niruvibes/elec3117proj/tmp/pdfs/designguideline-40.png

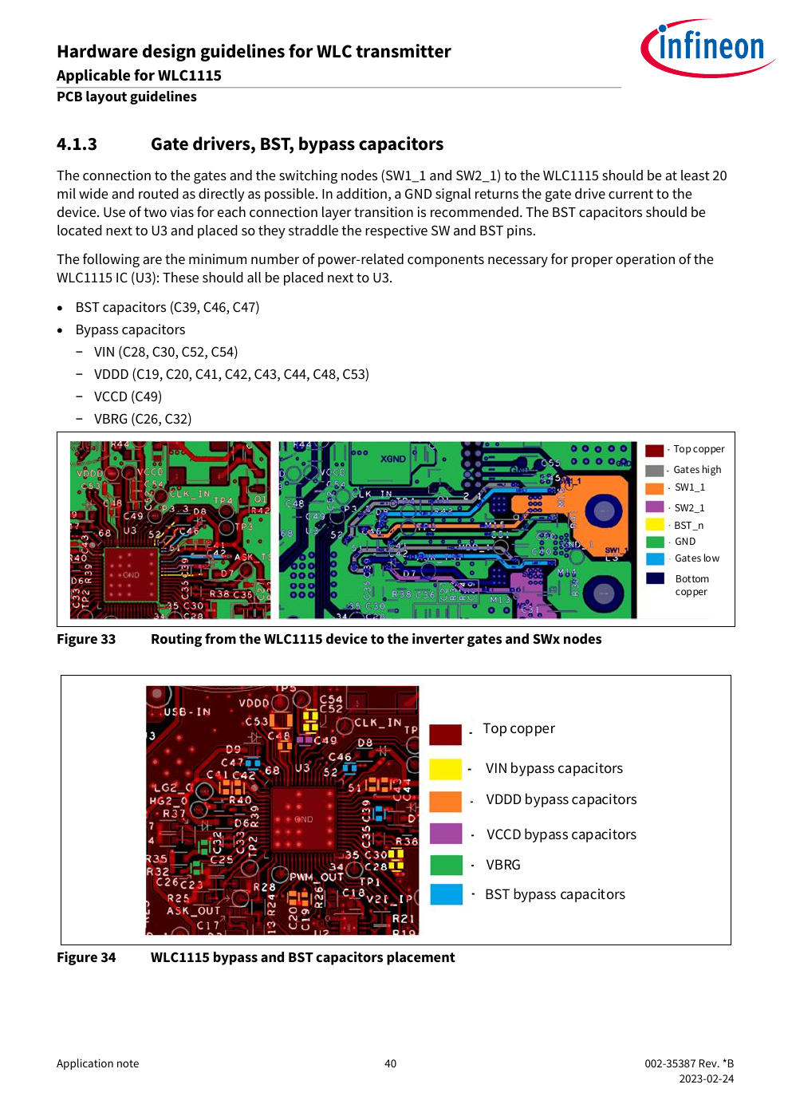
tmp/pdfs/designguideline-40.png
