niruvibes/elec3117proj/tmp/pdfs/guideline-power.jpg

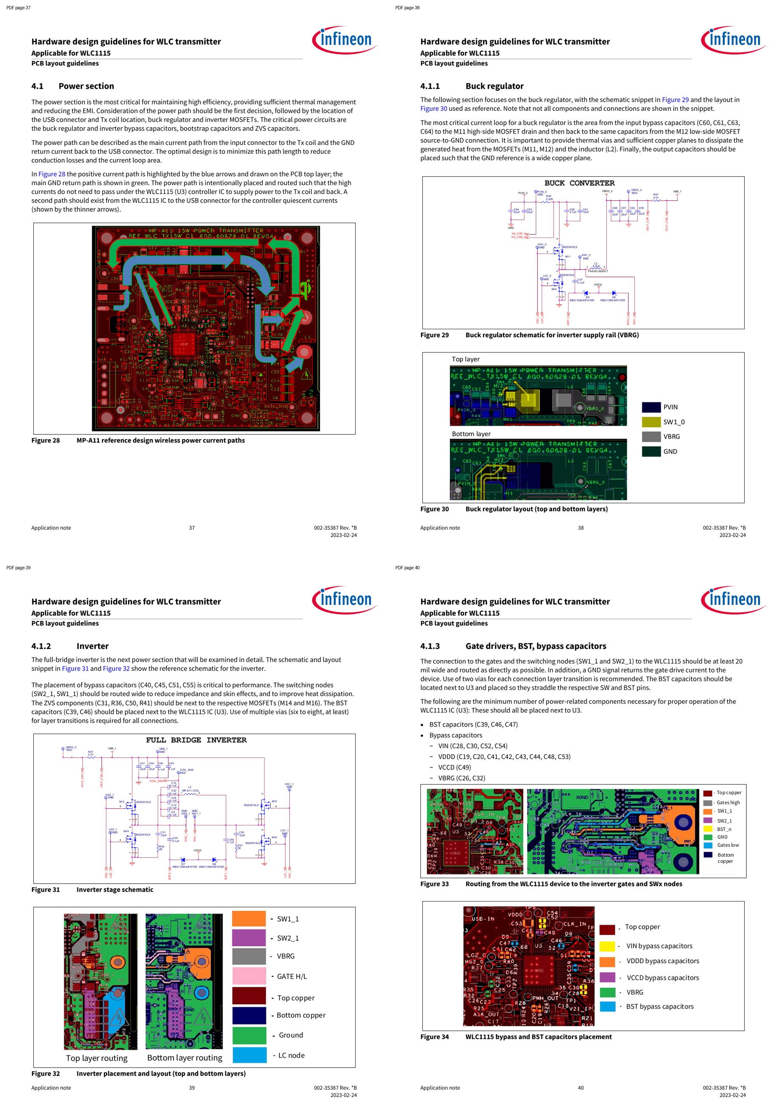
tmp/pdfs/guideline-power.jpg
