niruvibes/elec3117proj/outputs/jlcpcb-upload-clean/JLCPCB_CPL_clean.png

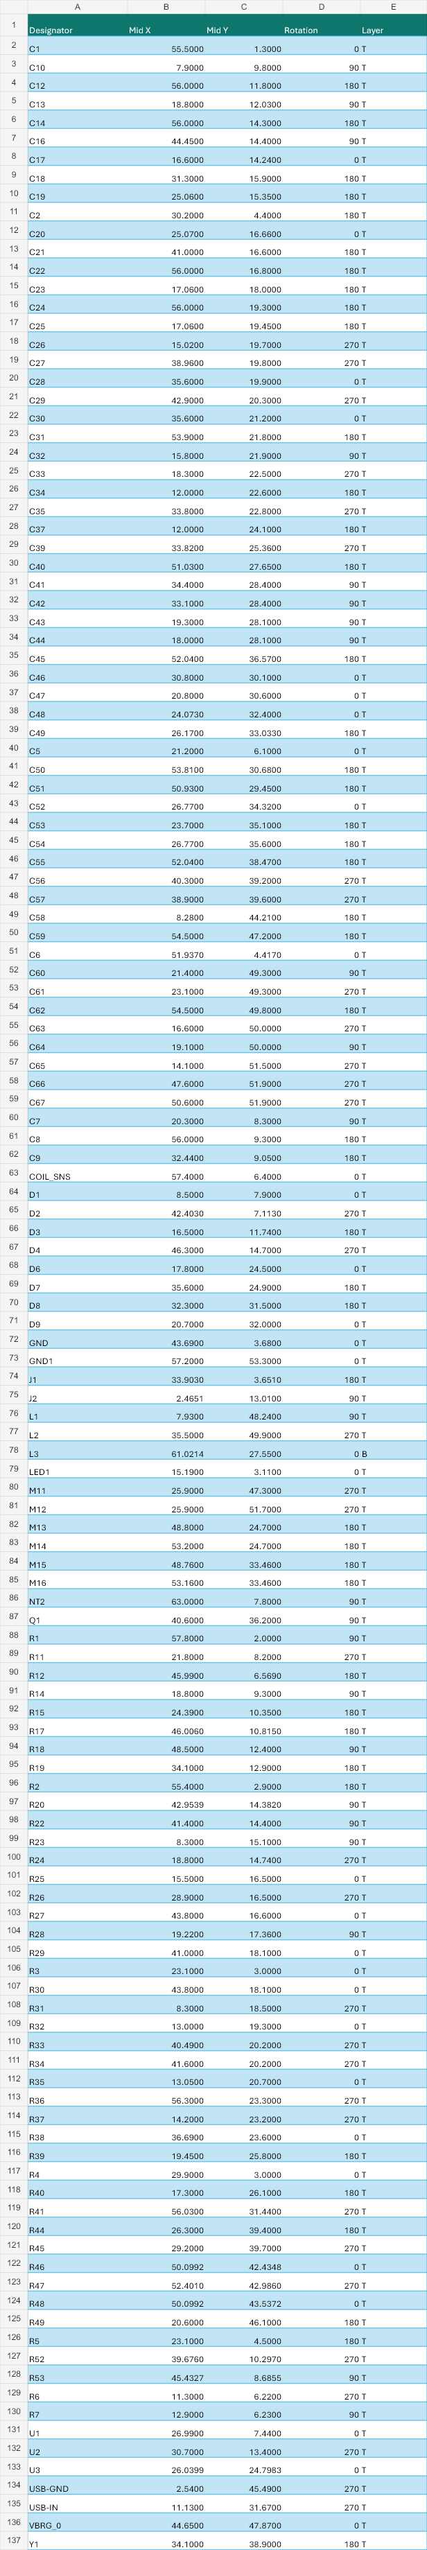
outputs/jlcpcb-upload-clean/JLCPCB_CPL_clean.png
