niruvibes/elec3117proj/outputs/jlcpcb-upload-clean/source_cpl.png

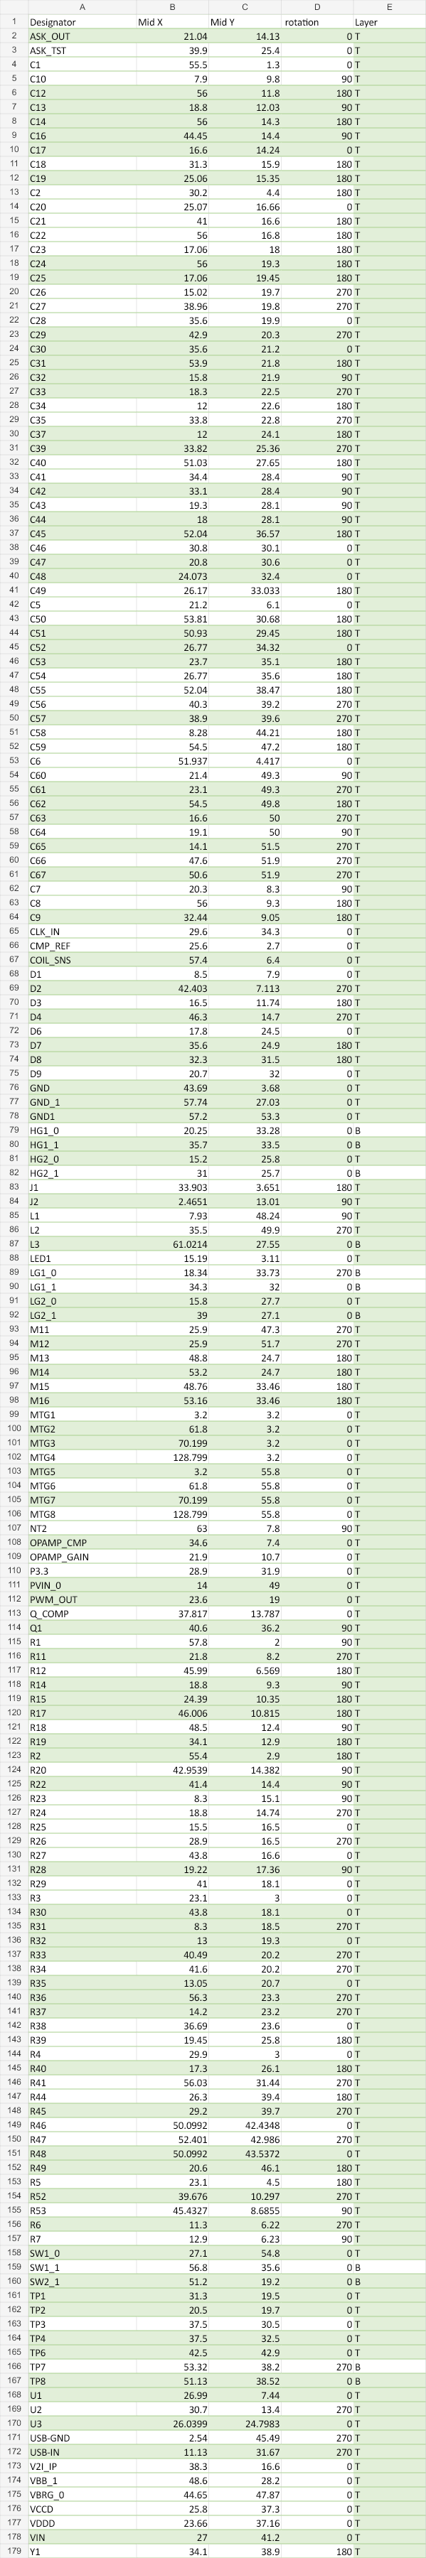
outputs/jlcpcb-upload-clean/source_cpl.png
