niruvibes/elec3117proj/tmp/layout-analysis/final-main-3d.png

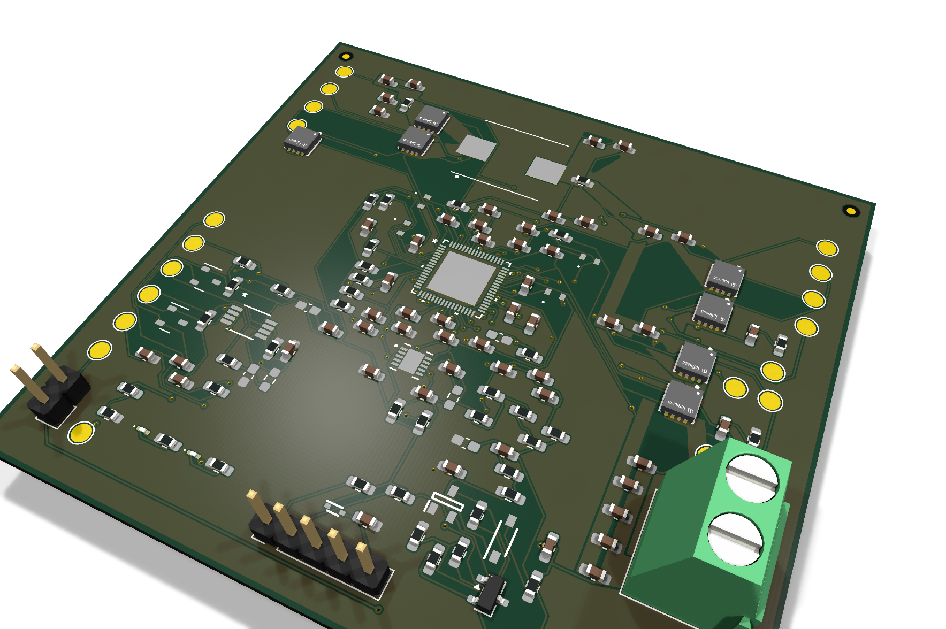
tmp/layout-analysis/final-main-3d.png
