niruvibes/elec3117proj/tmp/layout-analysis/final-main-top.png

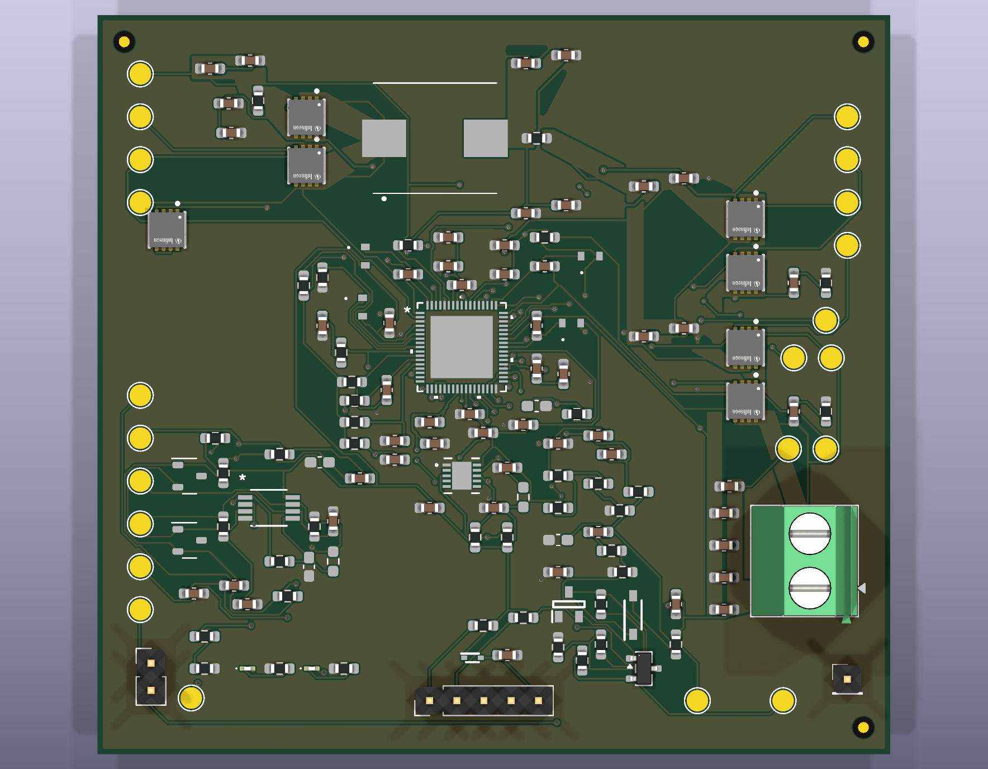
tmp/layout-analysis/final-main-top.png
