niruvibes/elec3117proj/tmp/layout-analysis/placed-3d.png

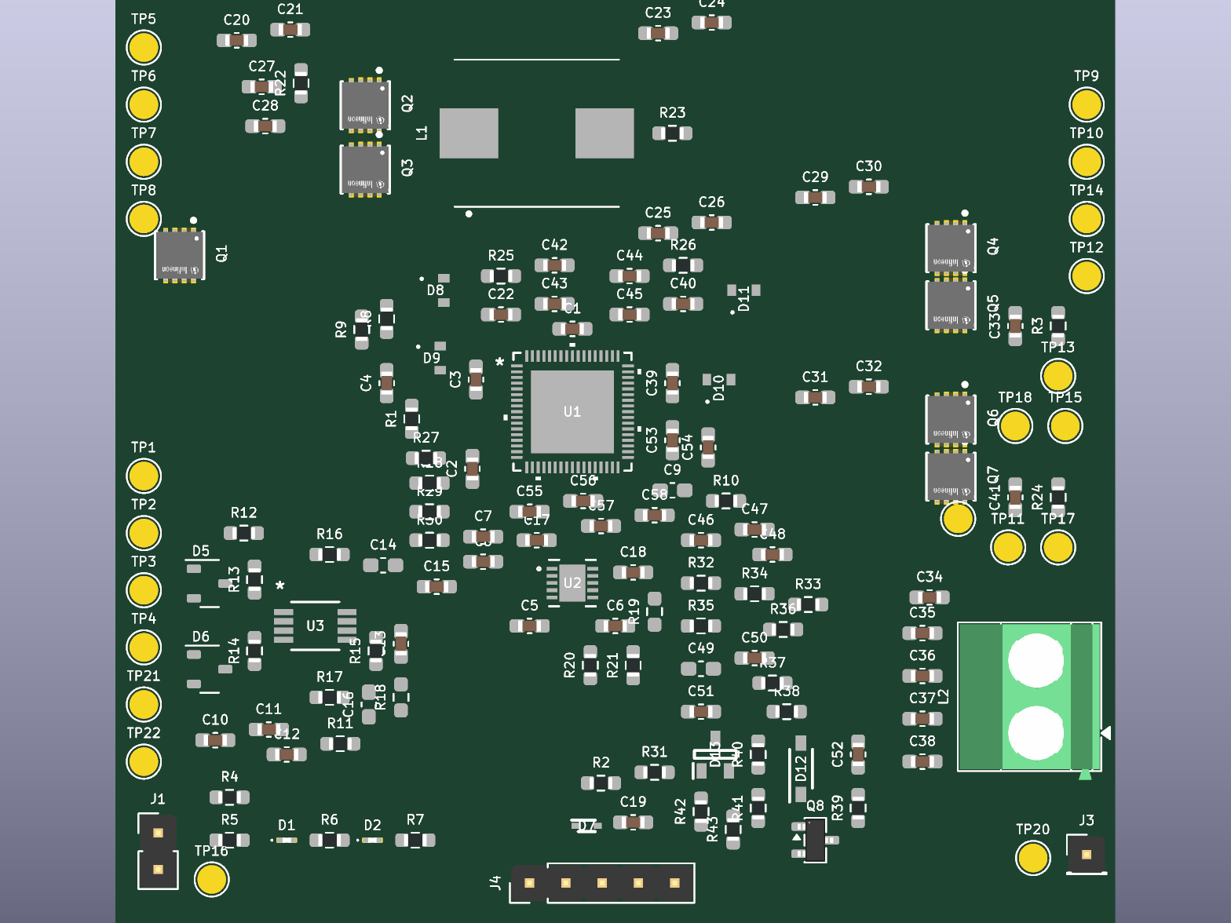
tmp/layout-analysis/placed-3d.png
