niruvibes/elec3117proj/tmp/pdfs/fab-1.png

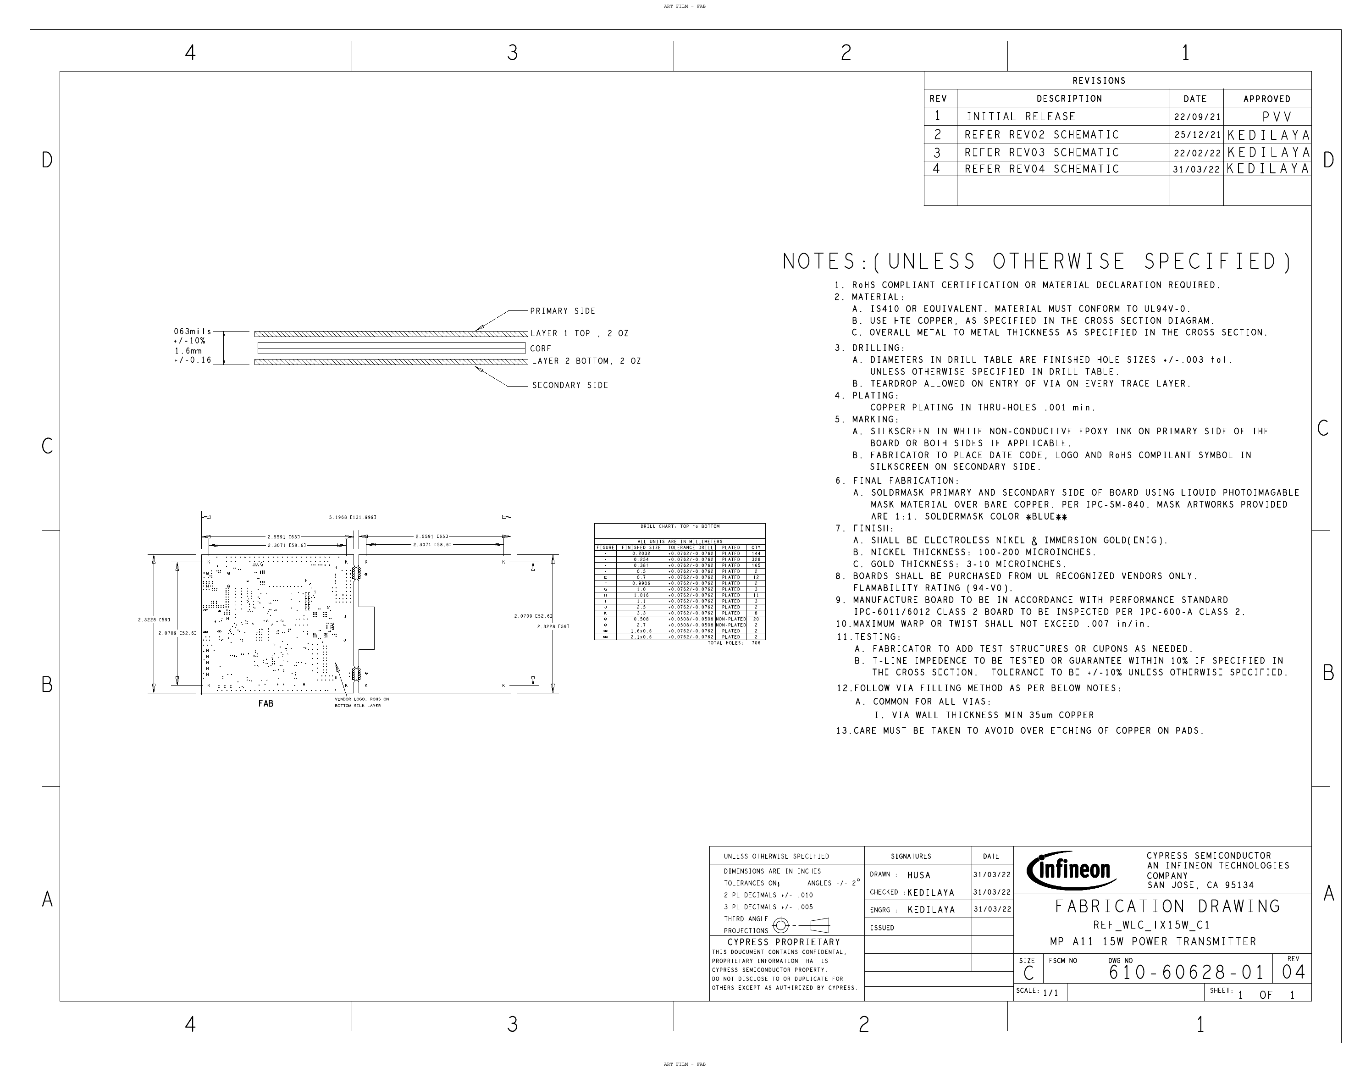
tmp/pdfs/fab-1.png
