niruvibes/elec3117proj/tmp/pdfs/fab-2.png

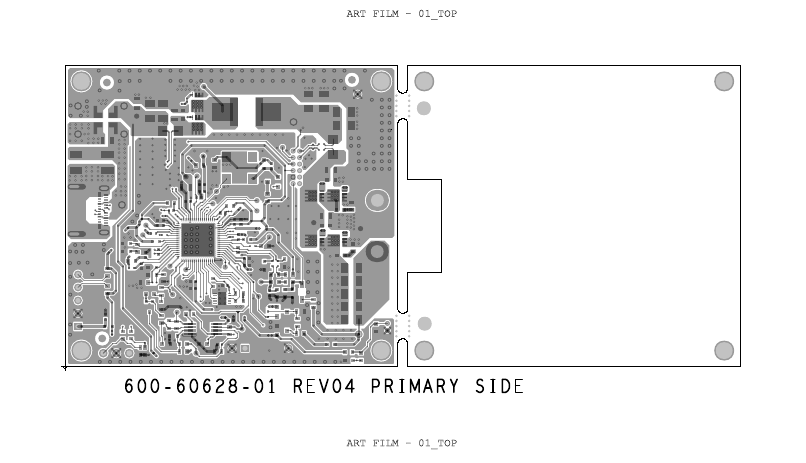
tmp/pdfs/fab-2.png
