niruvibes/elec3117proj/tmp/pdfs/fab-3.png

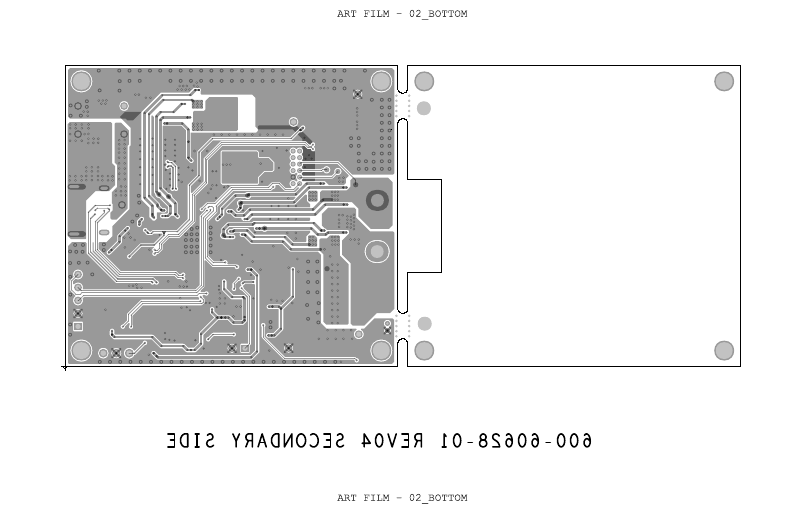
tmp/pdfs/fab-3.png
