niruvibes/elec3117proj/tmp/pdfs/fab-4.png

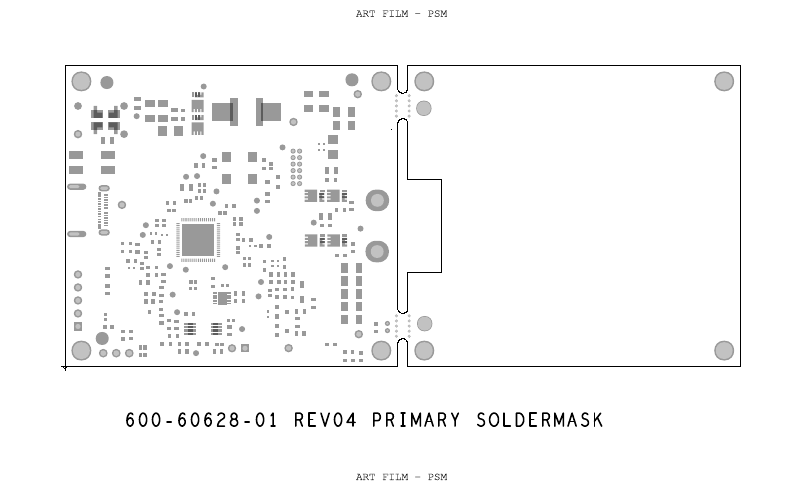
tmp/pdfs/fab-4.png
