niruvibes/elec3117proj/tmp/pdfs/fab-5.png

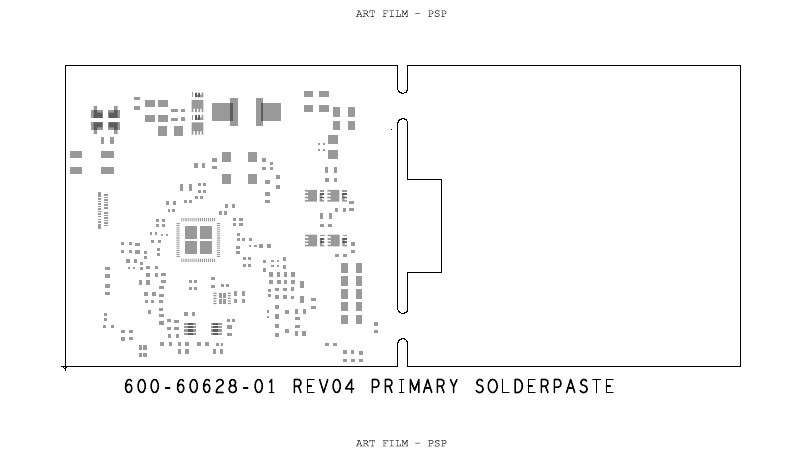
tmp/pdfs/fab-5.png
