niruvibes/elec3117proj/tmp/pdfs/fab-6.png

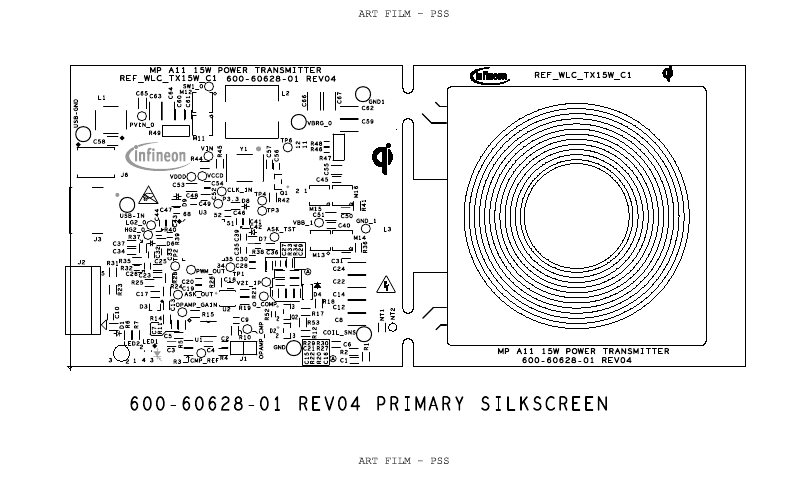
tmp/pdfs/fab-6.png
