niruvibes/elec3117proj/tmp/pdfs/fab-7.png

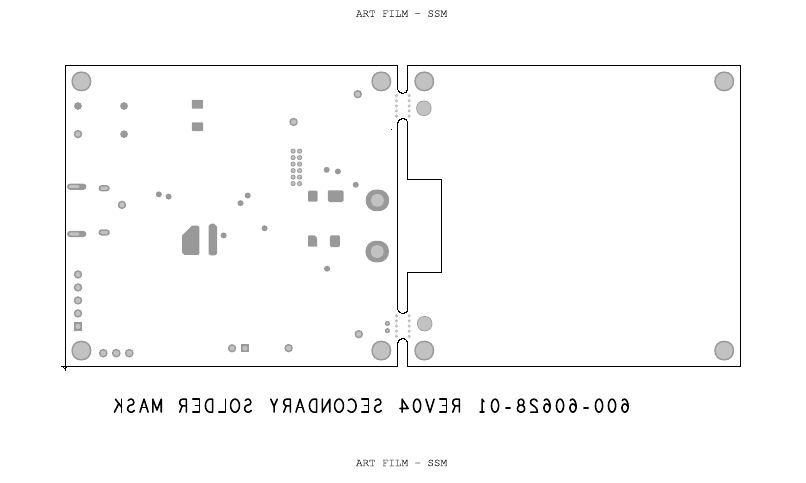
tmp/pdfs/fab-7.png
