niruvibes/elec3117proj/tmp/pdfs/fab-8.png

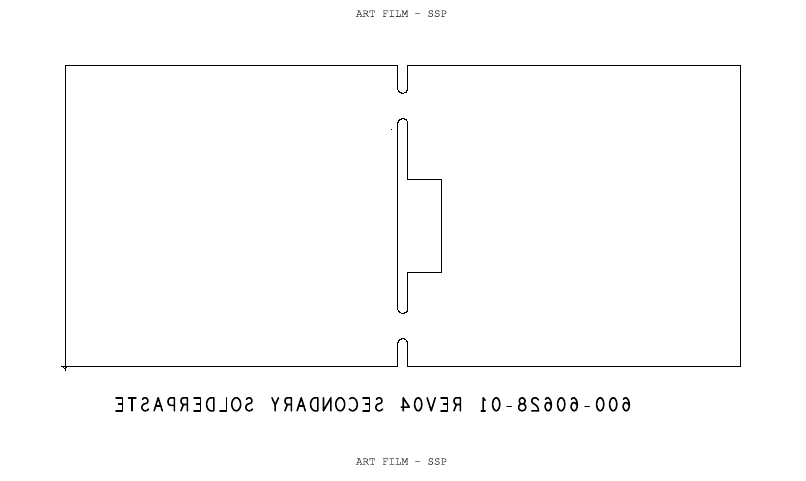
tmp/pdfs/fab-8.png
