niruvibes/elec3117proj/tmp/pdfs/fab-9.png

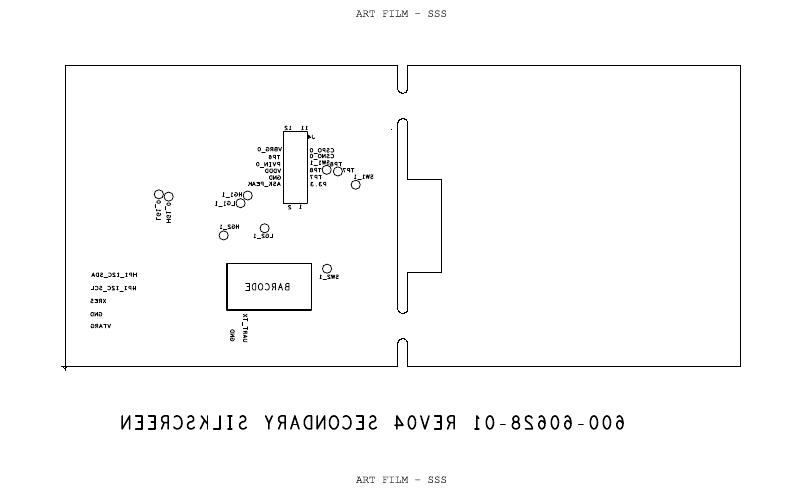
tmp/pdfs/fab-9.png
