niruvibes/elec3117proj/digikey_purchase_checklist.xlsx

Sheet: Purchase List
DigiKey purchase checklist
Every fitted order line is grouped by exact specification. Prepared 2026-07-21; update stock and prices at checkout. Rows marked CHECK are intentionally blocked.
Buy? | Category | Designators | Qty / board | Value / function | Package / footprint | Critical specification | Manufacturer | Recommended MPN | DigiKey cut-tape / order PN | DigiKey product/search link | Availability / validation note | Required qty | Spare % | Suggested buy qty | Unit price (AUD) | Estimated cost (AUD) | Order status | Received qty | Check | Notes / substitution guardrail
YES | Capacitor | C1,C5,C7,C13,C17,C19,C31,C32,C40,C43,C45,C50 | 12 | 100 nF | 0603 | 50 V, X7R, ±10% | YAGEO | CC0603KRX7R9BB104 |  | https://www.digikey.com/en/products/result?keywords=CC0603KRX7R9BB104 | Check live DigiKey stock | 12 | 20% | 15 |  |  | Not checked |  | PENDING
YES | Capacitor | C10,C12 | 2 | 22 nF | 0603 | 50 V, X7R, ±10% | YAGEO | CC0603KRX7R9BB223 |  | https://www.digikey.com/en/products/result?keywords=CC0603KRX7R9BB223 | Check live DigiKey stock | 2 | 20% | 3 |  |  | Not checked |  | PENDING
YES | Capacitor | C11 | 1 | 220 nF | 0603 | 25 V, X7R, ±10% | YAGEO | CC0603KRX7R8BB224 |  | https://www.digikey.com/en/products/result?keywords=CC0603KRX7R8BB224 | Check live DigiKey stock | 1 | 20% | 2 |  |  | Not checked |  | PENDING
YES | Capacitor | C15 | 1 | 150 pF | 0603 | 50 V, X7R, ±10% | YAGEO | CC0603KRX7R9BB151 | 311-4095-1-ND | https://www.digikey.com/en/products/detail/yageo/CC0603KRX7R9BB151/5883798 | Check live DigiKey stock | 1 | 20% | 2 |  |  | Not checked |  | PENDING
YES | Capacitor | C28,C33,C41,C46,C48 | 5 | 10 nF | 0603 | 50 V, X7R, ±10% | YAGEO | CC0603KRX7R9BB103 |  | https://www.digikey.com/en/products/result?keywords=CC0603KRX7R9BB103 | Check live DigiKey stock | 5 | 20% | 6 |  |  | Not checked |  | PENDING
YES | Capacitor | C6,C18,C42 | 3 | 1 µF | 0603 | 50 V, X5R, ±10% | Samsung Electro-Mechanics | CL10A105KB8NNNC |  | https://www.digikey.com/en/products/result?keywords=CL10A105KB8NNNC | Check live DigiKey stock | 3 | 20% | 4 |  |  | Not checked |  | PENDING
YES | Capacitor | C2 | 1 | 2.2 µF | 0603 | 16 V, X5R, ±10% | Samsung Electro-Mechanics | CL10A225KO8NNNC | 1276-1040-1-ND | https://www.digikey.com/en/products/detail/samsung-electro-mechanics/CL10A225KO8NNNC/3886698 | DigiKey listed; recheck stock at order time | 1 | 20% | 2 |  |  | Not checked |  | PENDING
YES | Capacitor | C20,C21,C23,C24,C25,C26 | 6 | 22 µF | 1206 | 25 V, X6S, ±10% | Samsung Electro-Mechanics | CL31X226KAHN3NE | 1276-3299-1-ND | https://www.digikey.com/en/products/result?keywords=CL31X226KAHN3NE | Check live DigiKey stock | 6 | 20% | 8 |  |  | Not checked |  | PENDING
YES | Capacitor | C8,C22,C39,C55,C57 | 5 | 100 nF | 0402 | 16 V, X7R, ±10% | YAGEO | CC0402KRX7R7BB104 |  | https://www.digikey.com/en/products/result?keywords=CC0402KRX7R7BB104 | Check live DigiKey stock | 5 | 20% | 6 |  |  | Not checked |  | PENDING
YES | Capacitor | C53,C54 | 2 | 100 nF | 0402 | 50 V, X7R, ±10% | YAGEO | CC0402KRX7R9BB104 |  | https://www.digikey.com/en/products/result?keywords=CC0402KRX7R9BB104 | Check live DigiKey stock | 2 | 20% | 3 |  |  | Not checked |  | PENDING | Kept separate from the 16 V group because these parts sit on PVIN (up to 24 V).
YES | Capacitor | C27 | 1 | 4.7 µF | 0805 | 25 V, X5R, ±10% | Samsung Electro-Mechanics | CL21A475KAQNNNE |  | https://www.digikey.com/en/products/result?keywords=CL21A475KAQNNNE | Check live DigiKey stock | 1 | 20% | 2 |  |  | Not checked |  | PENDING
YES | Capacitor | C29 | 1 | 22 µF | 0805 | 25 V, X5R, ±20% | YAGEO | CC0805MKX5R8BB226 |  | https://www.digikey.com/en/products/result?keywords=CC0805MKX5R8BB226 | Check live DigiKey stock | 1 | 20% | 2 |  |  | Not checked |  | PENDING
YES | Capacitor | C3 | 1 | 1 nF | 0603 | 50 V, X7R, ±10% | YAGEO | CC0603KRX7R9BB102 | 311-1080-1-ND | https://www.digikey.com/en/products/detail/yageo/CC0603KRX7R9BB102/302990 | Check live DigiKey stock | 1 | 20% | 2 |  |  | Not checked |  | PENDING
YES | Capacitor | C52 | 1 | 1 nF | 0603 | 100 V, X7R, ±10% | YAGEO | CC0603KRX7R0BB102 | 311-1467-1-ND | https://www.digikey.com/en/products/detail/yageo/CC0603KRX7R0BB102/2833632 | DigiKey listed; recheck stock at order time | 1 | 20% | 2 |  |  | Not checked |  | PENDING | Do not combine with C3: this reference needs the 100 V rating.
YES | Capacitor | C30 | 1 | 22 µF | 0603 | 6.3 V, X5R, ±20% | Samsung Electro-Mechanics | CL10A226MQ8NRNC |  | https://www.digikey.com/en/products/result?keywords=CL10A226MQ8NRNC | Check live DigiKey stock | 1 | 20% | 2 |  |  | Not checked |  | PENDING | Check effective capacitance under DC bias; use only on its low-voltage rail.
YES | Capacitor | C34,C35,C36,C37,C38 | 5 | 100 nF | 1206 | 100 V, C0G/NP0, ±5% | Murata | GRM31C5C2A104JA01L | 490-16315-1-ND | https://www.digikey.com/en/products/detail/murata-electronics/GRM31C5C2A104JA01L/7363059 | DigiKey listed; recheck stock at order time | 5 | 20% | 6 |  |  | Not checked |  | PENDING | CRITICAL resonant/bridge capacitors: keep 100 V, C0G/NP0, ±5%, 1206 unless the design is revalidated.
YES | Capacitor | C4 | 1 | 470 nF | 0603 | 25 V, X7R, ±10% | Samsung Electro-Mechanics | CL10B474KA8NNNC |  | https://www.digikey.com/en/products/result?keywords=CL10B474KA8NNNC | Check live DigiKey stock | 1 | 20% | 2 |  |  | Not checked |  | PENDING
YES | Capacitor | C44 | 1 | 1 µF | 0805 | 50 V, X7R, ±10% | Samsung Electro-Mechanics | CL21B105KBFNNNE |  | https://www.digikey.com/en/products/result?keywords=CL21B105KBFNNNE | Check live DigiKey stock | 1 | 20% | 2 |  |  | Not checked |  | PENDING
YES | Capacitor | C47 | 1 | 470 nF | 0402 | 10 V, X5R, ±10% | Samsung Electro-Mechanics | CL05A474KP5NNNC |  | https://www.digikey.com/en/products/result?keywords=CL05A474KP5NNNC | Check live DigiKey stock | 1 | 20% | 2 |  |  | Not checked |  | PENDING
YES | Capacitor | C51 | 1 | 5.6 nF | 0603 | 100 V, C0G/NP0, ±5% | TDK | C1608C0G2A562J080AC | 445-172659-1-ND | https://www.digikey.com/en/products/detail/tdk/C1608C0G2A562J080AC/5023337 | DigiKey listed; recheck stock at order time | 1 | 20% | 2 |  |  | Not checked |  | PENDING | CRITICAL: the original generic match was 50 V X7R; buy this 100 V C0G part instead.
YES | Capacitor | C56,C58 | 2 | 1 µF | 0402 | 25 V, X5R, ±10% | Samsung Electro-Mechanics | CL05A105KA5NQNC |  | https://www.digikey.com/en/products/result?keywords=CL05A105KA5NQNC | Check live DigiKey stock | 2 | 20% | 3 |  |  | Not checked |  | PENDING
YES | LED | D1,D2 | 2 | Red LED | 0201 (0603 metric) | Red, ~2 V, low-current indicator | Kingbright | APG0201SURC-TT | 754-APG0201SURC-TTCT-ND | https://www.digikey.com/en/products/detail/kingbright/APG0201SURC-TT/27491892 | DigiKey listed; recheck stock at order time | 2 | 10% | 3 |  |  | Not checked |  | PENDING | Physical size is 0201 imperial. Do not substitute the larger 0402 SML-P11 series.
YES | Diode | D8,D9,D10,D11 | 4 | Schottky diode | SOD-523 | 40 V, 100 mA | ROHM | RB511SM-40FHT2R |  | https://www.digikey.com/en/products/result?keywords=RB511SM-40FHT2R | Check live DigiKey stock | 4 | 10% | 5 |  |  | Not checked |  | PENDING | Keep the same SOD-523 footprint and polarity.
YES | Diode | D12 | 1 | Switching diode | SOD-123 | 100 V, fast switching | Micro Commercial | 1N4448W-TP |  | https://www.digikey.com/en/products/result?keywords=1N4448W-TP | Check live DigiKey stock | 1 | 10% | 2 |  |  | Not checked |  | PENDING | Confirm cathode orientation during assembly.
YES | Diode array | D13 | 1 | Dual switching diode | SOT-23 | Series-connected pair | onsemi | MMBD1503A |  | https://www.digikey.com/en/products/result?keywords=MMBD1503A | Check live DigiKey stock | 1 | 10% | 2 |  |  | Not checked |  | PENDING | Do not replace with an arbitrary dual diode: topology/pinout must match.
YES | Diode | D7 | 1 | Schottky diode | SOD-523 | 30 V class, low leakage | Diodes Incorporated | BAT64T5Q-7-F | 31-BAT64T5Q-7-FCT-ND | https://www.digikey.com/en/products/detail/diodes-incorporated/BAT64T5Q-7-F/10674161 | DigiKey listed; recheck stock at order time | 1 | 10% | 2 |  |  | Not checked |  | PENDING | Automotive-qualified exact MPN.
YES | Diode array | IC1 | 1 | Dual Schottky diode | SOT-23-6 | Series-connected pair, 30 V | Infineon | BAT5404WH6327XTSA1 | 448-BAT5404WH6327XTSA1CT-ND | https://www.digikey.com/en/products/detail/infineon-technologies/BAT5404WH6327XTSA1/2337537 | DigiKey listed; recheck stock at order time | 1 | 10% | 2 |  |  | Not checked |  | PENDING | Designator is IC1, but the device is a diode array.
YES | Inductor | L1 | 1 | 6.8 µH power inductor | 11.5 × 10.3 mm SMD | 13.5 A saturation class, low DCR | Pulse Electronics | PA4342.682NLT | 553-3442-1-ND | https://www.digikey.com/en/products/detail/pulse-electronics/PA4342-682NLT/6128273 | DigiKey listed; recheck stock at order time | 1 | 20% | 2 |  |  | Not checked |  | PENDING | Do not downrate current capability.
YES | MOSFET | Q2,Q3,Q4,Q5,Q6,Q7 | 6 | N-channel MOSFET | PG-TSDSON-8 | 30 V, very low RDS(on), power stage | Infineon | BSZ0902NSATMA1 | BSZ0902NSATMA1CT-ND | https://www.digikey.com/en/products/detail/infineon-technologies/BSZ0902NSATMA1/2783245 | DigiKey listed; recheck stock at order time | 6 | 10% | 7 |  |  | Not checked |  | PENDING | Use the full ordering code; layout and thermal pad must match.
YES | MOSFET | Q8 | 1 | N-channel MOSFET | SOT-23 | 60 V, logic-level small-signal | Infineon | BSS138NH6327XTSA2 | BSS138NH6327XTSA2CT-ND | https://www.digikey.com/en/products/detail/infineon-technologies/BSS138NH6327XTSA2/5413728 | Exact MPN showed no DigiKey stock on 2026-07-21 | 1 | 10% | 2 |  |  | Not checked |  | PENDING | Backorder or cross-reference only after checking 60 V rating, pinout and gate-drive suitability.
YES | Controller IC | U1 | 1 | Qi transmitter controller | PG-VQFN-68 | WLC1115, 4.5–24 V transmitter controller | Infineon | WLC1115-68LQXQ | 448-WLC1115-68LQXQ-ND | https://www.digikey.com/en/products/detail/infineon-technologies/WLC1115-68LQXQ/16676239 | Limited / last-time-buy listing; verify immediately | 1 | 10% | 2 |  |  | Not checked |  | PENDING | Special-order risk. Do not leave this until the rest of the order is complete.
CHECK | Secure element | U2 | 1 | Authentication IC | PG-USON-10-2 | Infineon OPTIGA Trust Charge family | Infineon | SLS32AIA020U2USON10XTMA2 |  | https://www.digikey.com/en/products/result?keywords=SLS32AIA020U2USON10XTMA2 | Suffix/source not confirmed at DigiKey | 1 | 10% | 0 |  |  | Not checked |  | HOLD | HOLD: schematic text appears to use XTMA1, while the Infineon hardware guide calls out XTMA2. Confirm the exact orderable suffix and provisioning before purchasing.
YES | Op amp | U3 | 1 | Dual operational amplifier | VSSOP-8 (DGK) | Automotive, rail-to-rail output, low-voltage | Texas Instruments | LMV358AQDGKRQ1 | 296-LMV358AQDGKRQ1CT-ND | https://www.digikey.com/en/products/detail/texas-instruments/LMV358AQDGKRQ1/14123996 | DigiKey listed; recheck stock at order time | 1 | 10% | 2 |  |  | Not checked |  | PENDING | Exact package suffix must remain DGK.
YES | Connector | J1,J2 | 2 | 1×2 right-angle male header | 2.54 mm pitch THT | Single row, right-angle, 2 positions | Samtec | TSW-102-08-L-S-RA | 612-TSW-102-08-L-S-RA-ND | https://www.digikey.com/en/products/detail/samtec-inc/TSW-102-08-L-S-RA/1102022 | DigiKey listed; recheck stock at order time | 2 | 0% | 2 |  |  | Not checked |  | PENDING | Mating housings/contacts are not included in this board BOM.
YES | Connector | J3 | 1 | 1×1 right-angle male header | 2.54 mm pitch THT | Single row, right-angle, 1 position | Samtec | TSW-101-08-T-S-RA |  | https://www.digikey.com/en/products/result?keywords=TSW-101-08-T-S-RA | Check live DigiKey stock | 1 | 0% | 1 |  |  | Not checked |  | PENDING | Tin-contact variant; verify the intended external connection.
CHECK | Connector | J4 | 1 | 1×5 right-angle male header | 2.54 mm pitch THT | Single row, right-angle, 5 positions | Samtec | TSW-105-08-L-S-RA |  | https://www.digikey.com/en/products/result?keywords=TSW-105-08-L-S-RA | Mechanical confirmation required | 1 | 0% | 0 |  |  | Not checked |  | HOLD | HOLD: the schematic symbol says socket, but the PCB footprint is a right-angle male pin header. Change CHECK to YES only after confirming which gender you want.
YES | Terminal block | L2 | 1 | 2-position terminal block | 5.08 mm pitch THT | Wire-to-board screw terminal | Phoenix Contact | 1715721 | 277-1263-ND | https://www.digikey.com/en/products/detail/phoenix-contact/1715721/260631 | DigiKey listed; recheck stock at order time | 1 | 0% | 1 |  |  | Not checked |  | PENDING | This is the PCB connection for the external transmitter coil; the coil itself is a separate line below.
YES | External coil | EXT-COIL | 1 | Qi MP-A11 transmitter coil | 50 × 50 mm class | 6.3 µH class, high-current wireless-power TX coil | Vishay Dale | IWTX5050CZEB6R3KF1 |  | https://www.digikey.com/en/products/result?keywords=IWTX5050CZEB6R3KF1 | Check whether DigiKey currently carries the exact reference coil | 1 | 0% | 1 |  |  | Not checked |  | PENDING | External to the PCB. Do not substitute solely by inductance: Qi class, geometry, shielding, resistance and current rating matter.
YES | Resistor | R1,R6,R7,R11 | 4 | 1 kΩ | 0603 | ±1%, 0.1 W | YAGEO | RC0603FR-071KL |  | https://www.digikey.com/en/products/result?keywords=RC0603FR-071KL | Check live DigiKey stock | 4 | 20% | 5 |  |  | Not checked |  | PENDING
YES | Resistor | R8,R9,R10,R30,R43 | 5 | 0 Ω jumper | 0402 | Jumper, 0.063 W class | YAGEO | RC0402JR-070RL |  | https://www.digikey.com/en/products/result?keywords=RC0402JR-070RL | Check live DigiKey stock | 5 | 20% | 6 |  |  | Not checked |  | PENDING
YES | Resistor | R12 | 1 | 27 kΩ | 0603 | ±1%, 0.1 W | YAGEO | RC0603FR-0727KL |  | https://www.digikey.com/en/products/result?keywords=RC0603FR-0727KL | Check live DigiKey stock | 1 | 20% | 2 |  |  | Not checked |  | PENDING
YES | Resistor | R2,R13,R20,R21,R31,R39 | 6 | 5.1 kΩ | 0603 | ±1%, 0.1 W | YAGEO | RC0603FR-075K1L |  | https://www.digikey.com/en/products/result?keywords=RC0603FR-075K1L | Check live DigiKey stock | 6 | 20% | 8 |  |  | Not checked |  | PENDING
YES | Resistor | R14 | 1 | 390 Ω | 0603 | ±1%, 0.1 W | YAGEO | RC0603FR-07390RL |  | https://www.digikey.com/en/products/result?keywords=RC0603FR-07390RL | Check live DigiKey stock | 1 | 20% | 2 |  |  | Not checked |  | PENDING
YES | Resistor | R15 | 1 | 10 kΩ | 0603 | ±1%, 0.1 W | YAGEO | RC0603FR-0710KL |  | https://www.digikey.com/en/products/result?keywords=RC0603FR-0710KL | Check live DigiKey stock | 1 | 20% | 2 |  |  | Not checked |  | PENDING | R19 has the same nominal value but is DNP and is excluded.
YES | Resistor | R16,R38 | 2 | 100 kΩ | 0603 | ±1%, 0.1 W | YAGEO | RC0603FR-07100KL |  | https://www.digikey.com/en/products/result?keywords=RC0603FR-07100KL | Check live DigiKey stock | 2 | 20% | 3 |  |  | Not checked |  | PENDING
YES | Resistor | R3,R17,R24,R25,R29,R37 | 6 | 0 Ω jumper | 0603 | Jumper, 0.1 W class | YAGEO | RC0603JR-070RL |  | https://www.digikey.com/en/products/result?keywords=RC0603JR-070RL | Check live DigiKey stock | 6 | 20% | 8 |  |  | Not checked |  | PENDING
YES | Current shunt | R22 | 1 | 5 mΩ | 1206 | ±1%, 1 W, ≤50 ppm/°C | Ohmite | PCS1206FR0050ET | 273-PCS1206FR0050ETCT-ND | https://www.digikey.com/en/products/detail/ohmite/PCS1206FR0050ET/10670858 | DigiKey listed; recheck stock at order time | 1 | 20% | 2 |  |  | Not checked |  | PENDING | CRITICAL current-sense part. Do not use the earlier LVT match with ±75 ppm/°C.
YES | Current shunt | R23 | 1 | 10 mΩ | 1206 | ±1%, 1 W, ≤50 ppm/°C | Stackpole Electronics | CSNL1206FT10L0 | CSNL1206FT10L0CT-ND | https://www.digikey.com/en/products/detail/stackpole-electronics-inc/CSNL1206FT10L0/5226371 | DigiKey listed; recheck stock at order time | 1 | 20% | 2 |  |  | Not checked |  | PENDING | CRITICAL current-sense part; retain low TCR and 1 W rating.
YES | Resistor | R27,R28 | 2 | 10 Ω | 0402 | ±1%, 0.063 W | YAGEO | RC0402FR-0710RL |  | https://www.digikey.com/en/products/result?keywords=RC0402FR-0710RL | Check live DigiKey stock | 2 | 20% | 3 |  |  | Not checked |  | PENDING
YES | Resistor | R32,R33 | 2 | 10 Ω | 0603 | ±1%, 0.1 W | YAGEO | RC0603FR-0710RL |  | https://www.digikey.com/en/products/result?keywords=RC0603FR-0710RL | Check live DigiKey stock | 2 | 20% | 3 |  |  | Not checked |  | PENDING
YES | Resistor | R34 | 1 | 62 Ω | 0603 | ±1%, 0.1 W | YAGEO | RC0603FR-0762RL |  | https://www.digikey.com/en/products/result?keywords=RC0603FR-0762RL | Check live DigiKey stock | 1 | 20% | 2 |  |  | Not checked |  | PENDING
YES | Resistor | R35 | 1 | 2.2 kΩ | 0603 | ±1%, 0.1 W | YAGEO | RC0603FR-072K2L |  | https://www.digikey.com/en/products/result?keywords=RC0603FR-072K2L | Check live DigiKey stock | 1 | 20% | 2 |  |  | Not checked |  | PENDING
YES | Resistor | R36 | 1 | 130 kΩ | 0603 | ±1%, 0.1 W | YAGEO | RC0603FR-07130KL |  | https://www.digikey.com/en/products/result?keywords=RC0603FR-07130KL | Check live DigiKey stock | 1 | 20% | 2 |  |  | Not checked |  | PENDING
YES | Resistor | R40 | 1 | 36 kΩ | 0603 | ±1%, 0.1 W | YAGEO | RC0603FR-0736KL |  | https://www.digikey.com/en/products/result?keywords=RC0603FR-0736KL | Check live DigiKey stock | 1 | 20% | 2 |  |  | Not checked |  | PENDING
YES | Resistor | R41 | 1 | 3.6 kΩ | 0603 | ±1%, 0.1 W | YAGEO | RC0603FR-073K6L |  | https://www.digikey.com/en/products/result?keywords=RC0603FR-073K6L | Check live DigiKey stock | 1 | 20% | 2 |  |  | Not checked |  | PENDING
YES | Resistor | R42 | 1 | 20 kΩ | 0603 | ±1%, 0.1 W | YAGEO | RC0603FR-0720KL |  | https://www.digikey.com/en/products/result?keywords=RC0603FR-0720KL | Check live DigiKey stock | 1 | 20% | 2 |  |  | Not checked |  | PENDING

Sheet: All Components
All components — one row per reference
Use this sheet to prove that every schematic/PCB reference is accounted for. Filter Buy Status to isolate fitted, held, DNP or PCB-only items.
Reference | Type | Value / function | Package / footprint | Purchase group | Recommended MPN | Buy status | Reason / note | Verified date
C1 | Capacitor | 100 nF | 0603 | CAP-01 | CC0603KRX7R9BB104 | Buy | Check live DigiKey stock | 2026-07-21
C2 | Capacitor | 2.2 µF | 0603 | CAP-07 | CL10A225KO8NNNC | Buy | DigiKey listed; recheck stock at order time | 2026-07-21
C3 | Capacitor | 1 nF | 0603 | CAP-13 | CC0603KRX7R9BB102 | Buy | Check live DigiKey stock | 2026-07-21
C4 | Capacitor | 470 nF | 0603 | CAP-17 | CL10B474KA8NNNC | Buy | Check live DigiKey stock | 2026-07-21
C5 | Capacitor | 100 nF | 0603 | CAP-01 | CC0603KRX7R9BB104 | Buy | Check live DigiKey stock | 2026-07-21
C6 | Capacitor | 1 µF | 0603 | CAP-06 | CL10A105KB8NNNC | Buy | Check live DigiKey stock | 2026-07-21
C7 | Capacitor | 100 nF | 0603 | CAP-01 | CC0603KRX7R9BB104 | Buy | Check live DigiKey stock | 2026-07-21
C8 | Capacitor | 100 nF | 0402 | CAP-09 | CC0402KRX7R7BB104 | Buy | Check live DigiKey stock | 2026-07-21
C9 | Capacitor | 10 pF | 0402 | DNP | CC0402JRNPO9BN100 | DNP — do not buy | Marked do-not-populate in schematic. | 2026-07-21
C10 | Capacitor | 22 nF | 0603 | CAP-02 | CC0603KRX7R9BB223 | Buy | Check live DigiKey stock | 2026-07-21
C11 | Capacitor | 220 nF | 0603 | CAP-03 | CC0603KRX7R8BB224 | Buy | Check live DigiKey stock | 2026-07-21
C12 | Capacitor | 22 nF | 0603 | CAP-02 | CC0603KRX7R9BB223 | Buy | Check live DigiKey stock | 2026-07-21
C13 | Capacitor | 100 nF | 0603 | CAP-01 | CC0603KRX7R9BB104 | Buy | Check live DigiKey stock | 2026-07-21
C14 | Capacitor | 330 pF | 0603 | DNP | CC0603JRNPO9BN331 | DNP — do not buy | Marked do-not-populate in schematic. | 2026-07-21
C15 | Capacitor | 150 pF | 0603 | CAP-04 | CC0603KRX7R9BB151 | Buy | Check live DigiKey stock | 2026-07-21
C16 | Capacitor | 10 nF | 0603 | DNP | CC0603KRX7R9BB103 | DNP — do not buy | Marked do-not-populate in schematic; active 10 nF group excludes it. | 2026-07-21
C17 | Capacitor | 100 nF | 0603 | CAP-01 | CC0603KRX7R9BB104 | Buy | Check live DigiKey stock | 2026-07-21
C18 | Capacitor | 1 µF | 0603 | CAP-06 | CL10A105KB8NNNC | Buy | Check live DigiKey stock | 2026-07-21
C19 | Capacitor | 100 nF | 0603 | CAP-01 | CC0603KRX7R9BB104 | Buy | Check live DigiKey stock | 2026-07-21
C20 | Capacitor | 22 µF | 1206 | CAP-08 | CL31X226KAHN3NE | Buy | Check live DigiKey stock | 2026-07-21
C21 | Capacitor | 22 µF | 1206 | CAP-08 | CL31X226KAHN3NE | Buy | Check live DigiKey stock | 2026-07-21
C22 | Capacitor | 100 nF | 0402 | CAP-09 | CC0402KRX7R7BB104 | Buy | Check live DigiKey stock | 2026-07-21
C23 | Capacitor | 22 µF | 1206 | CAP-08 | CL31X226KAHN3NE | Buy | Check live DigiKey stock | 2026-07-21
C24 | Capacitor | 22 µF | 1206 | CAP-08 | CL31X226KAHN3NE | Buy | Check live DigiKey stock | 2026-07-21
C25 | Capacitor | 22 µF | 1206 | CAP-08 | CL31X226KAHN3NE | Buy | Check live DigiKey stock | 2026-07-21
C26 | Capacitor | 22 µF | 1206 | CAP-08 | CL31X226KAHN3NE | Buy | Check live DigiKey stock | 2026-07-21
C27 | Capacitor | 4.7 µF | 0805 | CAP-11 | CL21A475KAQNNNE | Buy | Check live DigiKey stock | 2026-07-21
C28 | Capacitor | 10 nF | 0603 | CAP-05 | CC0603KRX7R9BB103 | Buy | Check live DigiKey stock | 2026-07-21
C29 | Capacitor | 22 µF | 0805 | CAP-12 | CC0805MKX5R8BB226 | Buy | Check live DigiKey stock | 2026-07-21
C30 | Capacitor | 22 µF | 0603 | CAP-15 | CL10A226MQ8NRNC | Buy | Check effective capacitance under DC bias; use only on its low-voltage rail. | 2026-07-21
C31 | Capacitor | 100 nF | 0603 | CAP-01 | CC0603KRX7R9BB104 | Buy | Check live DigiKey stock | 2026-07-21
C32 | Capacitor | 100 nF | 0603 | CAP-01 | CC0603KRX7R9BB104 | Buy | Check live DigiKey stock | 2026-07-21
C33 | Capacitor | 10 nF | 0603 | CAP-05 | CC0603KRX7R9BB103 | Buy | Check live DigiKey stock | 2026-07-21
C34 | Capacitor | 100 nF | 1206 | CAP-16 | GRM31C5C2A104JA01L | Buy | CRITICAL resonant/bridge capacitors: keep 100 V, C0G/NP0, ±5%, 1206 unless the design is revalidated. | 2026-07-21
C35 | Capacitor | 100 nF | 1206 | CAP-16 | GRM31C5C2A104JA01L | Buy | CRITICAL resonant/bridge capacitors: keep 100 V, C0G/NP0, ±5%, 1206 unless the design is revalidated. | 2026-07-21
C36 | Capacitor | 100 nF | 1206 | CAP-16 | GRM31C5C2A104JA01L | Buy | CRITICAL resonant/bridge capacitors: keep 100 V, C0G/NP0, ±5%, 1206 unless the design is revalidated. | 2026-07-21
C37 | Capacitor | 100 nF | 1206 | CAP-16 | GRM31C5C2A104JA01L | Buy | CRITICAL resonant/bridge capacitors: keep 100 V, C0G/NP0, ±5%, 1206 unless the design is revalidated. | 2026-07-21
C38 | Capacitor | 100 nF | 1206 | CAP-16 | GRM31C5C2A104JA01L | Buy | CRITICAL resonant/bridge capacitors: keep 100 V, C0G/NP0, ±5%, 1206 unless the design is revalidated. | 2026-07-21
C39 | Capacitor | 100 nF | 0402 | CAP-09 | CC0402KRX7R7BB104 | Buy | Check live DigiKey stock | 2026-07-21
C40 | Capacitor | 100 nF | 0603 | CAP-01 | CC0603KRX7R9BB104 | Buy | Check live DigiKey stock | 2026-07-21
C41 | Capacitor | 10 nF | 0603 | CAP-05 | CC0603KRX7R9BB103 | Buy | Check live DigiKey stock | 2026-07-21
C42 | Capacitor | 1 µF | 0603 | CAP-06 | CL10A105KB8NNNC | Buy | Check live DigiKey stock | 2026-07-21
C43 | Capacitor | 100 nF | 0603 | CAP-01 | CC0603KRX7R9BB104 | Buy | Check live DigiKey stock | 2026-07-21
C44 | Capacitor | 1 µF | 0805 | CAP-18 | CL21B105KBFNNNE | Buy | Check live DigiKey stock | 2026-07-21
C45 | Capacitor | 100 nF | 0603 | CAP-01 | CC0603KRX7R9BB104 | Buy | Check live DigiKey stock | 2026-07-21
C46 | Capacitor | 10 nF | 0603 | CAP-05 | CC0603KRX7R9BB103 | Buy | Check live DigiKey stock | 2026-07-21
C47 | Capacitor | 470 nF | 0402 | CAP-19 | CL05A474KP5NNNC | Buy | Check live DigiKey stock | 2026-07-21
C48 | Capacitor | 10 nF | 0603 | CAP-05 | CC0603KRX7R9BB103 | Buy | Check live DigiKey stock | 2026-07-21
C49 | Capacitor | 100 nF | 0603 | DNP | CC0603KRX7R9BB104 | DNP — do not buy | Marked do-not-populate in schematic; active 100 nF group excludes it. | 2026-07-21
C50 | Capacitor | 100 nF | 0603 | CAP-01 | CC0603KRX7R9BB104 | Buy | Check live DigiKey stock | 2026-07-21
C51 | Capacitor | 5.6 nF | 0603 | CAP-20 | C1608C0G2A562J080AC | Buy | CRITICAL: the original generic match was 50 V X7R; buy this 100 V C0G part instead. | 2026-07-21
C52 | Capacitor | 1 nF | 0603 | CAP-14 | CC0603KRX7R0BB102 | Buy | Do not combine with C3: this reference needs the 100 V rating. | 2026-07-21
C53 | Capacitor | 100 nF | 0402 | CAP-10 | CC0402KRX7R9BB104 | Buy | Kept separate from the 16 V group because these parts sit on PVIN (up to 24 V). | 2026-07-21
C54 | Capacitor | 100 nF | 0402 | CAP-10 | CC0402KRX7R9BB104 | Buy | Kept separate from the 16 V group because these parts sit on PVIN (up to 24 V). | 2026-07-21
C55 | Capacitor | 100 nF | 0402 | CAP-09 | CC0402KRX7R7BB104 | Buy | Check live DigiKey stock | 2026-07-21
C56 | Capacitor | 1 µF | 0402 | CAP-21 | CL05A105KA5NQNC | Buy | Check live DigiKey stock | 2026-07-21
C57 | Capacitor | 100 nF | 0402 | CAP-09 | CC0402KRX7R7BB104 | Buy | Check live DigiKey stock | 2026-07-21
C58 | Capacitor | 1 µF | 0402 | CAP-21 | CL05A105KA5NQNC | Buy | Check live DigiKey stock | 2026-07-21
D1 | Diode / LED | Red LED | 0201 (0603 metric) | LED-01 | APG0201SURC-TT | Buy | Physical size is 0201 imperial. Do not substitute the larger 0402 SML-P11 series. | 2026-07-21
D2 | Diode / LED | Red LED | 0201 (0603 metric) | LED-01 | APG0201SURC-TT | Buy | Physical size is 0201 imperial. Do not substitute the larger 0402 SML-P11 series. | 2026-07-21
D7 | Diode / LED | Schottky diode | SOD-523 | DIO-04 | BAT64T5Q-7-F | Buy | Automotive-qualified exact MPN. | 2026-07-21
D8 | Diode / LED | Schottky diode | SOD-523 | DIO-01 | RB511SM-40FHT2R | Buy | Keep the same SOD-523 footprint and polarity. | 2026-07-21
D9 | Diode / LED | Schottky diode | SOD-523 | DIO-01 | RB511SM-40FHT2R | Buy | Keep the same SOD-523 footprint and polarity. | 2026-07-21
D10 | Diode / LED | Schottky diode | SOD-523 | DIO-01 | RB511SM-40FHT2R | Buy | Keep the same SOD-523 footprint and polarity. | 2026-07-21
D11 | Diode / LED | Schottky diode | SOD-523 | DIO-01 | RB511SM-40FHT2R | Buy | Keep the same SOD-523 footprint and polarity. | 2026-07-21
D12 | Diode / LED | Switching diode | SOD-123 | DIO-02 | 1N4448W-TP | Buy | Confirm cathode orientation during assembly. | 2026-07-21
D13 | Diode / LED | Dual switching diode | SOT-23 | DIO-03 | MMBD1503A | Buy | Do not replace with an arbitrary dual diode: topology/pinout must match. | 2026-07-21
EXT-COIL | External / other | Qi MP-A11 transmitter coil | 50 × 50 mm class | EXT-01 | IWTX5050CZEB6R3KF1 | Buy | External to the PCB. Do not substitute solely by inductance: Qi class, geometry, shielding, resistance and current rating matter. | 2026-07-21
H1 | Mounting hole | M3 mounting hole | NPTH PCB feature | PCB-only |  | PCB-only — no part | The holes are fabricated in the PCB. Screws/spacers are optional mechanical hardware, not PCB components. | 2026-07-21
H2 | Mounting hole | M3 mounting hole | NPTH PCB feature | PCB-only |  | PCB-only — no part | The holes are fabricated in the PCB. Screws/spacers are optional mechanical hardware, not PCB components. | 2026-07-21
H3 | Mounting hole | M3 mounting hole | NPTH PCB feature | PCB-only |  | PCB-only — no part | The holes are fabricated in the PCB. Screws/spacers are optional mechanical hardware, not PCB components. | 2026-07-21
H4 | Mounting hole | M3 mounting hole | NPTH PCB feature | PCB-only |  | PCB-only — no part | The holes are fabricated in the PCB. Screws/spacers are optional mechanical hardware, not PCB components. | 2026-07-21
IC1 | Diode array | Dual Schottky diode | SOT-23-6 | DIO-05 | BAT5404WH6327XTSA1 | Buy | Designator is IC1, but the device is a diode array. | 2026-07-21
J1 | Connector | 1×2 right-angle male header | 2.54 mm pitch THT | CON-01 | TSW-102-08-L-S-RA | Buy | Mating housings/contacts are not included in this board BOM. | 2026-07-21
J2 | Connector | 1×2 right-angle male header | 2.54 mm pitch THT | CON-01 | TSW-102-08-L-S-RA | Buy | Mating housings/contacts are not included in this board BOM. | 2026-07-21
J3 | Connector | 1×1 right-angle male header | 2.54 mm pitch THT | CON-02 | TSW-101-08-T-S-RA | Buy | Tin-contact variant; verify the intended external connection. | 2026-07-21
J4 | Connector | 1×5 right-angle male header | 2.54 mm pitch THT | CON-03 | TSW-105-08-L-S-RA | Check before buying | HOLD: the schematic symbol says socket, but the PCB footprint is a right-angle male pin header. Change CHECK to YES only after confirming which gender you want. | 2026-07-21
J5 | Connector | Solder-wire connection | PCB copper pads | PCB-only |  | PCB-only — no part | The footprint is only solder pads. Wire is external/assembly material if required. | 2026-07-21
L1 | Inductor / coil connection | 6.8 µH power inductor | 11.5 × 10.3 mm SMD | IND-01 | PA4342.682NLT | Buy | Do not downrate current capability. | 2026-07-21
L2 | Inductor / coil connection | 2-position terminal block | 5.08 mm pitch THT | CON-04 | 1715721 | Buy | This is the PCB connection for the external transmitter coil; the coil itself is a separate line below. | 2026-07-21
Q2 | MOSFET | N-channel MOSFET | PG-TSDSON-8 | MOS-01 | BSZ0902NSATMA1 | Buy | Use the full ordering code; layout and thermal pad must match. | 2026-07-21
Q3 | MOSFET | N-channel MOSFET | PG-TSDSON-8 | MOS-01 | BSZ0902NSATMA1 | Buy | Use the full ordering code; layout and thermal pad must match. | 2026-07-21
Q4 | MOSFET | N-channel MOSFET | PG-TSDSON-8 | MOS-01 | BSZ0902NSATMA1 | Buy | Use the full ordering code; layout and thermal pad must match. | 2026-07-21
Q5 | MOSFET | N-channel MOSFET | PG-TSDSON-8 | MOS-01 | BSZ0902NSATMA1 | Buy | Use the full ordering code; layout and thermal pad must match. | 2026-07-21
Q6 | MOSFET | N-channel MOSFET | PG-TSDSON-8 | MOS-01 | BSZ0902NSATMA1 | Buy | Use the full ordering code; layout and thermal pad must match. | 2026-07-21
Q7 | MOSFET | N-channel MOSFET | PG-TSDSON-8 | MOS-01 | BSZ0902NSATMA1 | Buy | Use the full ordering code; layout and thermal pad must match. | 2026-07-21
Q8 | MOSFET | N-channel MOSFET | SOT-23 | MOS-02 | BSS138NH6327XTSA2 | Buy | Backorder or cross-reference only after checking 60 V rating, pinout and gate-drive suitability. | 2026-07-21
R1 | Resistor | 1 kΩ | 0603 | RES-01 | RC0603FR-071KL | Buy | Check live DigiKey stock | 2026-07-21
R2 | Resistor | 5.1 kΩ | 0603 | RES-04 | RC0603FR-075K1L | Buy | Check live DigiKey stock | 2026-07-21
R3 | Resistor | 0 Ω jumper | 0603 | RES-08 | RC0603JR-070RL | Buy | Check live DigiKey stock | 2026-07-21
R6 | Resistor | 1 kΩ | 0603 | RES-01 | RC0603FR-071KL | Buy | Check live DigiKey stock | 2026-07-21
R7 | Resistor | 1 kΩ | 0603 | RES-01 | RC0603FR-071KL | Buy | Check live DigiKey stock | 2026-07-21
R8 | Resistor | 0 Ω jumper | 0402 | RES-02 | RC0402JR-070RL | Buy | Check live DigiKey stock | 2026-07-21
R9 | Resistor | 0 Ω jumper | 0402 | RES-02 | RC0402JR-070RL | Buy | Check live DigiKey stock | 2026-07-21
R10 | Resistor | 0 Ω jumper | 0402 | RES-02 | RC0402JR-070RL | Buy | Check live DigiKey stock | 2026-07-21
R11 | Resistor | 1 kΩ | 0603 | RES-01 | RC0603FR-071KL | Buy | Check live DigiKey stock | 2026-07-21
R12 | Resistor | 27 kΩ | 0603 | RES-03 | RC0603FR-0727KL | Buy | Check live DigiKey stock | 2026-07-21
R13 | Resistor | 5.1 kΩ | 0603 | RES-04 | RC0603FR-075K1L | Buy | Check live DigiKey stock | 2026-07-21
R14 | Resistor | 390 Ω | 0603 | RES-05 | RC0603FR-07390RL | Buy | Check live DigiKey stock | 2026-07-21
R15 | Resistor | 10 kΩ | 0603 | RES-06 | RC0603FR-0710KL | Buy | R19 has the same nominal value but is DNP and is excluded. | 2026-07-21
R16 | Resistor | 100 kΩ | 0603 | RES-07 | RC0603FR-07100KL | Buy | Check live DigiKey stock | 2026-07-21
R17 | Resistor | 0 Ω jumper | 0603 | RES-08 | RC0603JR-070RL | Buy | Check live DigiKey stock | 2026-07-21
R18 | Resistor | 1 MΩ | 0603 | DNP | RC0603FR-071ML | DNP — do not buy | Marked do-not-populate in schematic. | 2026-07-21
R19 | Resistor | 10 kΩ | 0603 | DNP | RC0603FR-0710KL | DNP — do not buy | Marked do-not-populate in schematic; R15 is still fitted. | 2026-07-21
R20 | Resistor | 5.1 kΩ | 0603 | RES-04 | RC0603FR-075K1L | Buy | Check live DigiKey stock | 2026-07-21
R21 | Resistor | 5.1 kΩ | 0603 | RES-04 | RC0603FR-075K1L | Buy | Check live DigiKey stock | 2026-07-21
R22 | Resistor | 5 mΩ | 1206 | RES-09 | PCS1206FR0050ET | Buy | CRITICAL current-sense part. Do not use the earlier LVT match with ±75 ppm/°C. | 2026-07-21
R23 | Resistor | 10 mΩ | 1206 | RES-10 | CSNL1206FT10L0 | Buy | CRITICAL current-sense part; retain low TCR and 1 W rating. | 2026-07-21
R24 | Resistor | 0 Ω jumper | 0603 | RES-08 | RC0603JR-070RL | Buy | Check live DigiKey stock | 2026-07-21
R25 | Resistor | 0 Ω jumper | 0603 | RES-08 | RC0603JR-070RL | Buy | Check live DigiKey stock | 2026-07-21
R27 | Resistor | 10 Ω | 0402 | RES-11 | RC0402FR-0710RL | Buy | Check live DigiKey stock | 2026-07-21
R28 | Resistor | 10 Ω | 0402 | RES-11 | RC0402FR-0710RL | Buy | Check live DigiKey stock | 2026-07-21
R29 | Resistor | 0 Ω jumper | 0603 | RES-08 | RC0603JR-070RL | Buy | Check live DigiKey stock | 2026-07-21
R30 | Resistor | 0 Ω jumper | 0402 | RES-02 | RC0402JR-070RL | Buy | Check live DigiKey stock | 2026-07-21
R31 | Resistor | 5.1 kΩ | 0603 | RES-04 | RC0603FR-075K1L | Buy | Check live DigiKey stock | 2026-07-21
R32 | Resistor | 10 Ω | 0603 | RES-12 | RC0603FR-0710RL | Buy | Check live DigiKey stock | 2026-07-21
R33 | Resistor | 10 Ω | 0603 | RES-12 | RC0603FR-0710RL | Buy | Check live DigiKey stock | 2026-07-21
R34 | Resistor | 62 Ω | 0603 | RES-13 | RC0603FR-0762RL | Buy | Check live DigiKey stock | 2026-07-21
R35 | Resistor | 2.2 kΩ | 0603 | RES-14 | RC0603FR-072K2L | Buy | Check live DigiKey stock | 2026-07-21
R36 | Resistor | 130 kΩ | 0603 | RES-15 | RC0603FR-07130KL | Buy | Check live DigiKey stock | 2026-07-21
R37 | Resistor | 0 Ω jumper | 0603 | RES-08 | RC0603JR-070RL | Buy | Check live DigiKey stock | 2026-07-21
R38 | Resistor | 100 kΩ | 0603 | RES-07 | RC0603FR-07100KL | Buy | Check live DigiKey stock | 2026-07-21
R39 | Resistor | 5.1 kΩ | 0603 | RES-04 | RC0603FR-075K1L | Buy | Check live DigiKey stock | 2026-07-21
R40 | Resistor | 36 kΩ | 0603 | RES-16 | RC0603FR-0736KL | Buy | Check live DigiKey stock | 2026-07-21
R41 | Resistor | 3.6 kΩ | 0603 | RES-17 | RC0603FR-073K6L | Buy | Check live DigiKey stock | 2026-07-21
R42 | Resistor | 20 kΩ | 0603 | RES-18 | RC0603FR-0720KL | Buy | Check live DigiKey stock | 2026-07-21
R43 | Resistor | 0 Ω jumper | 0402 | RES-02 | RC0402JR-070RL | Buy | Check live DigiKey stock | 2026-07-21
TP1 | Test point | Test pad | PCB copper pad | PCB-only |  | PCB-only — no part | Pads are fabricated as part of the PCB; there is no component to order. | 2026-07-21
TP2 | Test point | Test pad | PCB copper pad | PCB-only |  | PCB-only — no part | Pads are fabricated as part of the PCB; there is no component to order. | 2026-07-21
TP3 | Test point | Test pad | PCB copper pad | PCB-only |  | PCB-only — no part | Pads are fabricated as part of the PCB; there is no component to order. | 2026-07-21
TP4 | Test point | Test pad | PCB copper pad | PCB-only |  | PCB-only — no part | Pads are fabricated as part of the PCB; there is no component to order. | 2026-07-21
TP5 | Test point | Test pad | PCB copper pad | PCB-only |  | PCB-only — no part | Pads are fabricated as part of the PCB; there is no component to order. | 2026-07-21
TP6 | Test point | Test pad | PCB copper pad | PCB-only |  | PCB-only — no part | Pads are fabricated as part of the PCB; there is no component to order. | 2026-07-21
TP7 | Test point | Test pad | PCB copper pad | PCB-only |  | PCB-only — no part | Pads are fabricated as part of the PCB; there is no component to order. | 2026-07-21
TP8 | Test point | Test pad | PCB copper pad | PCB-only |  | PCB-only — no part | Pads are fabricated as part of the PCB; there is no component to order. | 2026-07-21
TP9 | Test point | Test pad | PCB copper pad | PCB-only |  | PCB-only — no part | Pads are fabricated as part of the PCB; there is no component to order. | 2026-07-21
TP10 | Test point | Test pad | PCB copper pad | PCB-only |  | PCB-only — no part | Pads are fabricated as part of the PCB; there is no component to order. | 2026-07-21
TP11 | Test point | Test pad | PCB copper pad | PCB-only |  | PCB-only — no part | Pads are fabricated as part of the PCB; there is no component to order. | 2026-07-21
TP12 | Test point | Test pad | PCB copper pad | PCB-only |  | PCB-only — no part | Pads are fabricated as part of the PCB; there is no component to order. | 2026-07-21
TP13 | Test point | Test pad | PCB copper pad | PCB-only |  | PCB-only — no part | Pads are fabricated as part of the PCB; there is no component to order. | 2026-07-21
TP14 | Test point | Test pad | PCB copper pad | PCB-only |  | PCB-only — no part | Pads are fabricated as part of the PCB; there is no component to order. | 2026-07-21
TP15 | Test point | Test pad | PCB copper pad | PCB-only |  | PCB-only — no part | Pads are fabricated as part of the PCB; there is no component to order. | 2026-07-21
TP16 | Test point | Test pad | PCB copper pad | PCB-only |  | PCB-only — no part | Pads are fabricated as part of the PCB; there is no component to order. | 2026-07-21
TP17 | Test point | Test pad | PCB copper pad | PCB-only |  | PCB-only — no part | Pads are fabricated as part of the PCB; there is no component to order. | 2026-07-21
TP18 | Test point | Test pad | PCB copper pad | PCB-only |  | PCB-only — no part | Pads are fabricated as part of the PCB; there is no component to order. | 2026-07-21
TP19 | Test point | Test pad | PCB copper pad | PCB-only |  | PCB-only — no part | Pads are fabricated as part of the PCB; there is no component to order. | 2026-07-21
TP20 | Test point | Test pad | PCB copper pad | PCB-only |  | PCB-only — no part | Pads are fabricated as part of the PCB; there is no component to order. | 2026-07-21
TP21 | Test point | Test pad | PCB copper pad | PCB-only |  | PCB-only — no part | Pads are fabricated as part of the PCB; there is no component to order. | 2026-07-21
TP22 | Test point | Test pad | PCB copper pad | PCB-only |  | PCB-only — no part | Pads are fabricated as part of the PCB; there is no component to order. | 2026-07-21
TP23 | Test point | Test pad | PCB copper pad | PCB-only |  | PCB-only — no part | Pads are fabricated as part of the PCB; there is no component to order. | 2026-07-21
U1 | IC | Qi transmitter controller | PG-VQFN-68 | IC-01 | WLC1115-68LQXQ | Buy | Special-order risk. Do not leave this until the rest of the order is complete. | 2026-07-21
U2 | IC | Authentication IC | PG-USON-10-2 | IC-02 | SLS32AIA020U2USON10XTMA2 | Check before buying | HOLD: schematic text appears to use XTMA1, while the Infineon hardware guide calls out XTMA2. Confirm the exact orderable suffix and provisioning before purchasing. | 2026-07-21
U3 | IC | Dual operational amplifier | VSSOP-8 (DGK) | IC-03 | LMV358AQDGKRQ1 | Buy | Exact package suffix must remain DGK. | 2026-07-21

Sheet: Do Not Buy
Do not buy — DNP and PCB-only references
These references are intentionally excluded from Suggested Buy Qty. Optional hardware such as M3 screws/spacers should be handled separately if your enclosure needs it.
Reason | Designators | Value / function | Footprint | Optional MPN if later fitted | Buy quantity | Explanation
DNP | C9 | 10 pF | 0402 | CC0402JRNPO9BN100 | 0 | Marked do-not-populate in schematic.
DNP | C14 | 330 pF | 0603 | CC0603JRNPO9BN331 | 0 | Marked do-not-populate in schematic.
DNP | C16 | 10 nF | 0603 | CC0603KRX7R9BB103 | 0 | Marked do-not-populate in schematic; active 10 nF group excludes it.
DNP | C49 | 100 nF | 0603 | CC0603KRX7R9BB104 | 0 | Marked do-not-populate in schematic; active 100 nF group excludes it.
DNP | R18 | 1 MΩ | 0603 | RC0603FR-071ML | 0 | Marked do-not-populate in schematic.
DNP | R19 | 10 kΩ | 0603 | RC0603FR-0710KL | 0 | Marked do-not-populate in schematic; R15 is still fitted.
PCB-only | TP1,TP2,TP3,TP4,TP5,TP6,TP7,TP8,TP9,TP10,TP11,TP12,TP13,TP14,TP15,TP16,TP17,TP18,TP19,TP20,TP21,TP22,TP23 | Test pad | PCB copper pad |  | 0 | Pads are fabricated as part of the PCB; there is no component to order.
PCB-only | J5 | Solder-wire connection | PCB copper pads |  | 0 | The footprint is only solder pads. Wire is external/assembly material if required.
PCB-only | H1,H2,H3,H4 | M3 mounting hole | NPTH PCB feature |  | 0 | The holes are fabricated in the PCB. Screws/spacers are optional mechanical hardware, not PCB components.

Sheet: Assumptions & Notes
DigiKey purchase assumptions and design-critical notes
Prepared 2026-07-21. Change the blue input cells before ordering; stock and prices are not locked.
Input | Value
Boards to build | 1
Passive spare % | 20%
Semiconductor / IC spare % | 10%
Connector / mechanical spare % | 0%
Currency | AUD
Priority | Item | What to check | Why it matters | Reference(s) | Status | Source | Checked by / date
STOP | U2 suffix and provisioning | Confirm XTMA1 versus XTMA2 and the correct provisioned authentication device before purchase. | These parts are not necessarily interchangeable or blank-programmable in your workflow. | U2 | Open | https://www.infineon.com/assets/row/public/documents/24/42/infineon-an235387---hardware-design-guidelines-for-wlc-transmitter-applicationnotes-en.pdf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
STOP | J4 connector gender | PCB footprint is a right-angle male header; schematic wording says socket. | Wrong gender may fit the PCB but not your cable. | J4 | Open | Open project schematic/PCB
HIGH | Qi controller availability | Secure U1 first and verify the current DigiKey lifecycle/stock status. | The listing appeared limited / last-time-buy when checked. | U1 | Open | https://www.digikey.com/en/products/detail/infineon-technologies/WLC1115-68LQXQ/16676239
HIGH | Q8 availability | Exact MPN had no DigiKey stock; validate any cross-reference for voltage, pinout and gate drive. | A casual BSS138 substitution may not preserve all limits. | Q8 | Open | https://www.digikey.com/en/products/detail/infineon-technologies/BSS138NH6327XTSA2/5413728
HIGH | Bridge capacitors | Buy the specified 100 V C0G/NP0 parts, not generic 100 nF X7R parts. | Capacitance stability and voltage rating affect the resonant power stage. | C34–C38 | Mapped | https://www.digikey.com/en/products/detail/murata-electronics/GRM31C5C2A104JA01L/7363059
HIGH | 5.6 nF capacitor | Use 100 V C0G/NP0 TDK C1608C0G2A562J080AC. | The initial JLC match shown in the screenshot was only 50 V X7R. | C51 | Mapped | https://www.digikey.com/en/products/detail/tdk/C1608C0G2A562J080AC/5023337
HIGH | Current shunts | Keep ±1%, 1 W and ≤50 ppm/°C. | Sense error and temperature drift affect current control/protection. | R22,R23 | Mapped | https://www.digikey.com/en/products/detail/ohmite/PCS1206FR0050ET/10670858
MED | External Qi coil | Validate MP-A11 geometry, inductance, shielding, DCR and current rating before any substitution. | Inductance alone is not enough for a Qi transmitter coil. | EXT-COIL | Open | https://www.digikey.com/en/products/result?keywords=IWTX5050CZEB6R3KF1
INFO | Prices and stock | Open every link immediately before checkout and fill Unit Price / Order Status. | Distributor status changes; this workbook is a buying checklist, not a stock reservation. | All | Ongoing | https://www.digikey.com/
