niruvibes/elec3117proj/other/REF_WLC_TX15W_C1-MP A11 15W POWER TRANSMITTER REV04 GERBER/REF_WLC_TX15W_C1-MP A11 15W POWER TRANSMITTER REV05 BOM.xlsx

Sheet: REF_WLC_TX15W_C1 REV05
REF_WLC_TX15W_C1 MP A11 Wireless Power Transmitter: Bill of Materials (Bom)
Board Name |  | REF_WLC_TX15W_C1 MP A11 Wireless Power Transmitter
Revision Number |  | 05
Item | Qty | Reference | Value | PCB Footprint | Description | Manufacturer | MFG Part Number | DNP
1 | 3 | C1,C37,C57 | 1nF | capc1608x90n_ty | CAP CER 1000PF 25V X7R 0603 | YAGEO | CC0603KRX7R8BB102
2 | 1 | C16 | 5.6nF | capc1608x90n_ty | CAP CER 5600PF 100V C0G 0603 | TDK Corporation | C1608C0G2A562J080AC
3 | 1 | C17 | 0.22uF | capc1608x90n_ty | CAP CER 0.22UF 25V X7R 0603 | YAGEO | CC0603KRX7R8BB224
4 | 5 | C18,C19,C41,C44,C54 | 1uF | CAPC1005X56N_CYPS | CAP CER 1UF 25V X5R 0402 | YAGEO | CC0402KPX5R8BB105
5 | 17 | C2,C9,C10,C20,C26,C28,C30,C32,C39,C42,C43,C46,C47,C48,C49,C52,C56 | 0.1uF | capc1005x56n_cyps | CAP CER 0.1UF 25V X7R 0402 | YAGEO | CC0402KRX7R8BB104
6 | 1 | C21 | 100nF | capc1608x90n_ty | CAP CER 0.1UF 50V X7R 0603 | YAGEO | CC0603KRX7R9BB104
7 | 2 | C23,C25 | 330pF | capc1608x90n_ty | CAP CER 330PF 25V X7R 0603 | YAGEO | CC0603KRX7R8BB331
8 | 5 | C27,C29,C31,C50,C61 | 10nF | capc1608x90n_ty | CAP CER 10000PF 25V X7R 0603 | YAGEO | CC0603KRX7R8BB103
9 | 1 | C33 | 2.2uF | capc1005x56n_cyps | CAP CER 2.2UF 6.3V X5R 0402 | YAGEO | CC0402KPX5R5BB225
10 | 1 | C34 | 0.47uF | capc1608x90n_ty | CAP CER 0.47UF 25V X7R 0603 | YAGEO | CC0603KRX7R8BB474
11 | 1 | C35 | 470nF | capc1005x56n_cyps | CAP CER 0.47UF 6.3V X5R 0402 | YAGEO | CC0402KPX5R5BB474
12 | 2 | C40,C45 | 0.1uF | capc1608x90n_ty | CAP CER 0.1UF 25V X7R 0603 | YAGEO | CC0603KRX7R8BB104
13 | 2 | C5,C13 | 22nF | capc1608x90n_ty | CAP CER 0.022UF 25V X7R 0603 | YAGEO | CC0603KRX7R8BB223
14 | 2 | C51,C55 | 22uF | capc2012X70n_murata | CAP CER 22UF 25V X5R 0805 | YAGEO | CC0805MKX5R8BB226
15 | 1 | C53 | 10uF | capc2012X70n_murata | CAP CER 10UF 10V X7R 0805 | YAGEO | CC0805KKX7R6BB106
16 | 3 | C58,C60,C65 | 4.7uF | capc2012X70n_murata | CAP CER 4.7UF 25V X5R 0805 | Murata Electronics | GRM219R61E475KA73J
17 | 6 | C59,C62,C63,C64,C66,C67 | 22uF | CAPC3216X190N_A | CAP CER 22UF 25V X6S 1206 | Samsung Electro-Mechanics | CL31X226KAHN3NE
18 | 1 | C6 | 1nF | capc1608x90n_ty | CAP CER 1000PF 100V X7R 0603 | YAGEO | CC0603KRX7R0BB102
19 | 1 | C7 | 150pF | capc1608x90n_ty | CAP CER 150PF 25V X7R 0603 | YAGEO | CC0603KRX7R8BB151
20 | 5 | C8,C12,C14,C22,C24 | 0.1uF | CAPC3216X190N_A | CAP CER 0.1UF 100V C0G/NP0 1206 | Murata Electronics | GRM31C5C2A104JA01L
21 | 3 | R1,R11,R20 | 100K | resc1608x55n_pec | RES 100K OHM 1% 1/10W 0603 | Vishay Dale | CRCW0603100KFKEBC
22 | 1 | R12 | 36K | resc1608x55n_pec | RES 36K OHM 1% 1/10W 0603 | Vishay Dale | CRCW060336K0FKEAC
23 | 8 | R14,R18,R19,R23,R25,R26,R28,R31 | 5.1K | resc1608x55n_pec | RES 5.1K OHM 1% 1/10W 0603 | Vishay Dale | CRCW06035K10FKEAC
24 | 7 | R15,R27,R35,R36,R41,R44,R45 | 0E | resc1608x55n_pec | RES 0 OHM JUMPER 1/10W 0603 | Vishay Dale | CRCW06030000Z0EBC
25 | 1 | R17 | 20K | resc1608x55n_pec | RES 20K OHM 1% 1/10W 0603 | Vishay Dale | CRCW060320K0FKEAC
26 | 1 | R2 | 80.6K | resc1608x55n_pec | RES 80.6K OHM 1% 1/10W 0603 | Vishay Dale | CRCW060380K6FKEAC
27 | 1 | R22 | 130K | resc1608x55n_pec | RES 130K OHM 1% 1/10W 0603 | Vishay Dale | CRCW0603130KFKEAC
28 | 1 | R3 | 27K | resc1608x55n_pec | RES 27K OHM 1% 1/10W 0603 | Vishay Dale | CRCW060327K0FKEAC
29 | 1 | R30 | 2.2K | resc1608x55n_pec | RES 2.2K OHM 1% 1/10W 0603 | Vishay Dale | CRCW06032K20FKEAC
30 | 5 | R32,R38,R39,R40,R52 | 0E | RESC1005X40N_PEC | RES 0 OHM JUMPER 1/16W 0402 | Vishay Dale | CRCW04020000Z0EDC
31 | 4 | R33,R34,R46,R48 | 10E | RESC1005X40N_PEC | RES 10 OHM 1% 1/16W 0402 | Vishay Dale | CRCW040210R0FKEDC
32 | 1 | R4 | 10K | resc1608x55n_pec | RES 10K OHM 1% 1/10W 0603 | Vishay Dale | CRCW060310K0FKEAC
33 | 1 | R47 | 0.01 | R1206_OHMITE | RES 0.01 OHM 1% 1W 1206 | Ohmite | LVT12R0100FER
34 | 1 | R49 | 0.005 | R1206_OHMITE | RES 0.005 OHM 1% 1W 1206 | Ohmite | LVT12R0050FER
35 | 1 | R29 | 62E | resc1608x55n_pec | RES 62 OHM 1% 1/10W 0603 | Vishay Dale | CRCW060362R0FKEAC
36 | 1 | R5 | 390E | resc1608x55n_pec | RES 390 OHM 1% 1/10W 0603 | Vishay Dale | CRCW0603390RFKEAC
37 | 1 | R53 | 3.6K | resc1608x55n_pec | RES 3.6K OHM 1% 1/10W 0603 | Vishay Dale | CRCW06033K60FKEAC
38 | 4 | R6,R7,R24,R37 | 1K | resc1608x55n_pec | RES 1K OHM 1% 1/10W 0603 | Vishay Dale | CRCW06031K00FKEAC
39 | 1 | D1 | BAT64T5Q-7-F | BAT64T5Q-7-F | Diode Schottky 40V 250mA (DC) Surface Mount SOD-523 AEC-Q101 | Diodes Incorporated | BAT64T5Q-7-F
40 | 1 | D2 | MMBD1503-TP | sot23_1_2_3 | DIODE ARRAY GP 180V 200MA SOT23 | Micro Commercial Co | MMBD1503-TP
41 | 1 | D3 | BAT54-04W | BAT5404W | DIODE ARRAY SCHOTTKY 30V SOT323 | Infineon Technologies | BAT5404WH6327XTSA1
42 | 1 | D4 | BAS16H,115 | SOD123F_NXP | DIODE GP 100V 215MA SOD123F | Nexperia USA Inc. | BAS16H,115
43 | 4 | D6,D7,D8,D9 | RB511SM-40FHT2R | SOD-523N | Diode Schottky 40V 100mA Surface Mount EMD2 AEC-Q101 | Rohm Semiconductor | RB511SM-40FHT2R
44 | 1 | J1 | PRPC002SAAN-RC | HDR2X1 | CONN HEADER VERT 2POS 2.54MM | Sullins Connector Solutions | PRPC002SAAN-RC
45 | 1 | J2 | 22-23-2051 | HDR5_KEYED_M | CONN HEADER 5POS 0.1 VERT KEYED | Molex | 22-23-2051
47 | 1 | L1 | 100 ohms | DLW5BTM101TQ2L | CMC 6A 2LN 100 OHM SMD | Murata Electronics | DLW5BTM101TQ2L
48 | 1 | L2 | 6.8uH | PA4342-682NLT | FIXED IND 6.8UH 8.5A 23.3MOHM SM | Pulse Electronics Power | PA4342.682NLT
49 | 1 | L3 | MP-A11 COIL | WURTH_760308103146_CYPS_OFFSET | 1 Coil, 1 Layer 6.3µH Wireless Charging Coil Transmitter 45mOhm Max | Vishay Dale | IWTX5050CZEB6R3KF1
50 | 1 | LED1 | LTST-C195TBJRKT | LTST-C195TBJRKT | LED BLUE/RED CLEAR CHIP SMD | Lite-On Inc. | LTST-C195TBJRKT
51 | 6 | M11,M12,M13,M14,M15,M16 | BSZ0910LS | INFINEON-PG-TSDSON-8-32 | N-Channel 30 V 18A (Ta), 40A (Tc) 2.1W (Ta), 37W (Tc) Surface Mount PG-TDSON-8 FL | Infineon Technologies | BSZ0910LSATMA1
52 | 1 | NT2 | 100k, NTC | NXFT15WF104FEAB021 | NTC Thermistor 100k Bead | Murata Electronics | NXFT15WF104FEAB021
53 | 1 | Q1 | BSS138N | SOT23_1_2_3 | MOSFET N-CH 60V 230MA SOT23-3 | Infineon Technologies | BSS138NH6327XTSA2
54 | 1 | U1 | LMV358AQDGKRQ1 | DGK8 | AEC-Q100, 2-CHANNEL, 1-MHZ, INDU | Texas Instruments | LMV358AQDGKRQ1
55 | 1 | U2 | SLS32AIA020U3 USON10 | PG-USON-10-2 | enhanced wireless charging authentication solution ; available in two temperature ranges: ; SLS32AIA020U2 standard: -25 to +85°C ; SLS32AIA020U3 extended: -40 to +105°C | Infineon Technologies | SLS32AIA020U3 USON10
56 | 1 | U3 | WLC1115-68LQXQ | QFN40P800X800X60-69N_cus | 15W Wireless power transmitter with integrated USB Type-C PD sink controller | Infineon Technologies | WLC1115-68LQXQ
57 | 3 | VBRG_0,USB-IN,COIL_SNS | RED | TP-43R_S | TEST POINT PC MINI .040"D RED | KEYSTONE ELECTRONICS | 5000
58 | 3 | GND1,USB-GND,GND | BLACK | TP-43R_S | TEST POINT PC MINI .040"D BLACK | KEYSTONE ELECTRONICS | 5001
59 | 1 | Y1 | 831019884 | SG7050CCN48000000M-HJGBB | XTAL OSC XO 48.0000MHZ CMOS SMD | EPSON | SG7050CCN 48.000000M-HJGBB
DNP Parts
59 | 1 | C3 | 330pF | capc1608x90n_ty | CAP CER 330PF 25V X7R 0603 | Yageo | CC0603KRX7R8BB331 | DNP
60 | 1 | C4 | 10nF | capc1608x90n_ty | CAP CER 10000PF 25V X7R 0603 | YAGEO | CC0603KRX7R8BB103 | DNP
61 | 1 | C15 | 0.1uF | capc1005x56n_cyps | CAP CER 0.1UF 25V X7R 0402 | YAGEO | CC0402KRX7R8BB104 | DNP
62 | 1 | C36 | 10pF | capc1608x90n_ty | CAP CER 10PF 25V C0G/NPO 0603 | YAGEO | CC0603JRNPO8BN100 | DNP
63 | 1 | R10 | 1M | resc1608x55n_pec | RES 1M OHM 1% 1/10W 0603 | Vishay Dale | CRCW06031M00FKEAC | DNP
64 | 1 | R21 | 10K | resc1608x55n_pec | RES 10K OHM 1% 1/10W 0603 | Vishay Dale | CRCW060310K0FKEAC | DNP
65 | 1 | R42 | 0E | resc1608x55n_pec | RES 0 OHM JUMPER 1/10W 0603 | Vishay Dale | CRCW06030000Z0EBC | DNP
67 | 1 | J4 | 20021511-00012T4LF | 20021511-00012T4LF | Connector Header Through Hole 12 position 0.050" (1.27mm) | Amphenol ICC (FCI) | 20021511-00012T4LF | DNP
68 | 1 | J6 | 2059-302/998-403 | WAGO_2059-302998-403 | SMD PCB TERMINAL BLOCK; 0.5 MM; | WAGO Corporation | 2059-302/998-403 | DNP
69 | 1 | LED2 | LTL1BEKVJNN | LTL1BEKVJNN | LED GREEN/RED DIFFUSED T/H | Lite-On Inc. | LTL1BEKVJNN | DNP
70 | 1 | NT1 | 100k, NTC | resc1608x55n_pec | THERM NTC 100KOHM 4419K 0603 | TDK Corporation | NTCG164KF104FTDS | DNP
71 | 1 | Q2 | BSS138N | SOT23_1_2_3 | MOSFET N-CH 60V 230MA SOT23-3 | Infineon Technologies | BSS138NH6327XTSA2 | DNP
MECHANICAL ACCESSORIES
1 | 8 | STAND OFF | STAND OFF |  | HEX STANDOFF M3 NYLON 15MM | Keystone Electronics | 25512
2 | 4 | SCREW | SCREW |  | MACH SCREW FLAT SLOTTED #4-40 | Keystone Electronics | 9530
3 | 4 | SCREW | SCREW |  | MACH SCREW PAN HEAD SLOTTED 4-40 | Keystone Electronics | 9330
4 | 4 | SPACER | SPACER |  | ROUND SPACER #6 NYLON 3/16" | Bivar Inc. | 9905-187
5 | 1 | ACRYLIC | ACRYLIC |  | 1COIL 68X61mm Size 2mm thickness counter sunk drill hole (refer drawing)
6 | 1 | TAPE | TAPE |  | Double sided Thermal tape as per the coil dimensions | 3M | GPH-160GF 0.75" X 5YD

Sheet: Revision History
REF_WLC_TX15W_C1 MP A11 Wireless Power Transmitter: Revision History
Date | Revision | Description
2022-05-15 | 04 | Initial revision
2023-02-27 | 05 | Updated part details for R29, R30 and C21
