niruvibes/elec3117proj/outputs/jlcpcb-order-inspect/JLCPCB_BOM_Tool_-_BOM_Matching.png

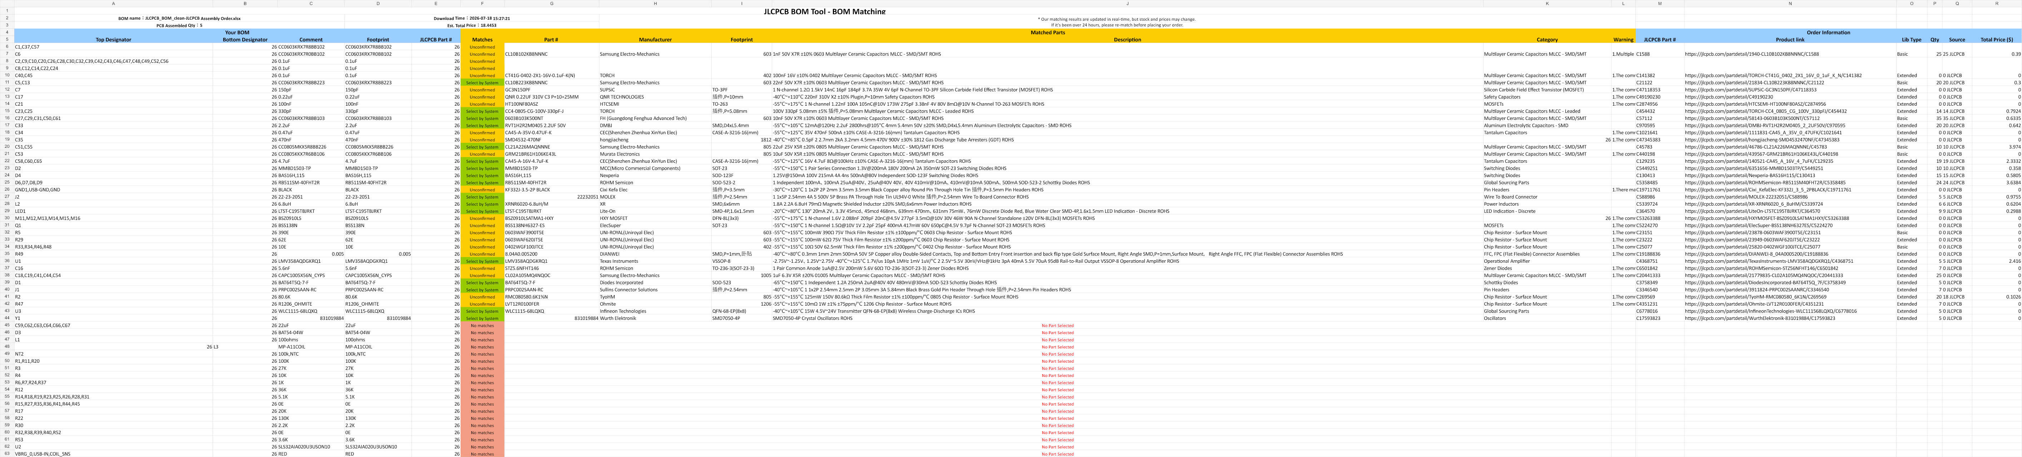
outputs/jlcpcb-order-inspect/JLCPCB_BOM_Tool_-_BOM_Matching.png
