niruvibes/elec3117proj/outputs/jlcpcb-upload-clean/JLCPCB_BOM_clean.png

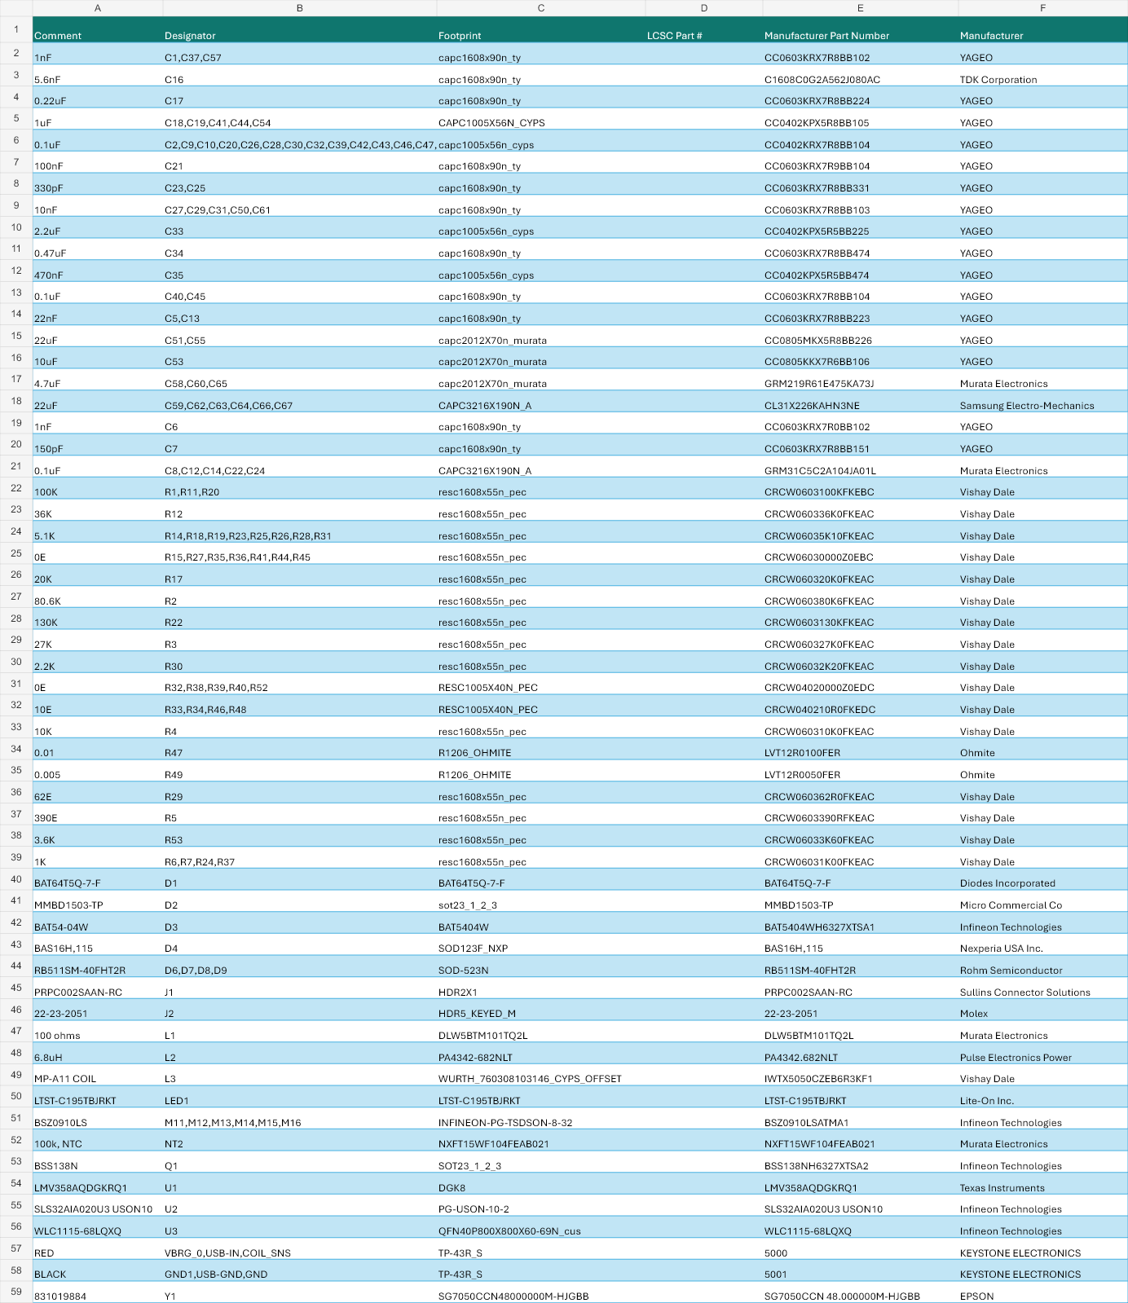
outputs/jlcpcb-upload-clean/JLCPCB_BOM_clean.png
