niruvibes/elec3117proj/outputs/jlcpcb-upload-clean/source_bom.png

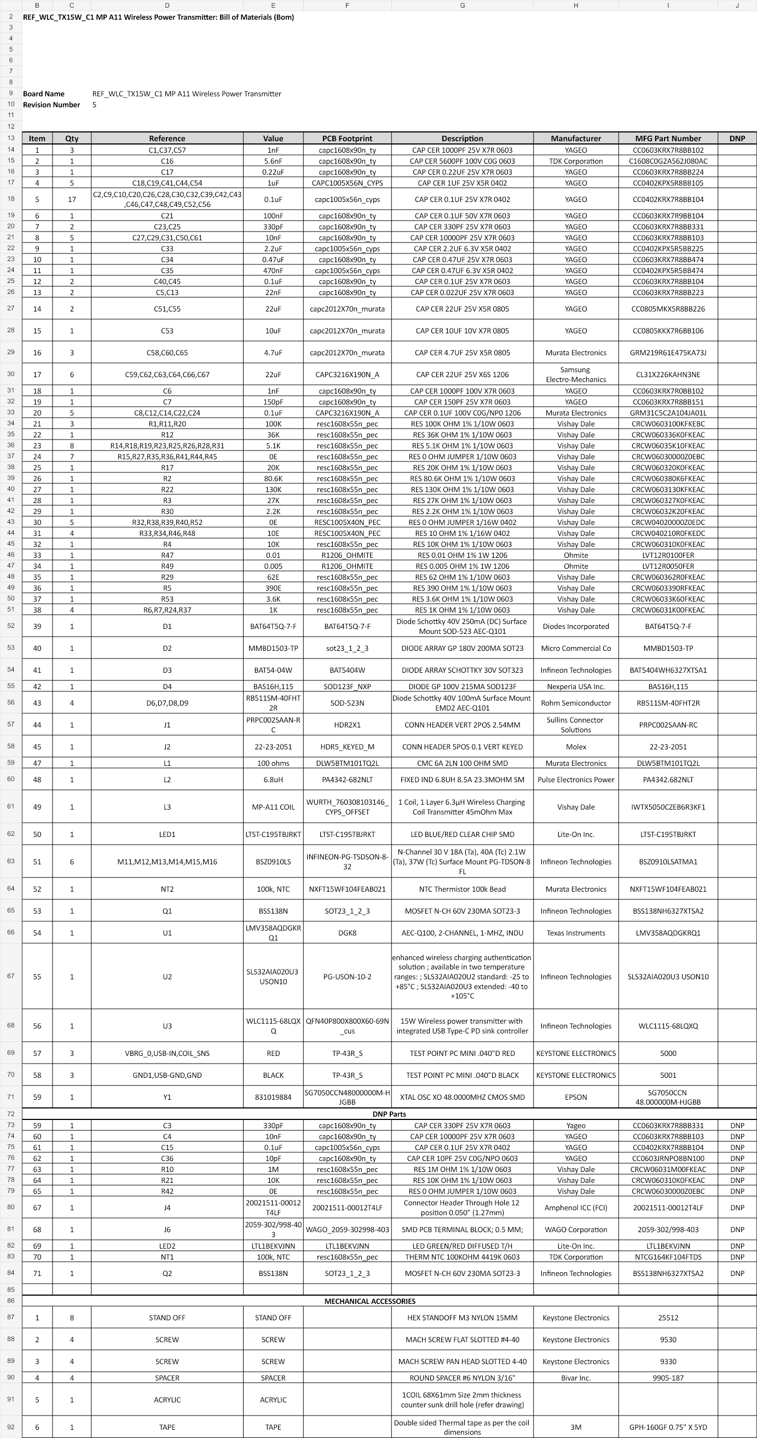
outputs/jlcpcb-upload-clean/source_bom.png
