niruvibes/elec3117proj/components/bat54s/sot-23.stp

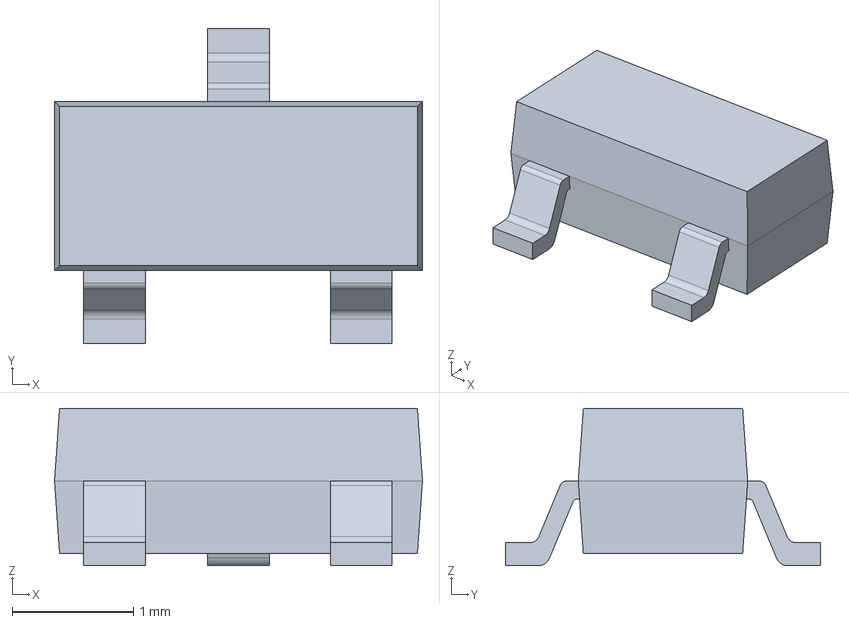
[picture p21: CAD file, 2026-07-14]
components/bat54s/sot-23.stp
3.04 x 2.60 x 1.30 mm
