niruvibes/elec3117proj/components/opamp/DGK0008A.stp

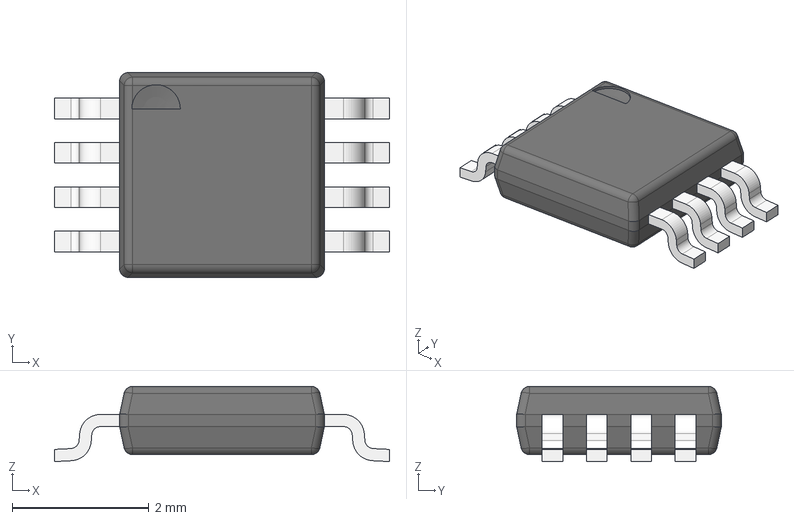
[picture p22: CAD file, 2026-07-14]
components/opamp/DGK0008A.stp
4.90 x 3.00 x 1.10 mm
BODY_MUA08A
LEAD_MUA08A x 8
