niruvibes/elec3117proj/other/REF_WLC_TX15W_C1-MP A11 15W POWER TRANSMITTER REV04 FABRICATION DRAWING.pdf

D

4

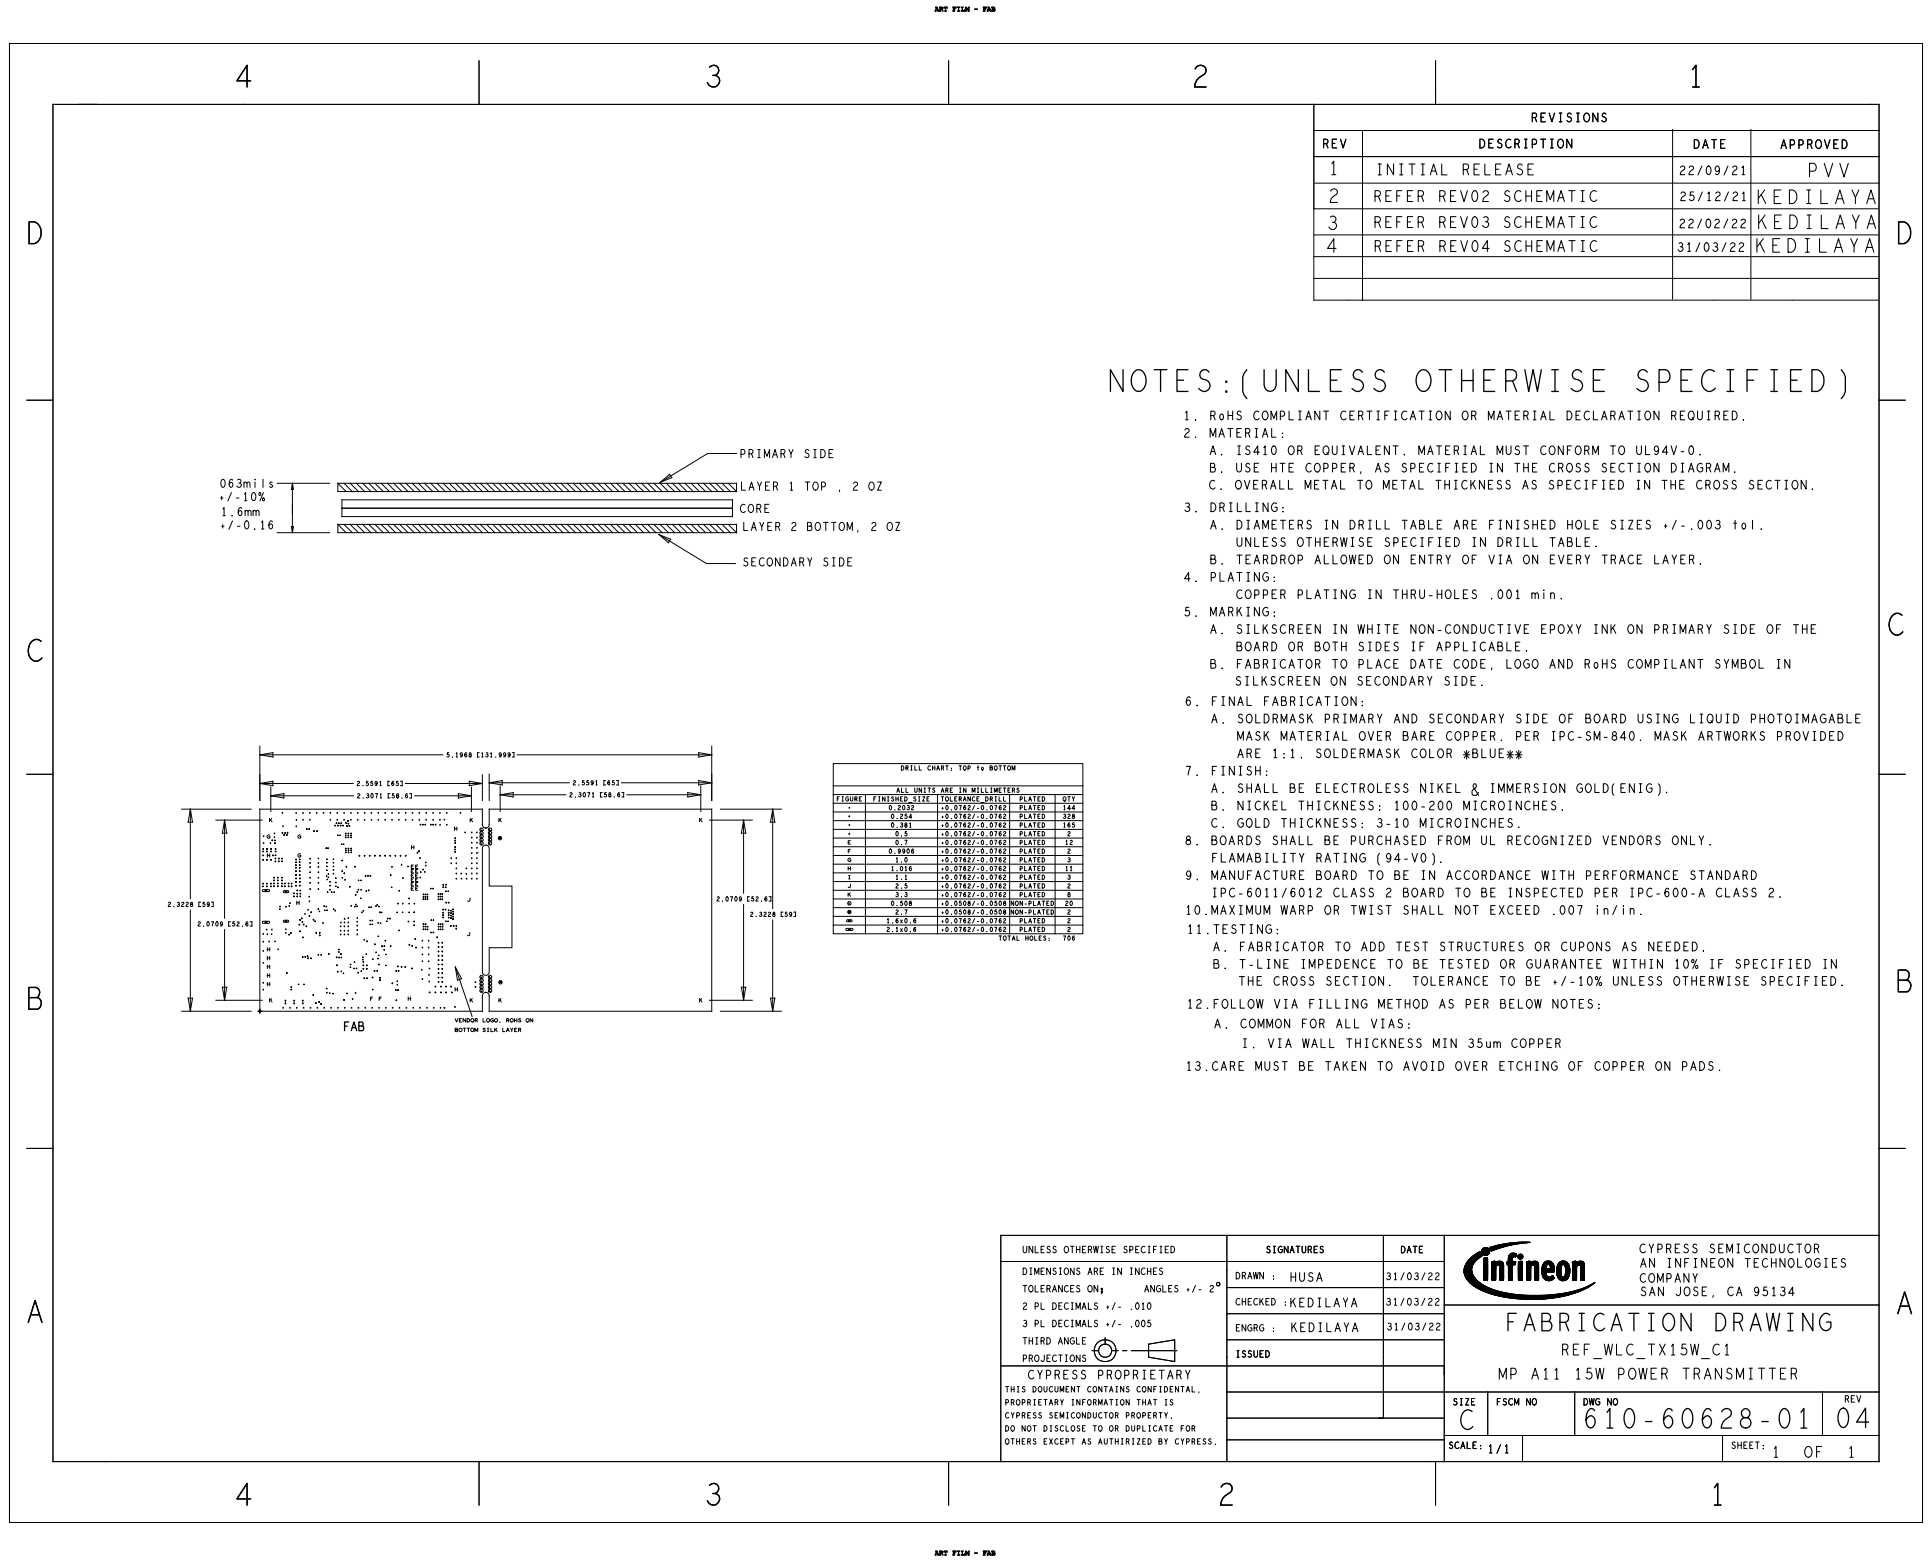
[picture p23: page 1]
063mils; FAB; SECONDARY SIDE; LAYER 2 BOTTOM, 2; CORE; LAYER 1 TOP ,; PRIMARY SIDE; FIGURE; FINISHED_SIZE; TOLERANCE_DRILL; TOTAL HOLES:; NON-PLATED; PROJECTIONS; THIRD ANGLE; PLATED; QTY; FABRICATION DRAWING; REF_WLC_TX15W_C1

ART FILM - FAB

REVISIONS

REV | DESCRIPTION | DATE | APPROVED
1 | INITIAL RELEASE | 22/09/21 | PVV
2 | REFER REV02 SCHEMATIC | 25/12/21 | KEDILAYA
3 | REFER REV03 SCHEMATIC | 22/02/22 | KEDILAYA
4 | REFER REV04 SCHEMATIC | 31/03/22 | KEDILAYA

NOTES:(UNLESS OTHERWISE SPECIFIED)

1. RoHS COMPLIANT CERTIFICATION OR MATERIAL DECLARATION REQUIRED.
2. MATERIAL:
A. IS410 OR EQUIVALENT. MATERIAL MUST CONFORM TO UL94V-0.
B. USE HTE COPPER, AS SPECIFIED IN THE CROSS SECTION DIAGRAM.
C. OVERALL METAL TO METAL THICKNESS AS SPECIFIED IN THE CROSS SECTION.

3. DRILLING:
A. DIAMETERS IN DRILL TABLE ARE FINISHED HOLE SIZES +/-.003 tol.
UNLESS OTHERWISE SPECIFIED IN DRILL TABLE.
B. TEARDROP ALLOWED ON ENTRY OF VIA ON EVERY TRACE LAYER.
4. PLATING:

COPPER PLATING IN THRU-HOLES .001 min.

5. MARKING:
A. SILKSCREEN IN WHITE NON-CONDUCTIVE EPOXY INK ON PRIMARY SIDE OF THE
BOARD OR BOTH SIDES IF APPLICABLE.
B. FABRICATOR TO PLACE DATE CODE, LOGO AND RoHS COMPILANT SYMBOL IN

SILKSCREEN ON SECONDARY SIDE.

6. FINAL FABRICATION:
A. SOLDRMASK PRIMARY AND SECONDARY SIDE OF BOARD USING LIQUID PHOTOIMAGABLE
MASK MATERIAL OVER BARE COPPER. PER IPC-SM-840. MASK ARTWORKS PROVIDED
ARE 1:1. SOLDERMASK COLOR *BLUE**

DRILL CHART: TOP to BOTTOM

7. FINISH:
A. SHALL BE ELECTROLESS NIKEL & IMMERSION GOLD(ENIG).
B. NICKEL THICKNESS: 100-200 MICROINCHES.
C. GOLD THICKNESS: 3-10 MICROINCHES.
8. BOARDS SHALL BE PURCHASED FROM UL RECOGNIZED VENDORS ONLY.
FLAMABILITY RATING (94-V0).
9. MANUFACTURE BOARD TO BE IN ACCORDANCE WITH PERFORMANCE STANDARD
IPC-6011/6012 CLASS 2 BOARD TO BE INSPECTED PER IPC-600-A CLASS 2.
10.MAXIMUM WARP OR TWIST SHALL NOT EXCEED .007 in/in.

ALL UNITS ARE IN MILLIMETERS

11.TESTING:
A. FABRICATOR TO ADD TEST STRUCTURES OR CUPONS AS NEEDED.
B. T-LINE IMPEDENCE TO BE TESTED OR GUARANTEE WITHIN 10% IF SPECIFIED IN
THE CROSS SECTION. TOLERANCE TO BE +/-10% UNLESS OTHERWISE SPECIFIED.

12.FOLLOW VIA FILLING METHOD AS PER BELOW NOTES:

VENDOR LOGO, ROHS ON

BOTTOM SILK LAYER

A. COMMON FOR ALL VIAS:

I. VIA WALL THICKNESS MIN 35um COPPER

13.CARE MUST BE TAKEN TO AVOID OVER ETCHING OF COPPER ON PADS.

UNLESS OTHERWISE SPECIFIED | SIGNATURES | DATE | CYPRESS SEMICONDUCTOR SAN JOSE, CA 95134

AN INFINEON TECHNOLOGIES
COMPANY

DIMENSIONS ARE IN INCHES TOLERANCES ON; ANGLES +/- 2 2 PL DECIMALS +/- .010 3 PL DECIMALS +/- .005 | DRAWN : HUSA | 31/03/22

CHECKED : KEDILAYA | 31/03/22

KEDILAYA ENGRG : | 31/03/22

ISSUED

CYPRESS PROPRIETARY THIS DOUCUMENT CONTAINS CONFIDENTAL, PROPRIETARY INFORMATION THAT IS CYPRESS SEMICONDUCTOR PROPERTY. DO NOT DISCLOSE TO OR DUPLICATE FOR OTHERS EXCEPT AS AUTHIRIZED BY CYPRESS.

MP A11 15W POWER TRANSMITTER

SIZE C | FSCM NO | DWG NO 610-60628-01 | REV 04

SCALE: 1/1 | SHEET:

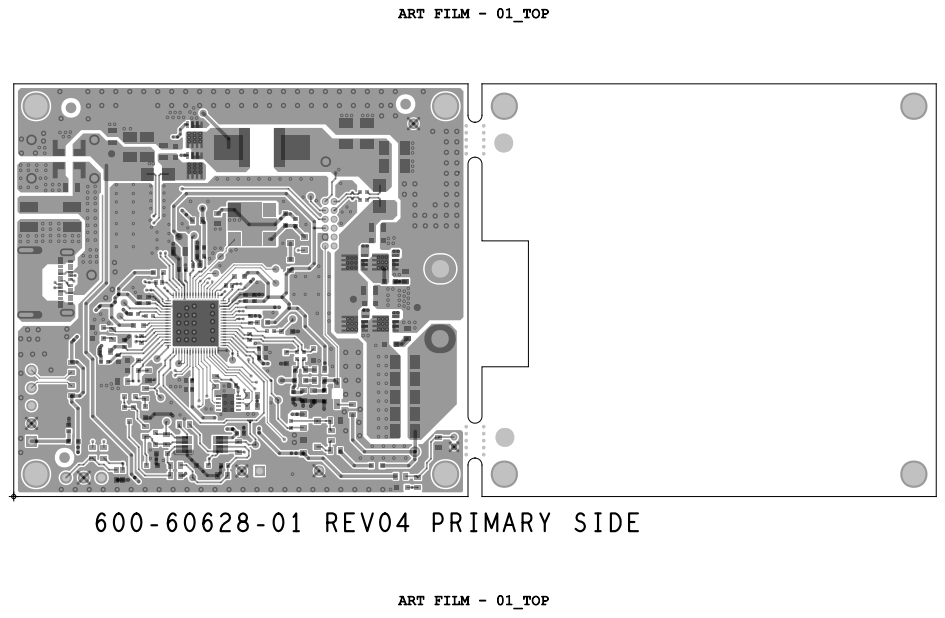
[picture p24: page 2]
ART FILM - 01_TOP; 600-60628-01 REV04 PRIMARY SIDE

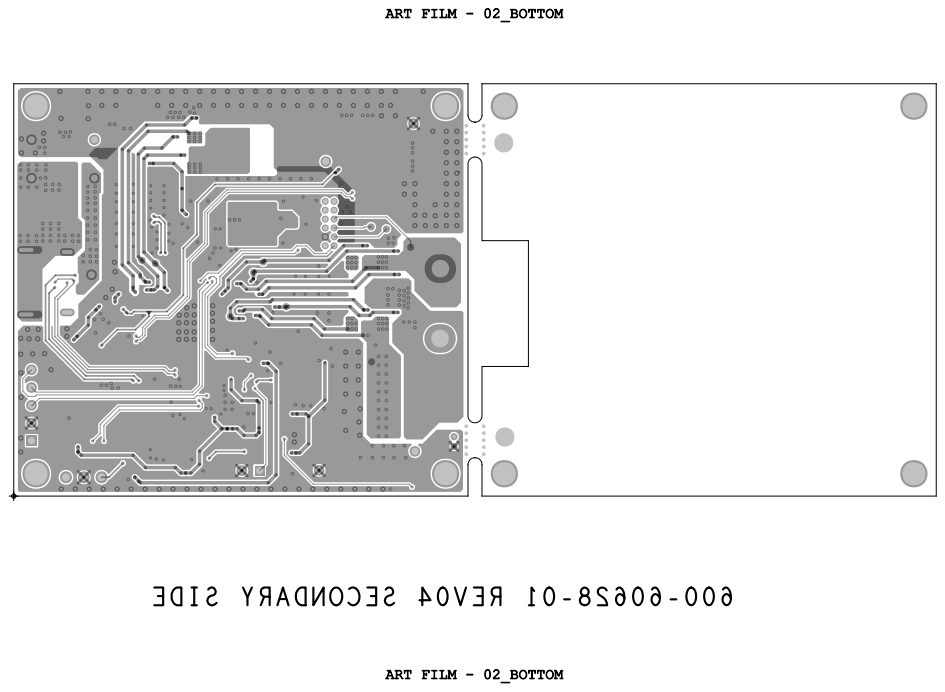
[picture p25: page 3]
ART FILM - 02_BOTTOM

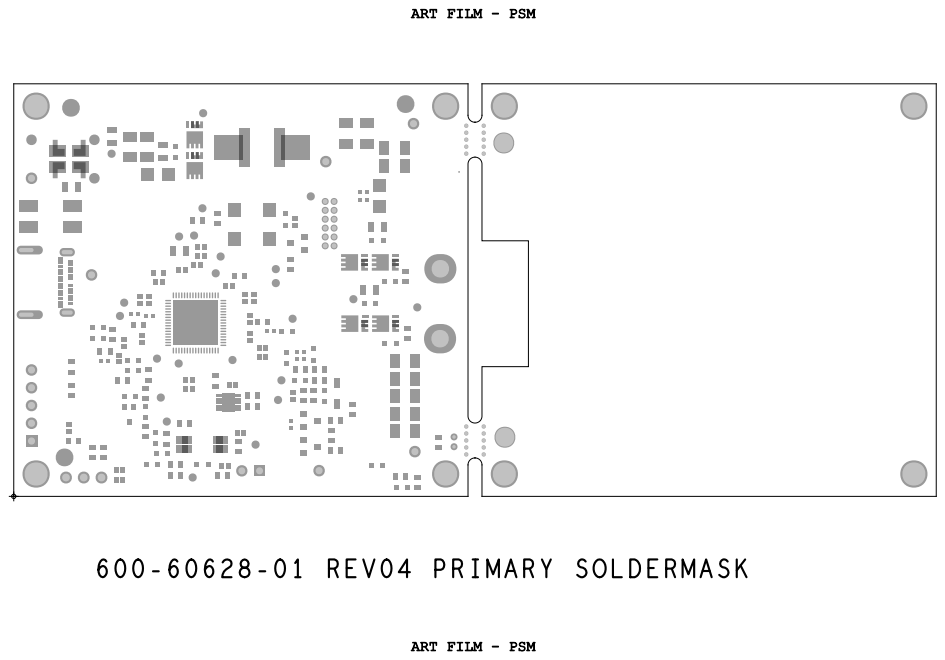
[picture p26: page 4]
600-60628-01 REV04 PRIMARY SOLDERMASK

ART FILM - PSM

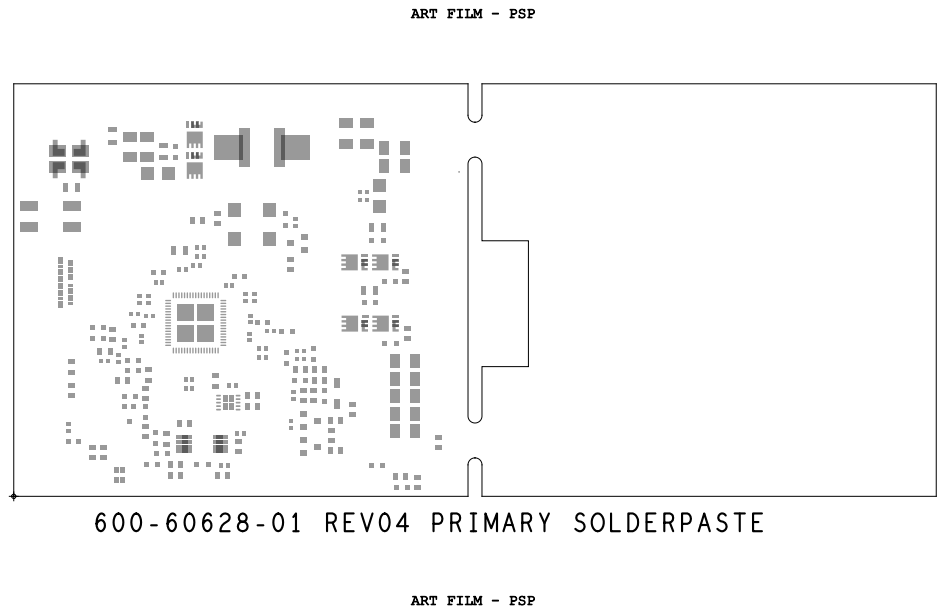
[picture p27: page 5]
600-60628-01 REV04 PRIMARY SOLDERPASTE

ART FILM - PSP

# 600-60628-01 REV04 OPAMP_CMP

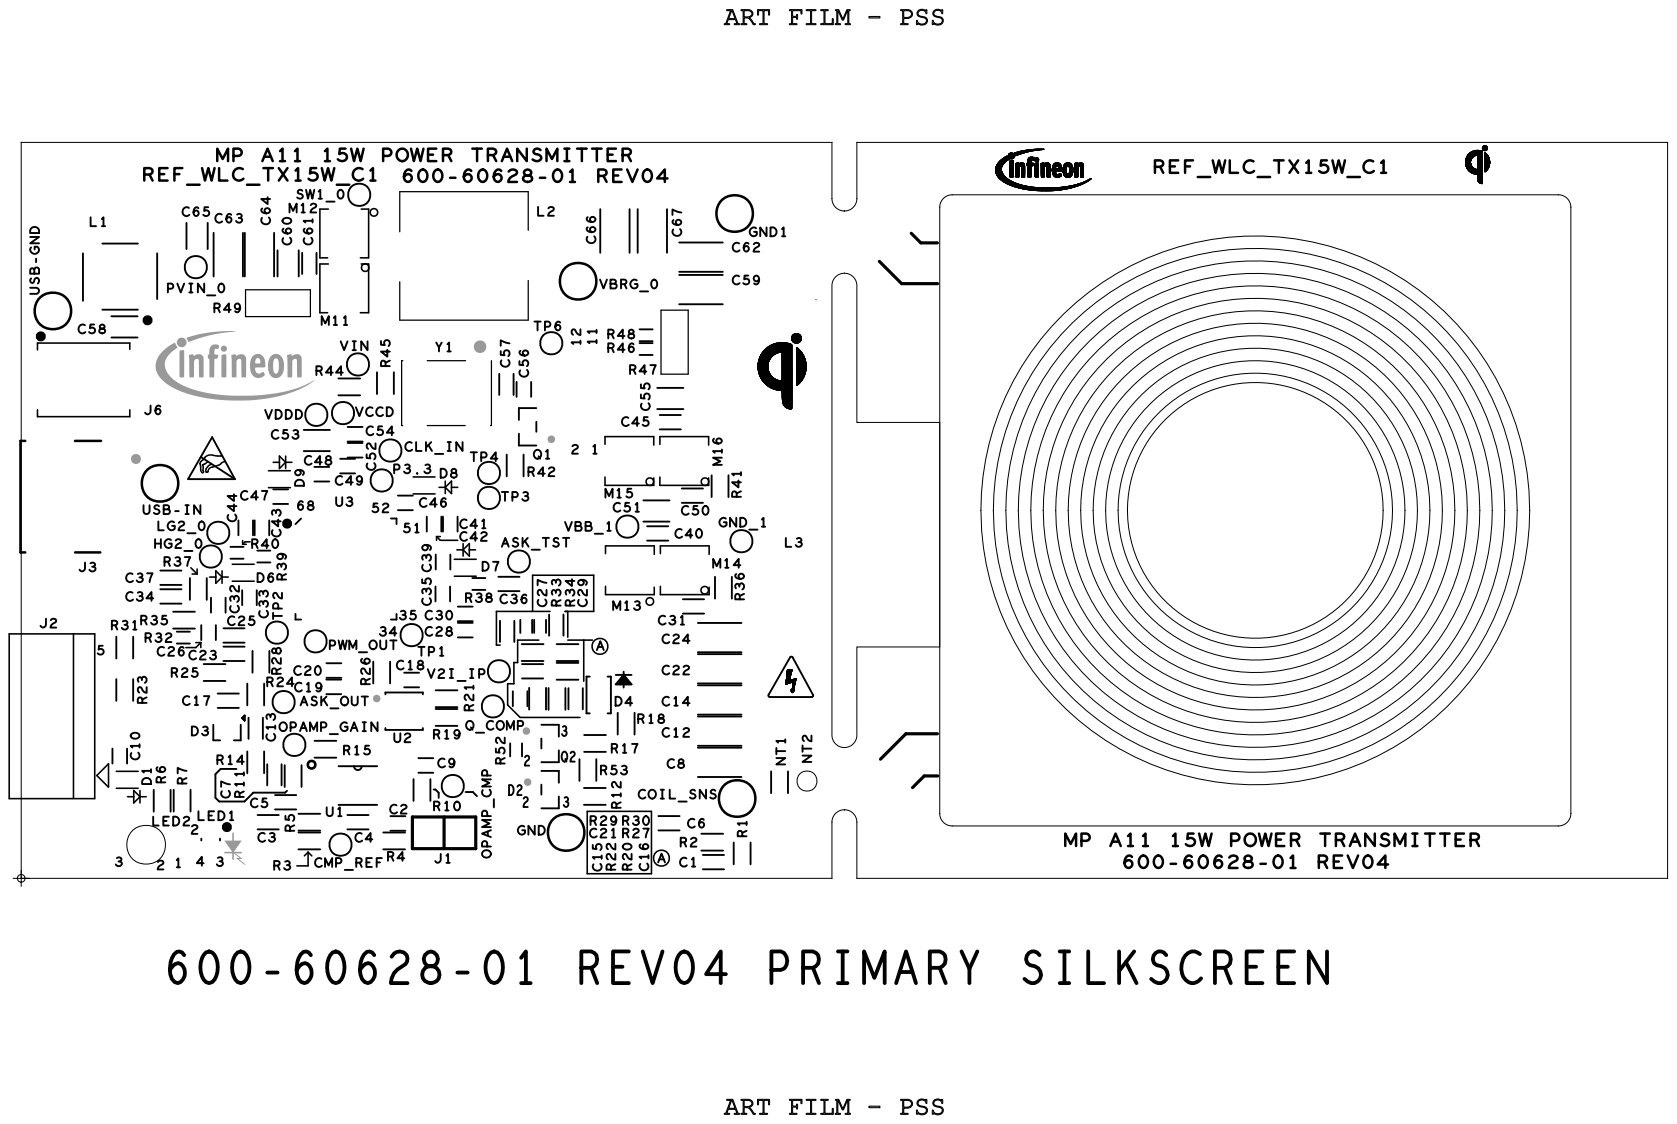
[picture p28: page 6]

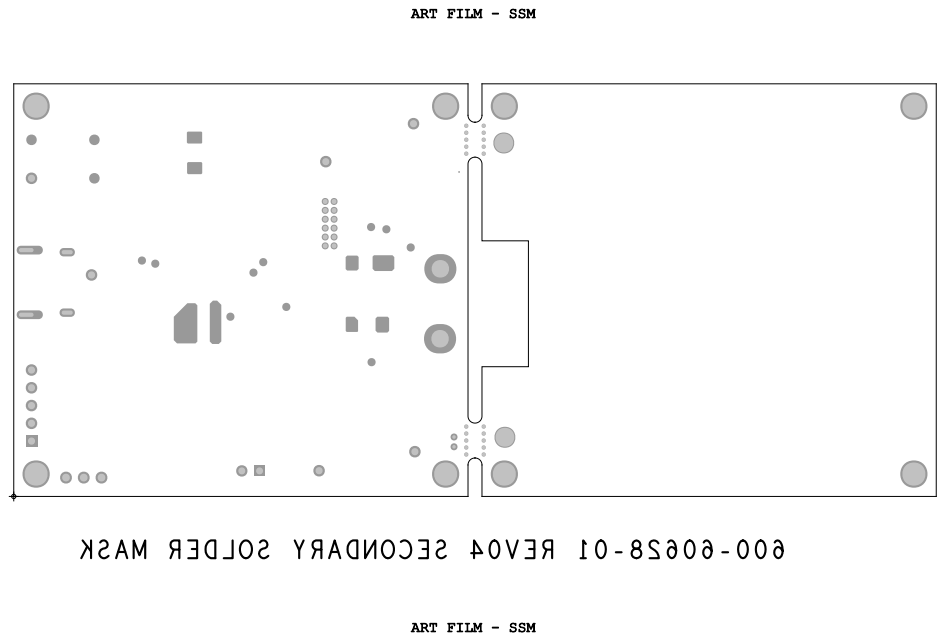
[picture p29: page 7]

ART FILM - SSM

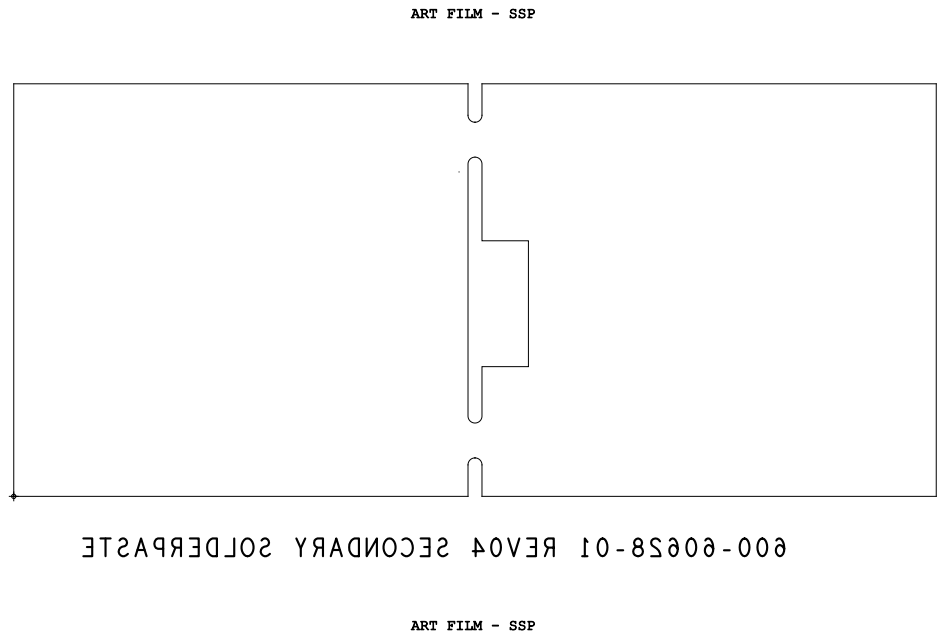
[picture p30: page 8]

ART FILM - SSP

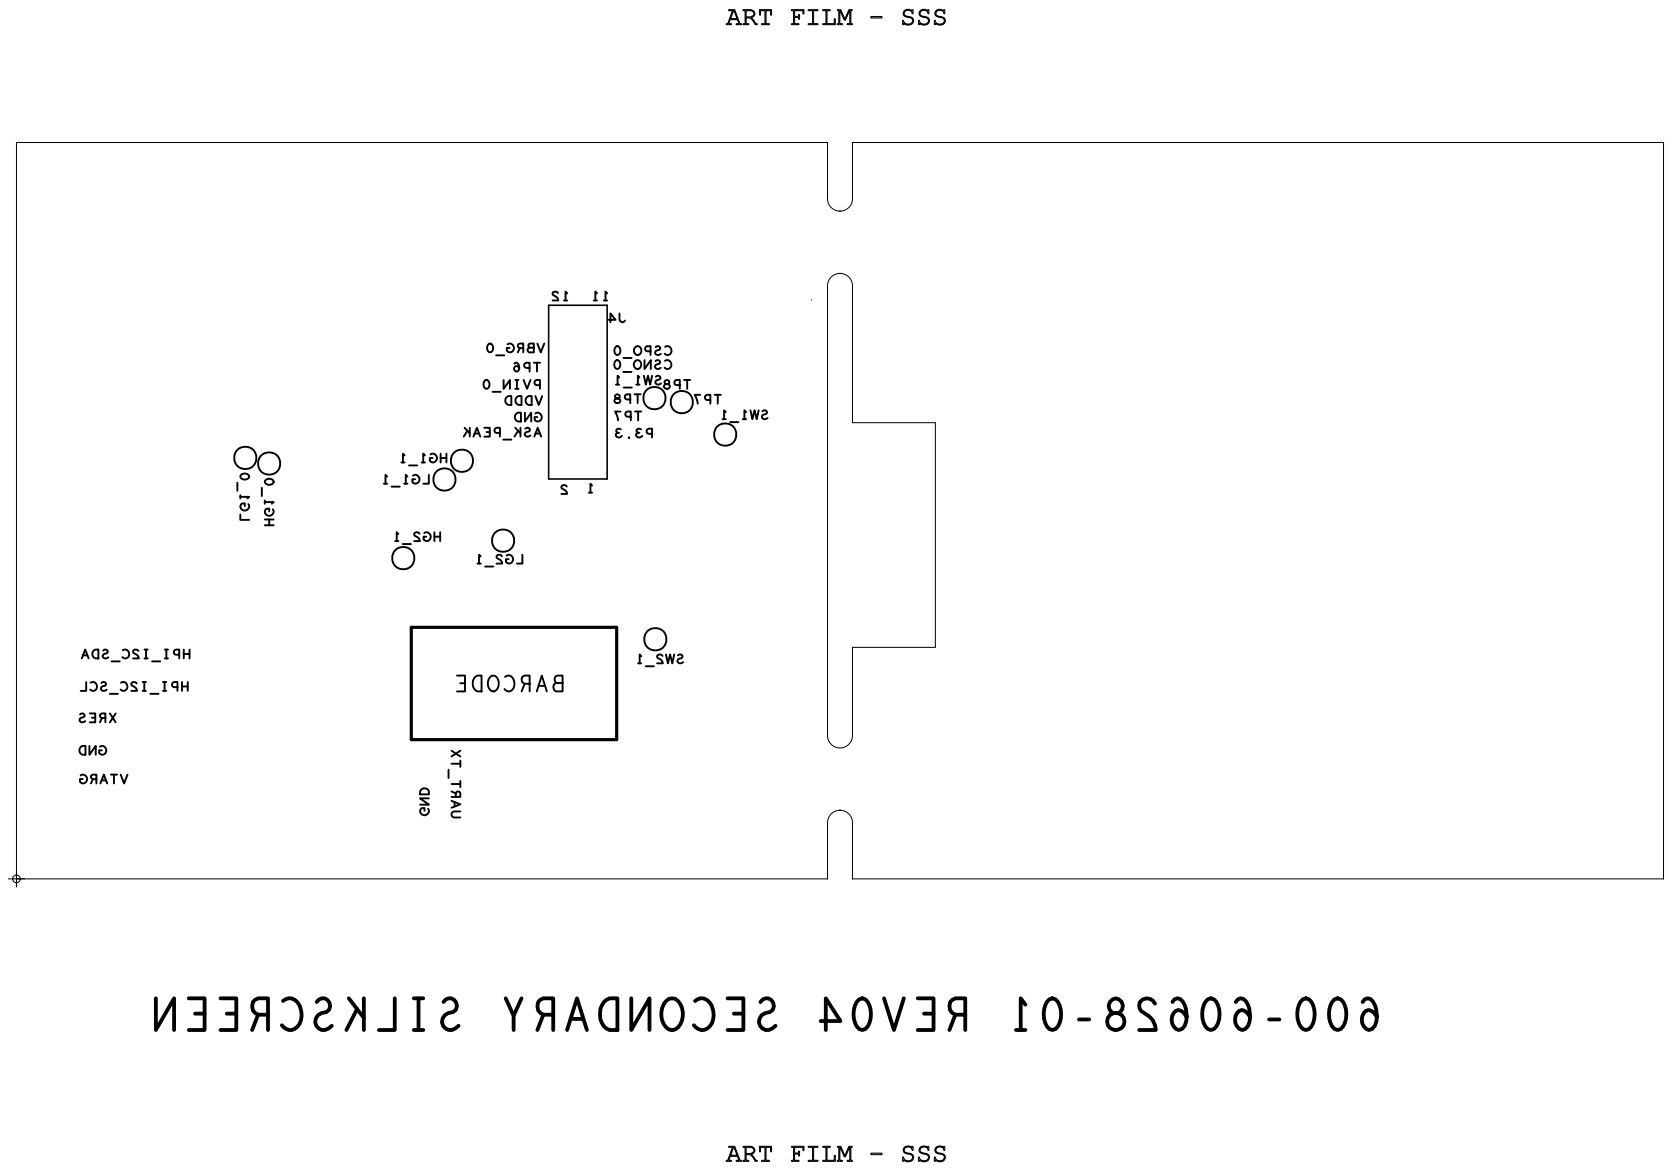
[picture p31: page 9]
VTARG; GND; XRES; HPI_I2C_SDA; HPI_I2C_SCL; 600-60628-01 REV04 SECONDARY SILKSCREEN; UART_TX; BARCODE; ASK_PEAK; PVIN_0; VBRG_0; VDDD; CSPO_0 CSNO_0

ART FILM - SSS
