niruvibes/elec3117proj/tmp/layout-analysis/guideline-3d.png

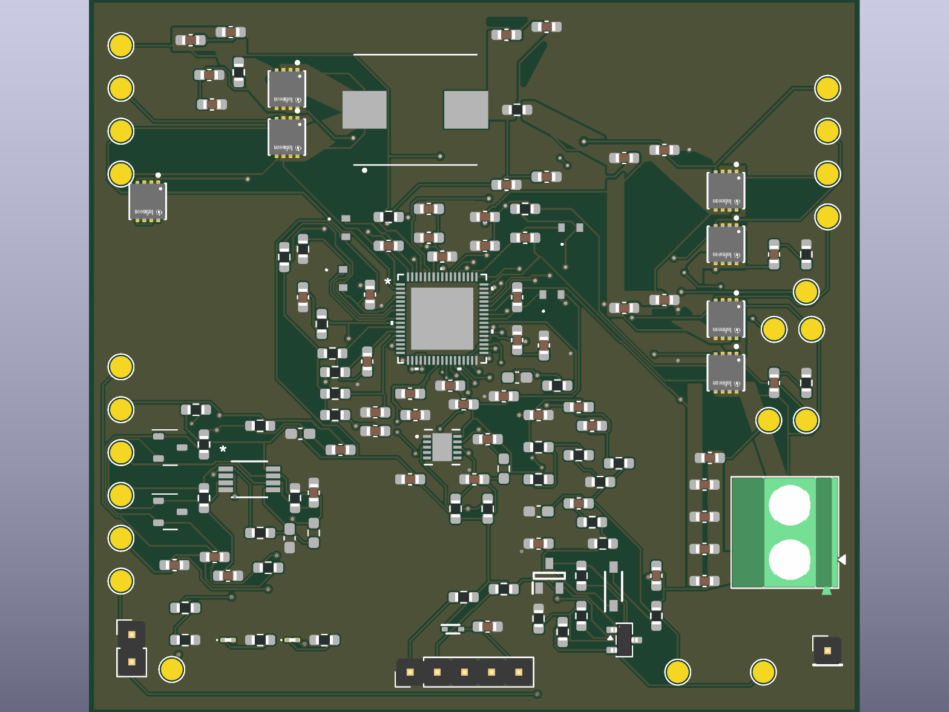
tmp/layout-analysis/guideline-3d.png
