niruvibes/elec3117proj/tmp/pdfs/designguideline-36.png

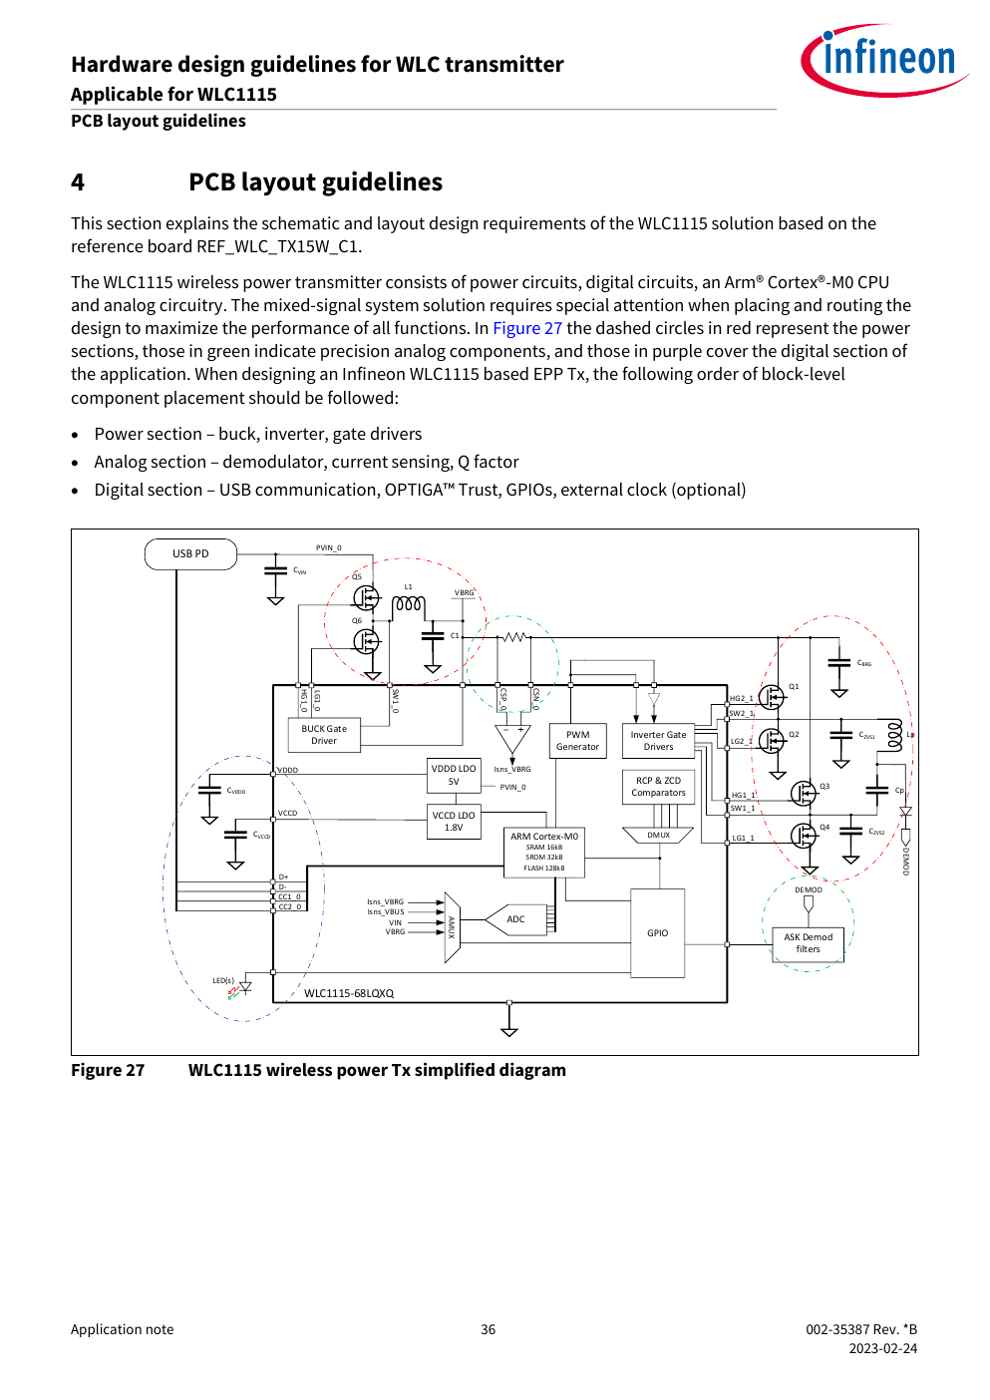
tmp/pdfs/designguideline-36.png
