niruvibes/elec3117proj/tmp/pdfs/designguideline-37.png

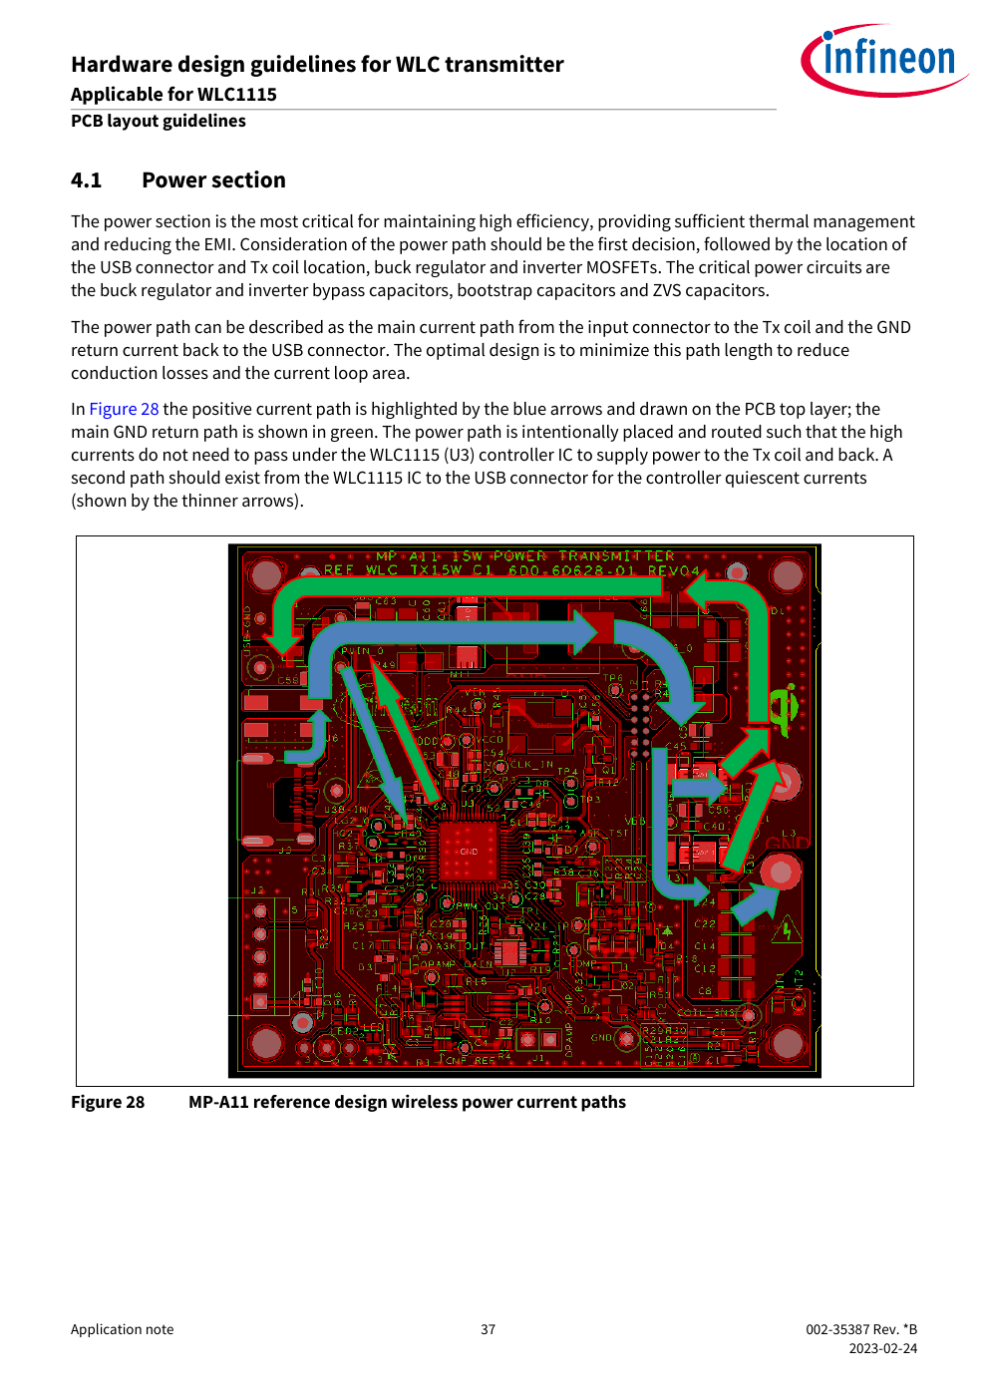
tmp/pdfs/designguideline-37.png
