niruvibes/elec3117proj/tmp/pdfs/designguideline-38.png

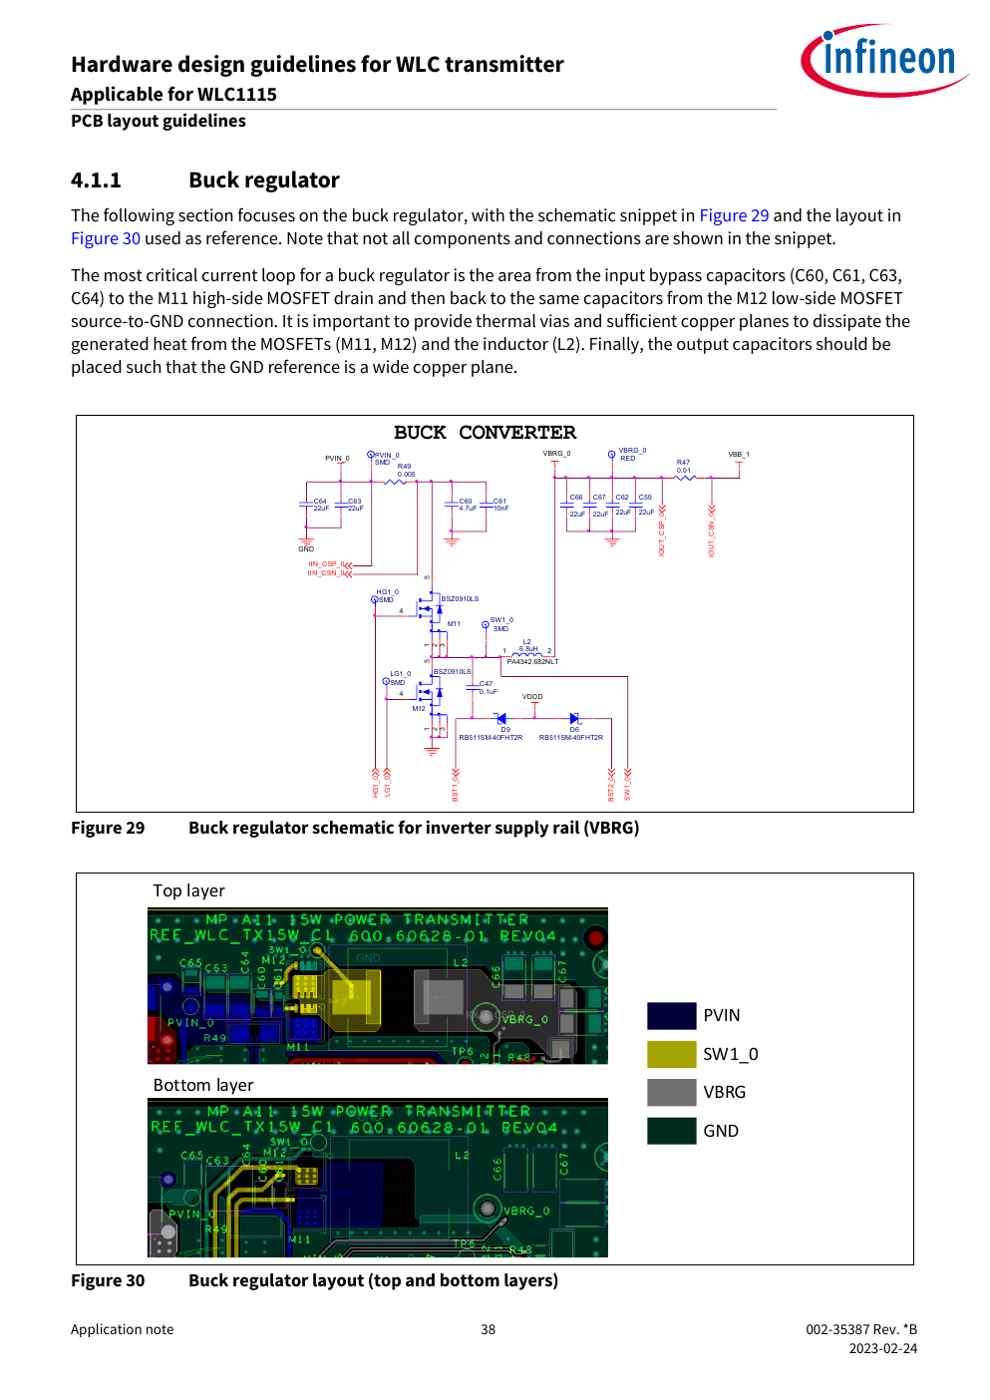
tmp/pdfs/designguideline-38.png
