niruvibes/elec3117proj/tmp/pdfs/designguideline-39.png

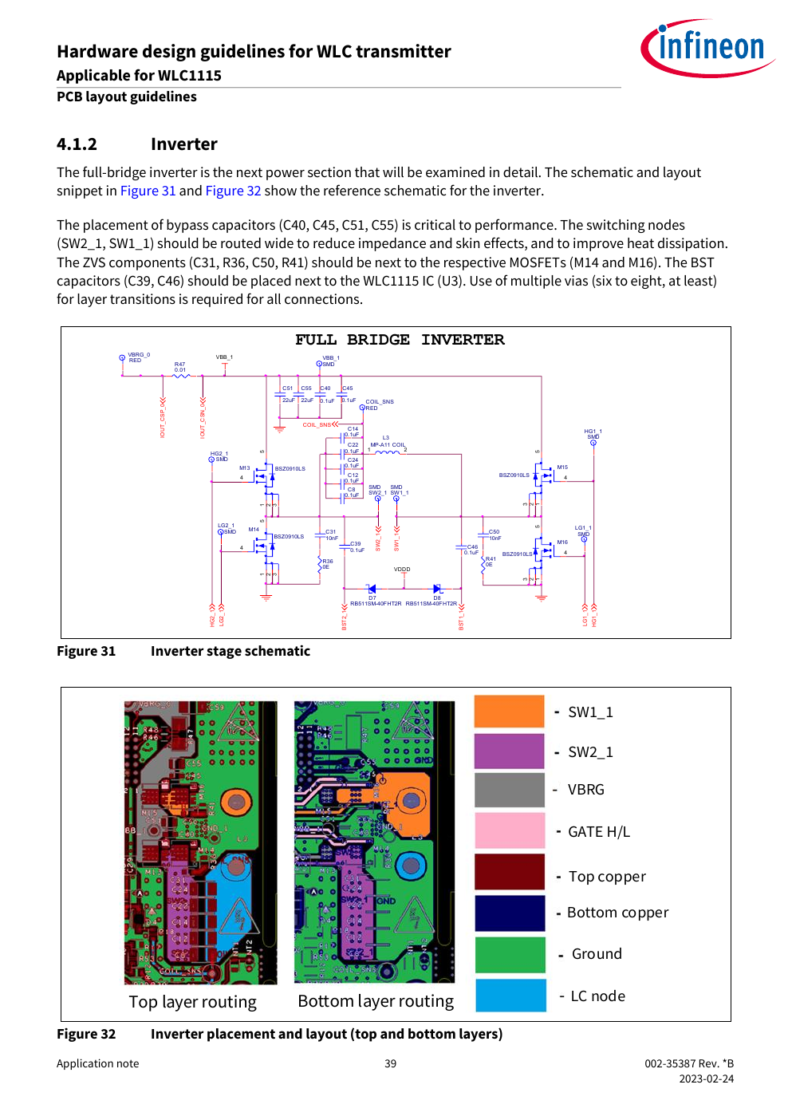
tmp/pdfs/designguideline-39.png
