niruvibes/elec3117proj/tmp/pdfs/designguideline-41.png

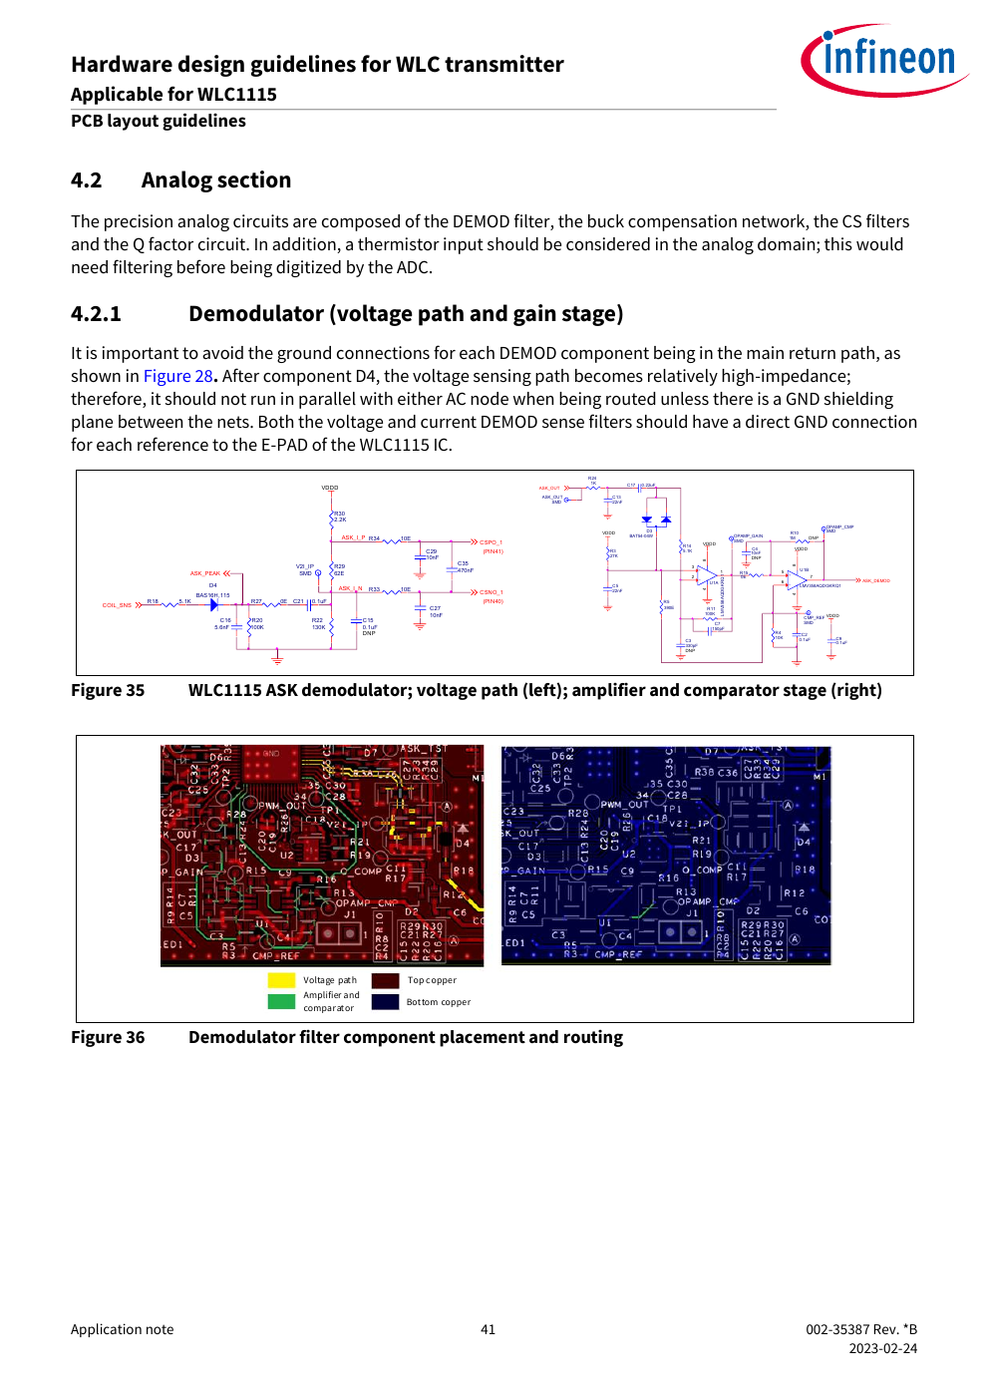
tmp/pdfs/designguideline-41.png
