niruvibes/elec3117proj/tmp/pdfs/designguideline-42.png

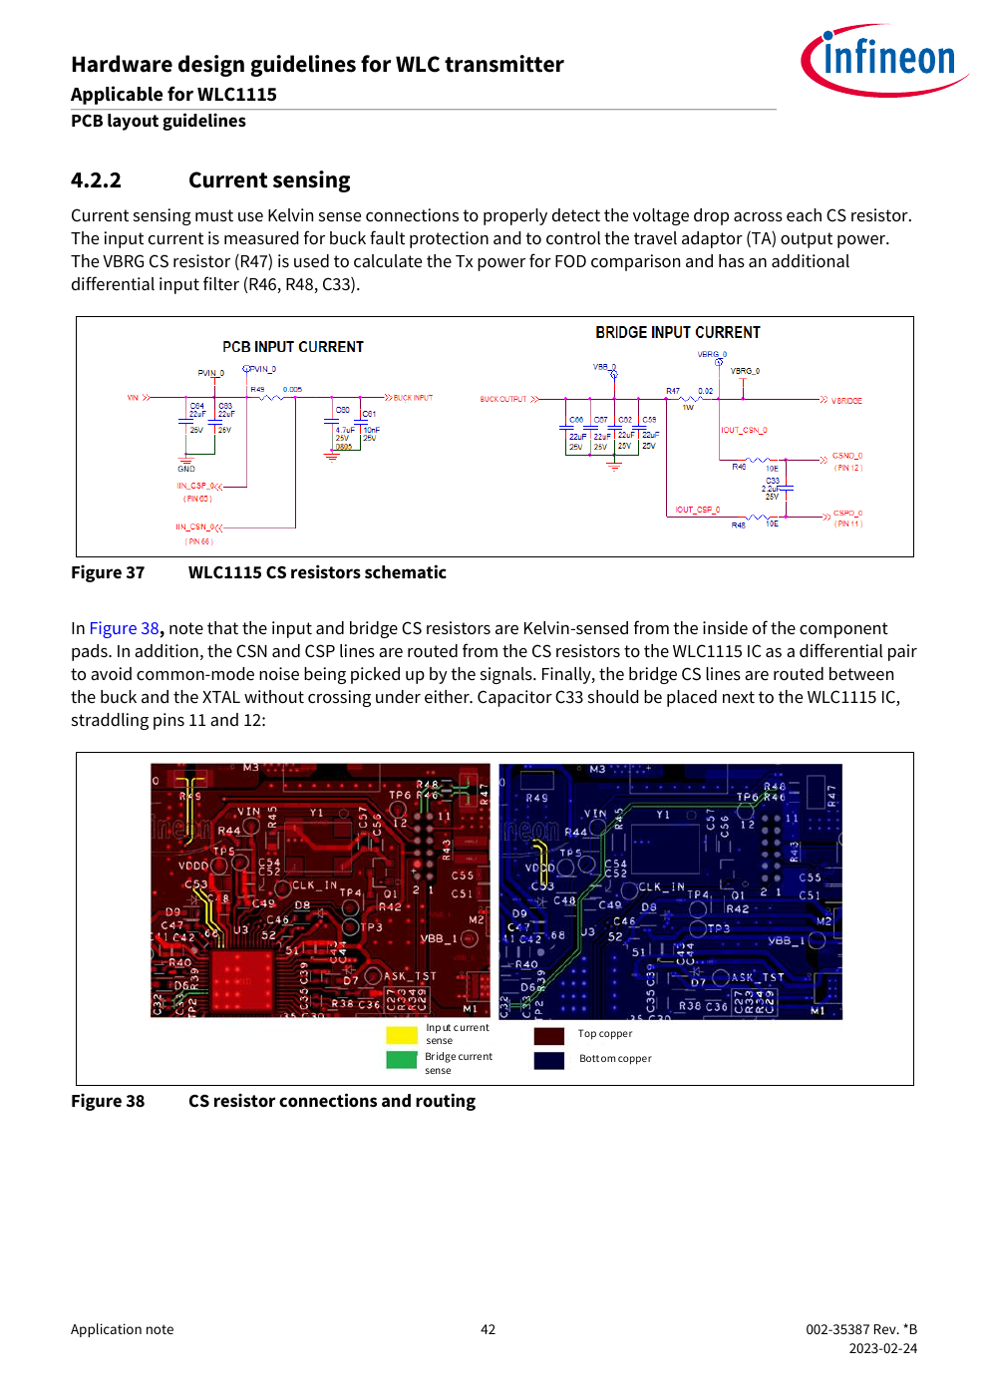
tmp/pdfs/designguideline-42.png
