niruvibes/elec3117proj/tmp/pdfs/designguideline-43.png

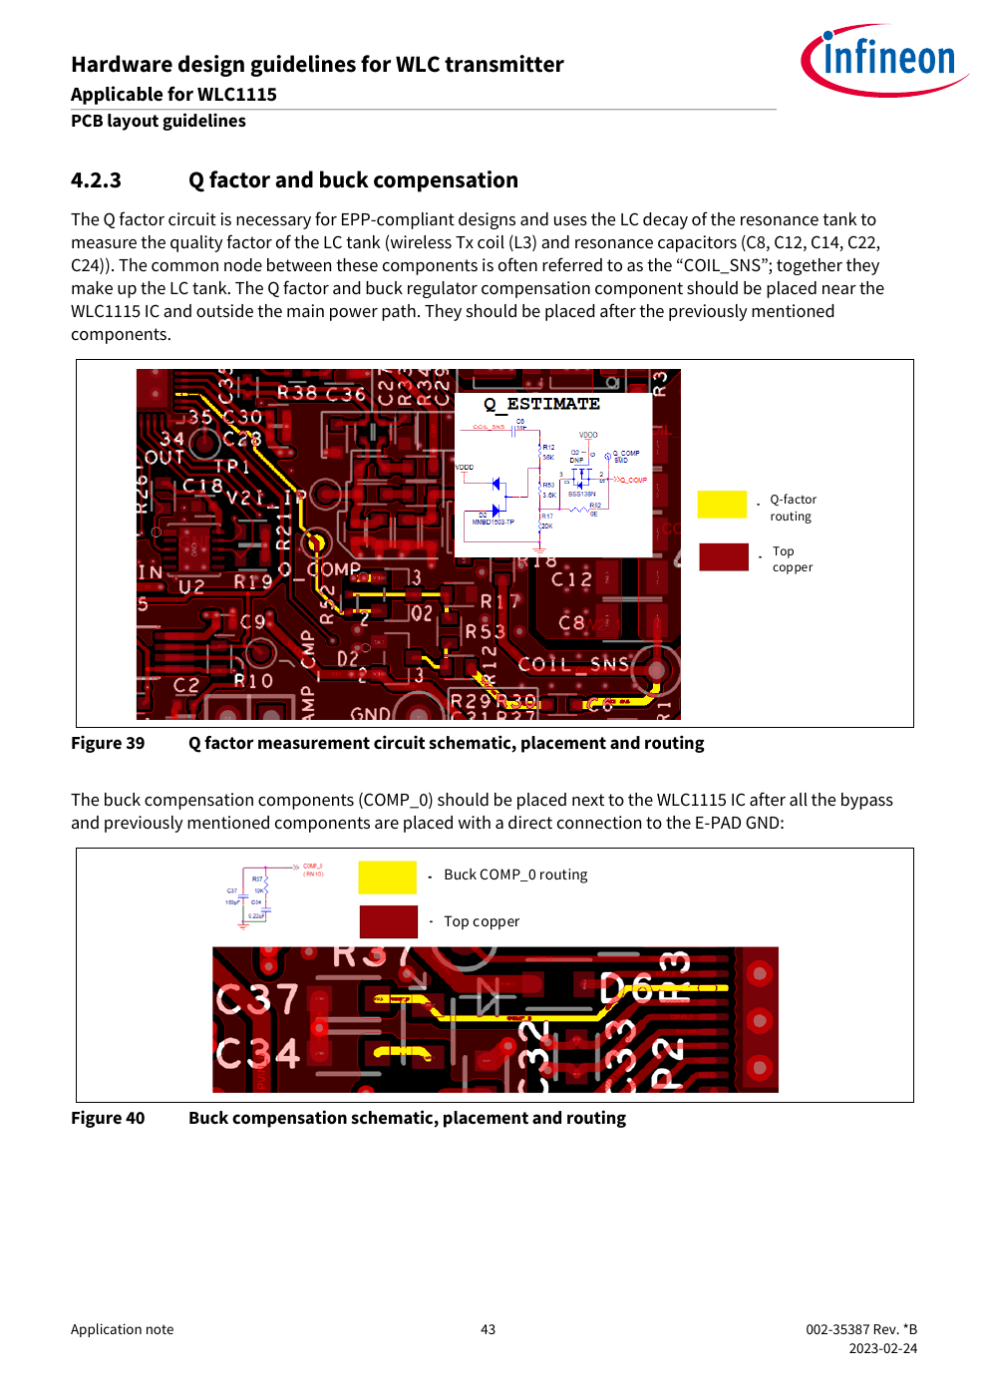
tmp/pdfs/designguideline-43.png
