niruvibes/elec3117proj/tmp/pdfs/designguideline-44.png

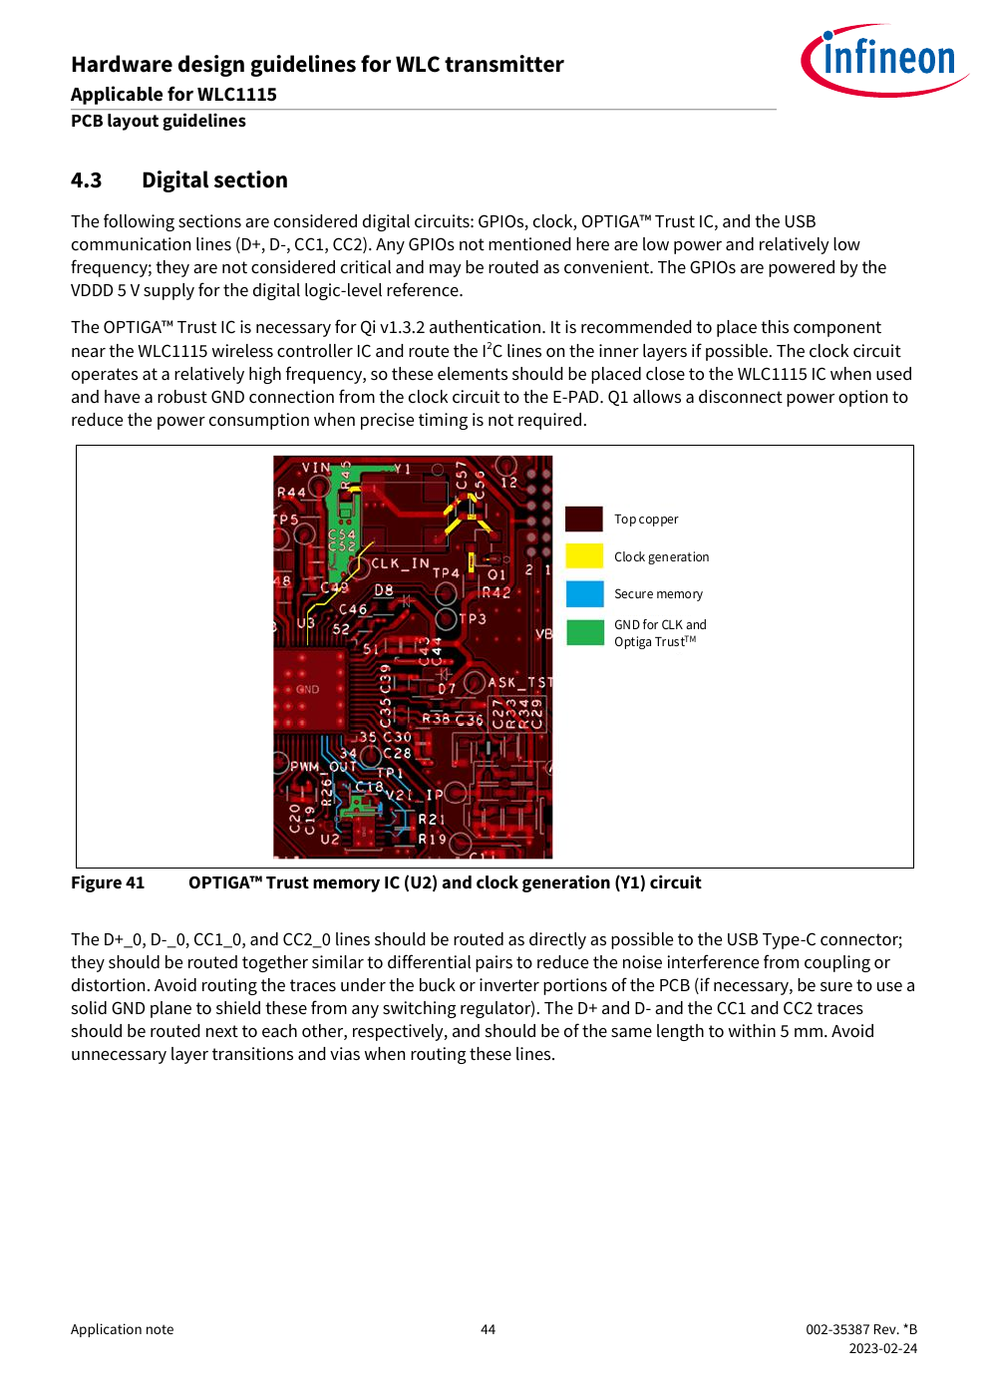
tmp/pdfs/designguideline-44.png
