niruvibes/elec3117proj/tmp/pdfs/designguideline-45.png

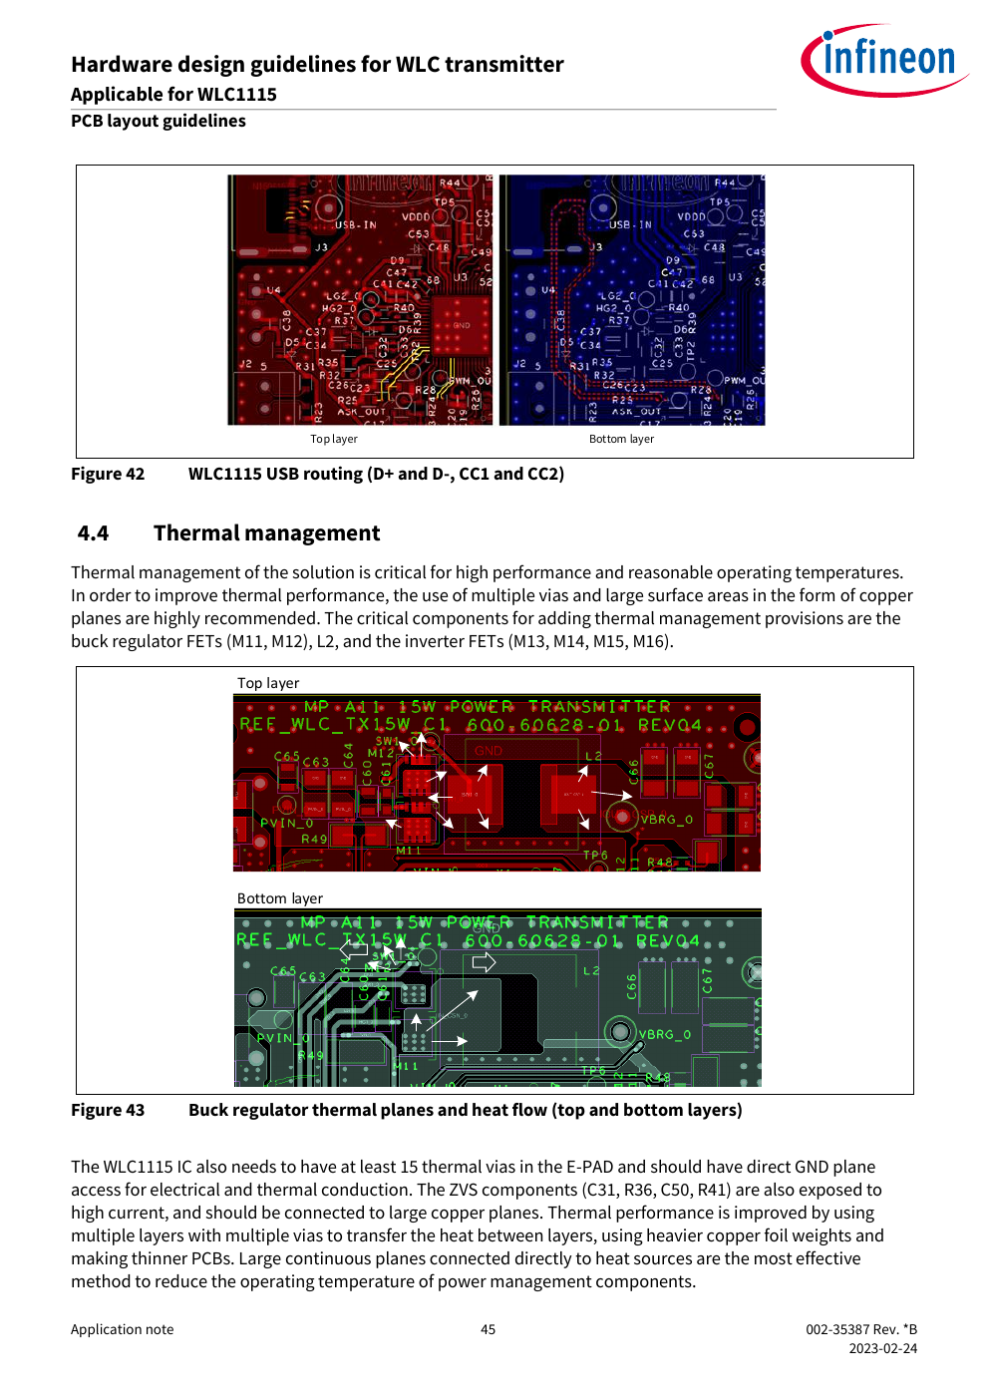
tmp/pdfs/designguideline-45.png
