niruvibes/elec3117proj/tmp/pdfs/designguideline-46.png

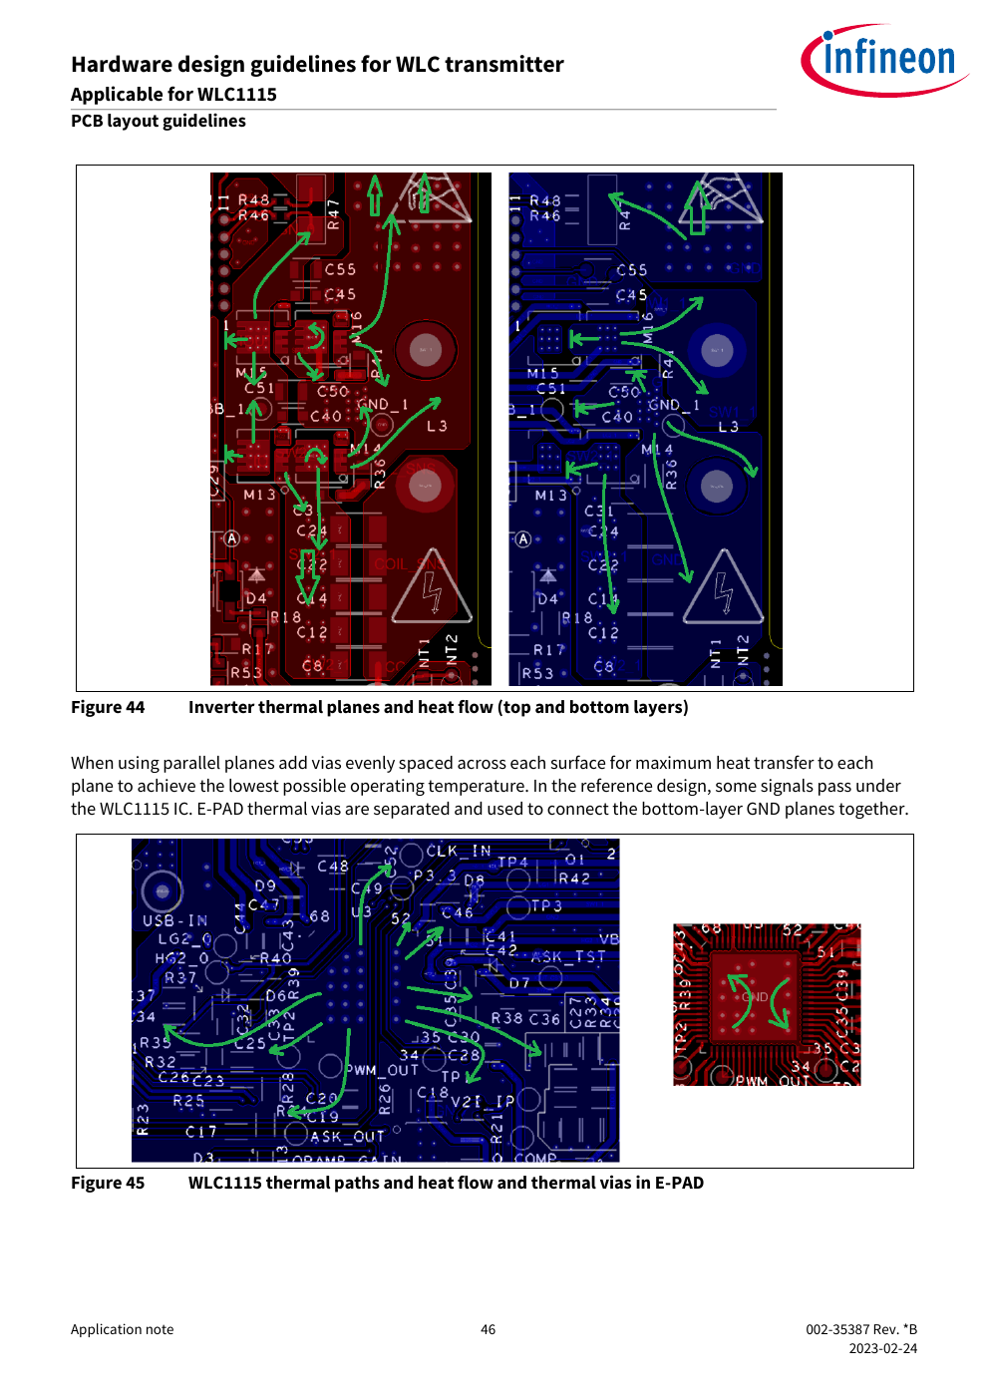
tmp/pdfs/designguideline-46.png
