niruvibes/elec3117proj/tmp/pdfs/designguideline-47.png

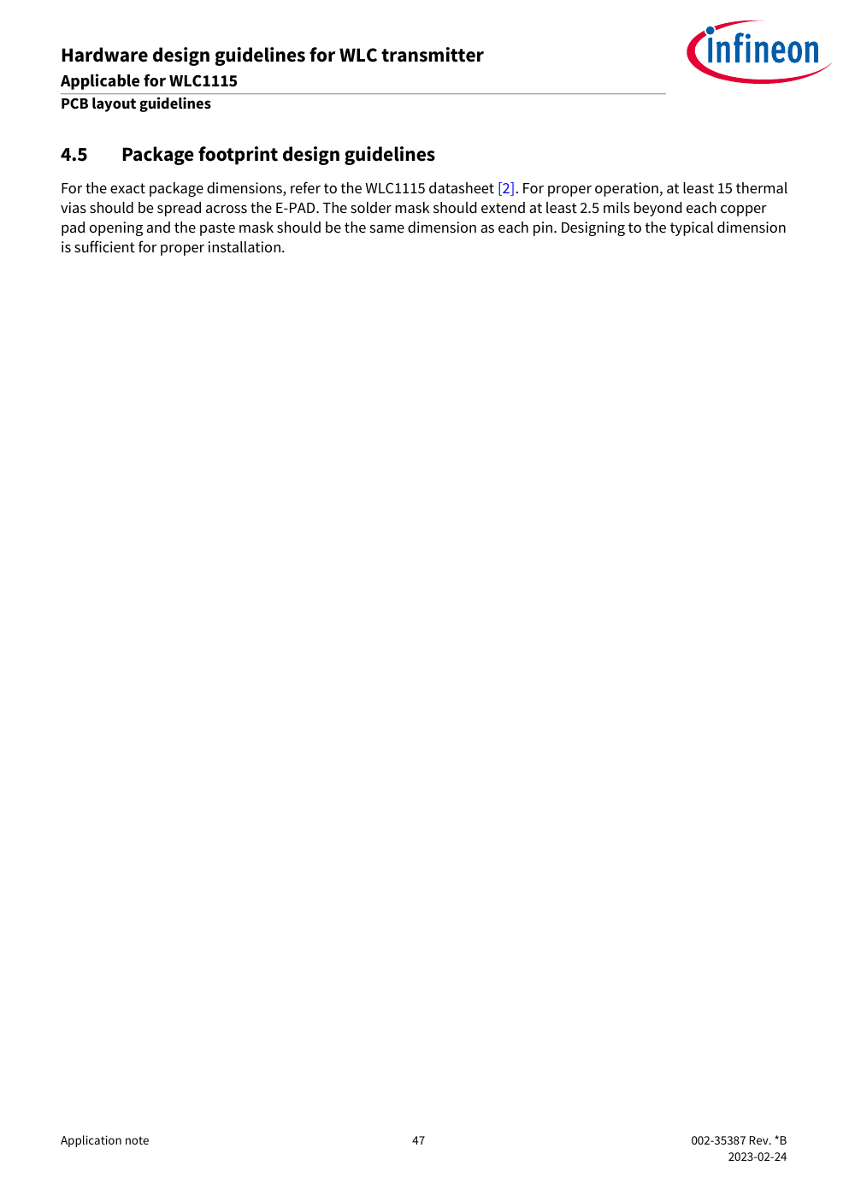
tmp/pdfs/designguideline-47.png
