niruvibes/elec3117proj/tmp/pdfs/designguideline-48.png

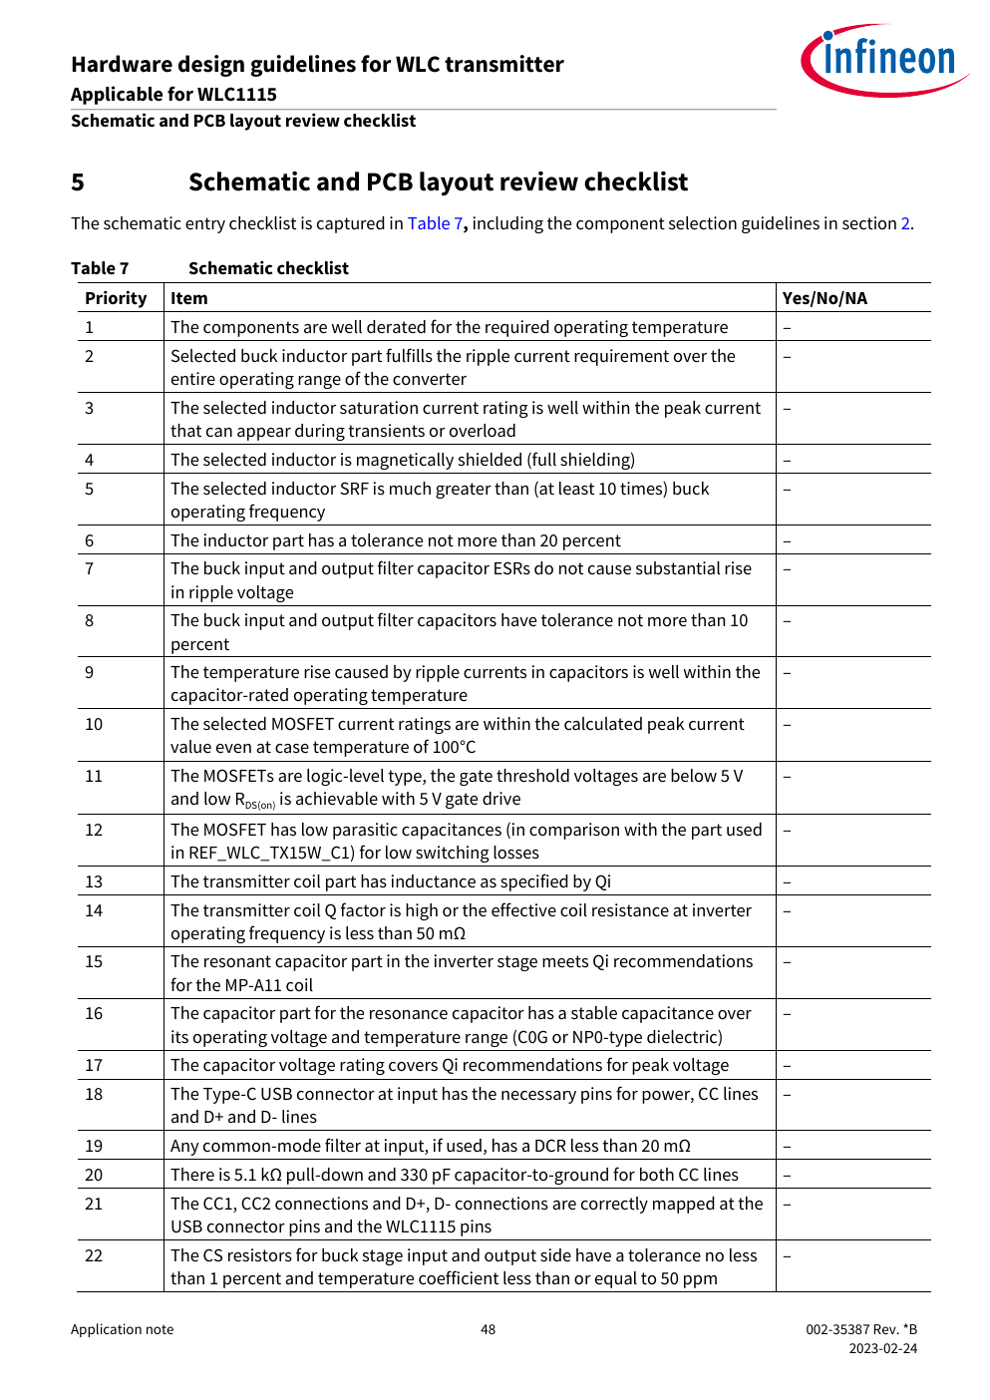
tmp/pdfs/designguideline-48.png
