niruvibes/elec3117proj/tmp/pdfs/designguideline-49.png

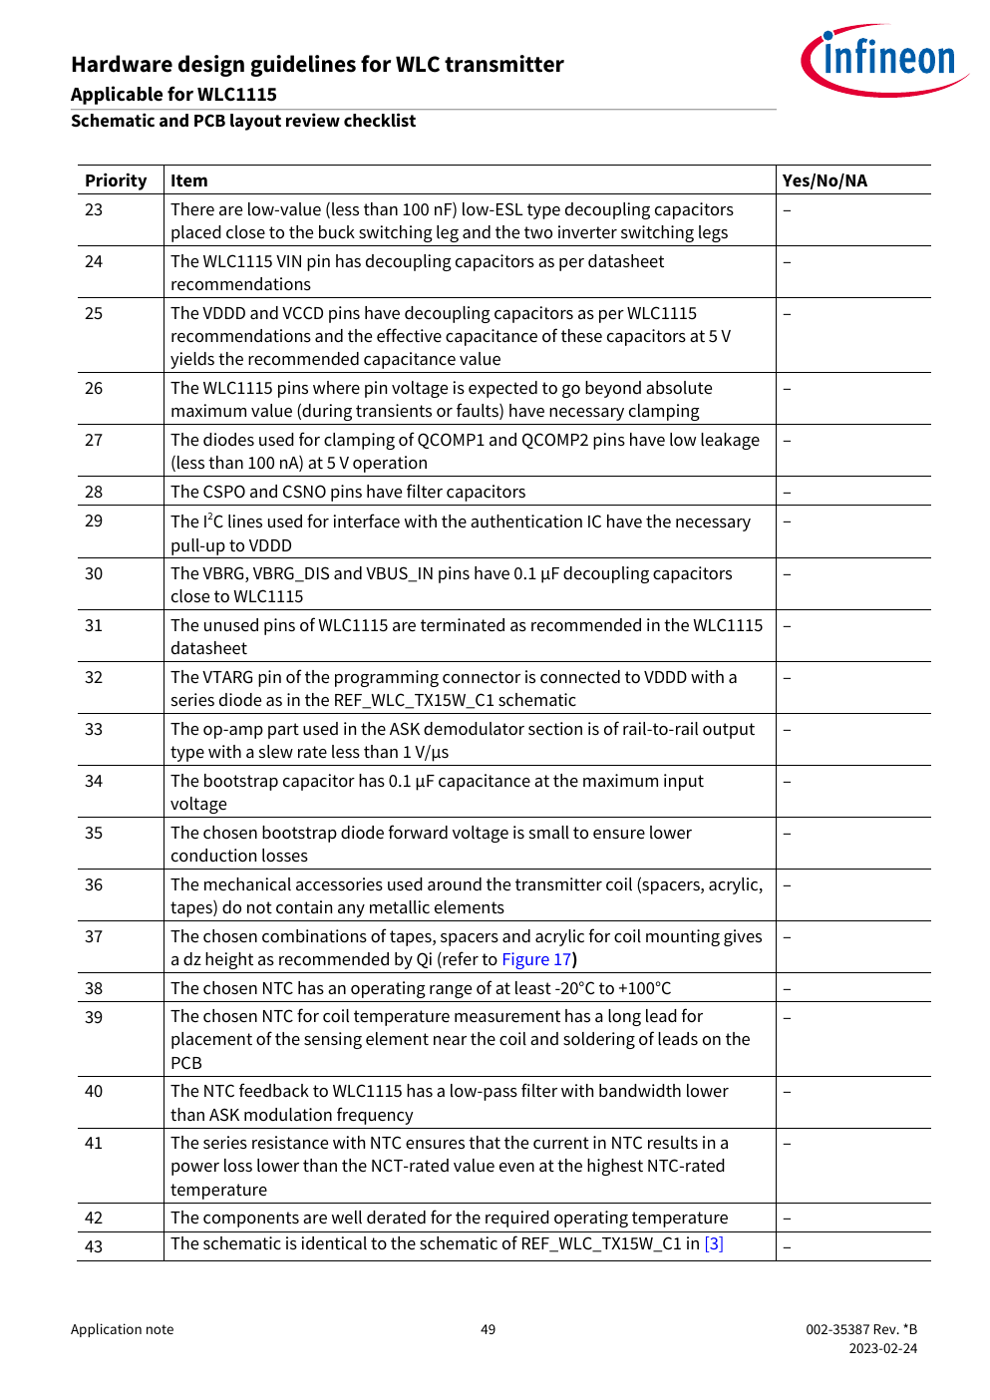
tmp/pdfs/designguideline-49.png
