niruvibes/elec3117proj/tmp/pdfs/designguideline-50.png

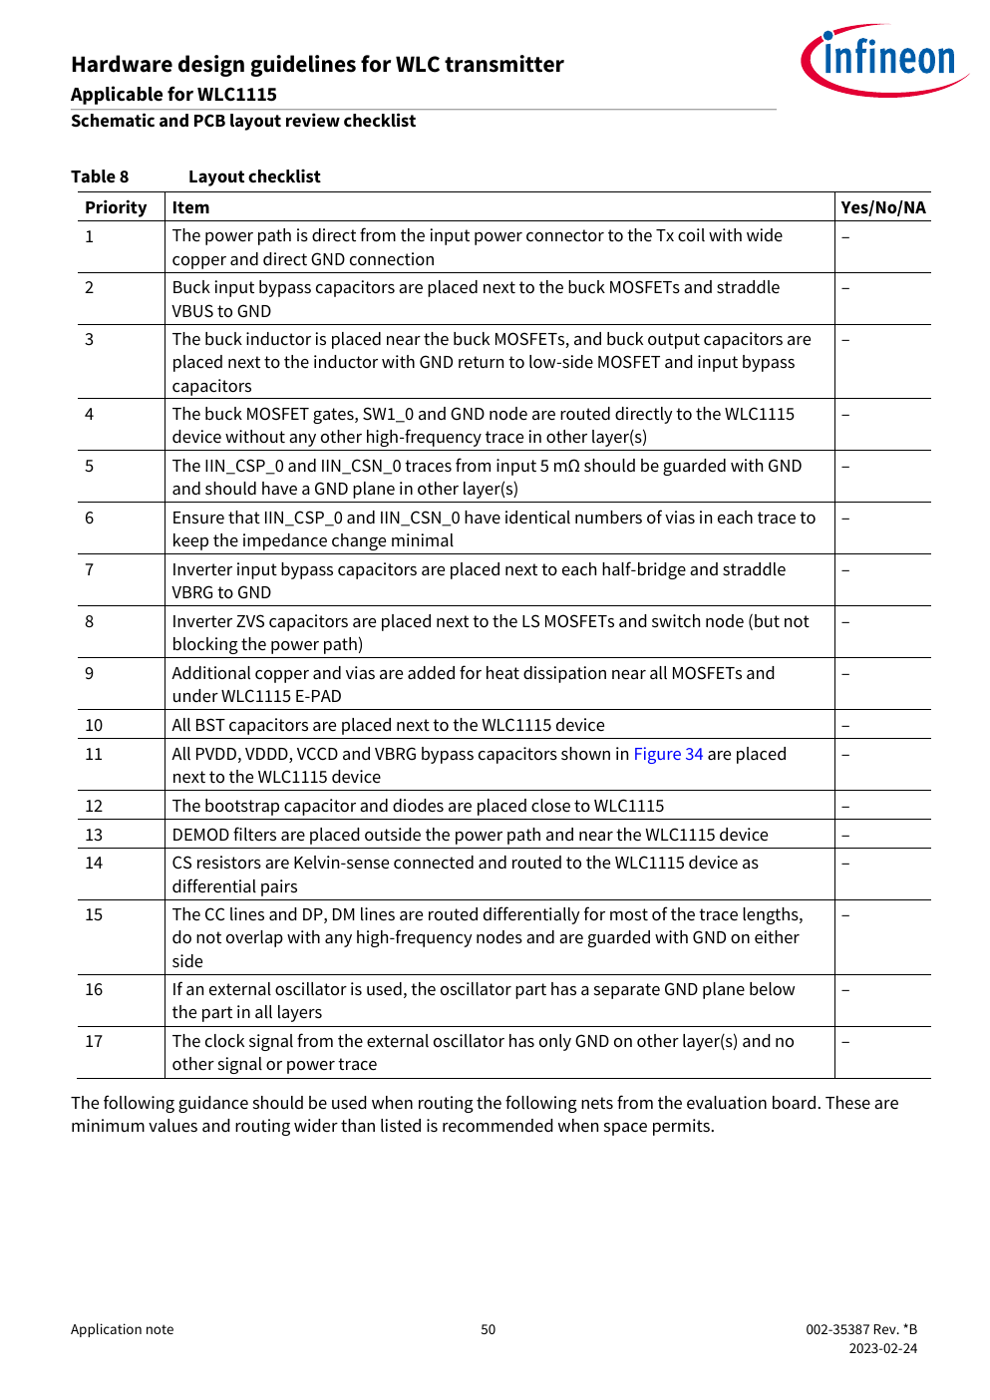
tmp/pdfs/designguideline-50.png
