niruvibes/elec3117proj/tmp/pdfs/designguideline-51.png

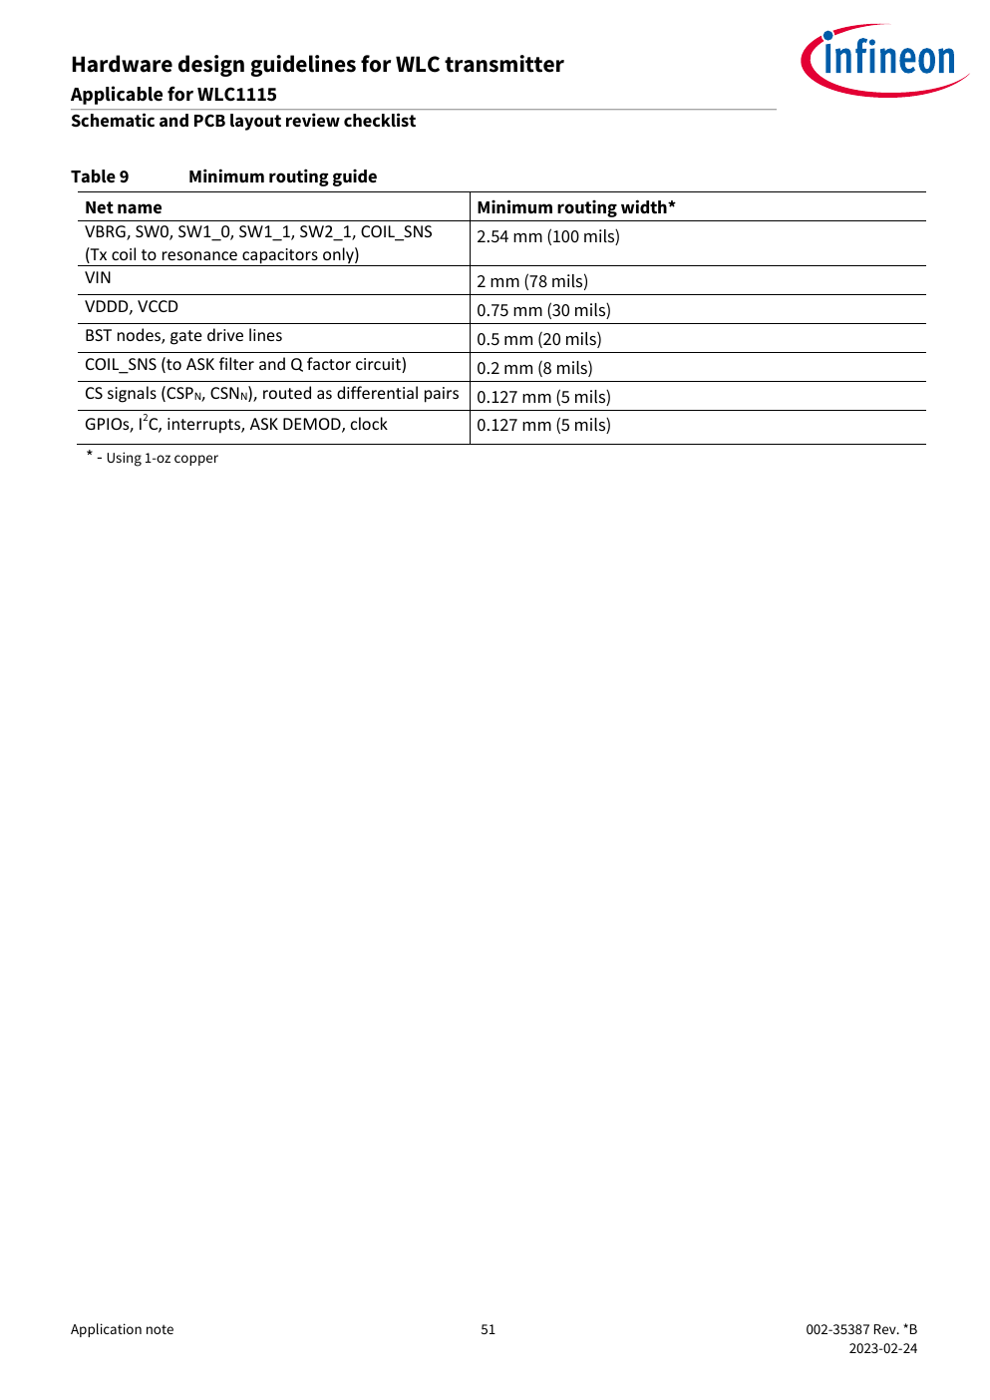
tmp/pdfs/designguideline-51.png
