niruvibes/elec3117proj/tmp/pdfs/guideline-analog-digital.jpg

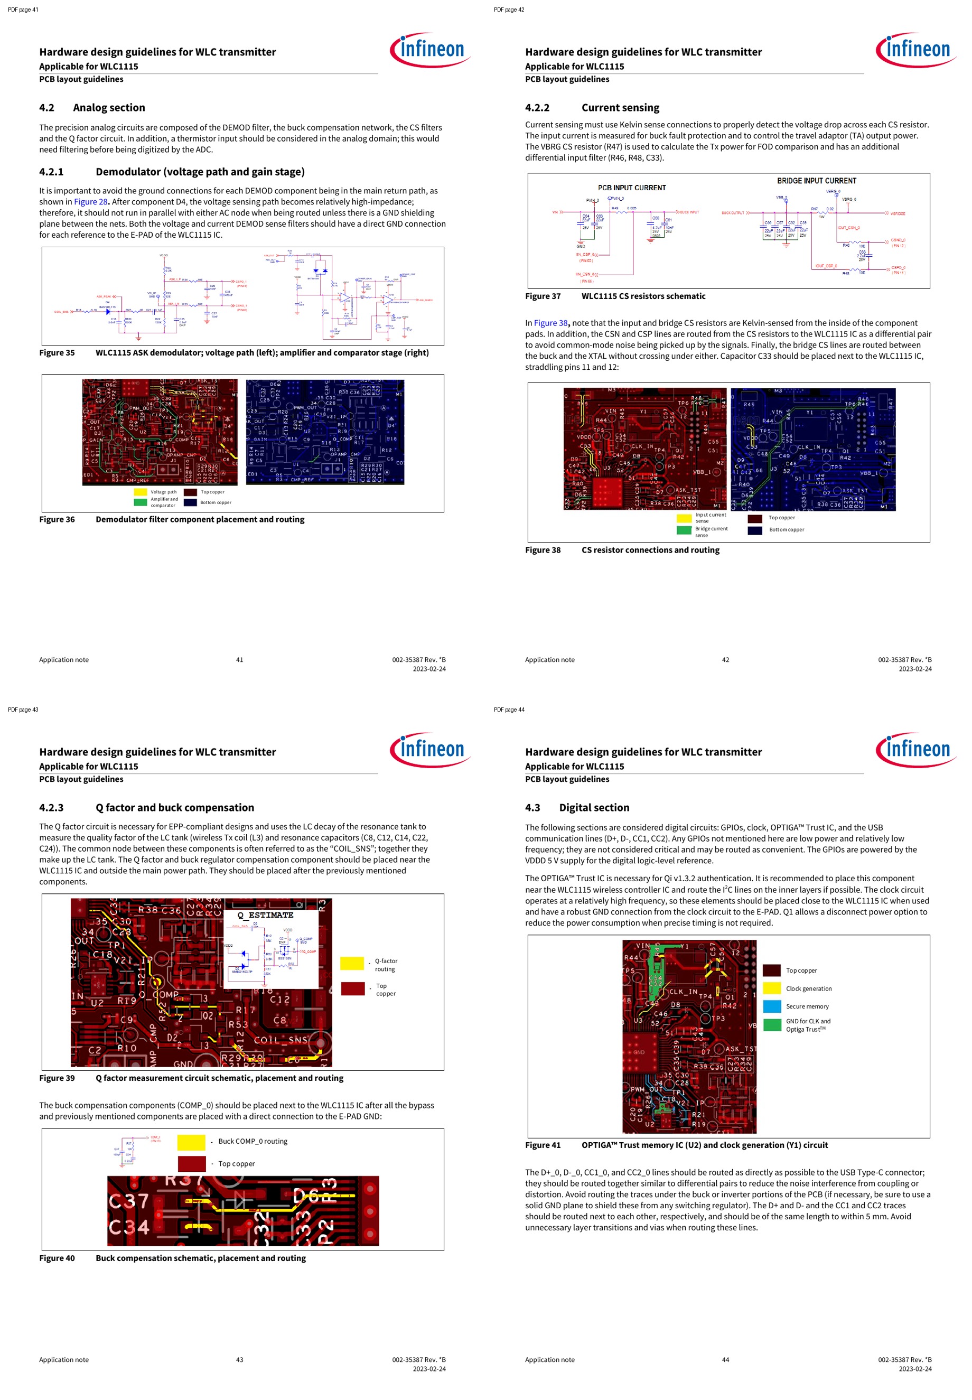
tmp/pdfs/guideline-analog-digital.jpg
