niruvibes/elec3117proj/tmp/pdfs/guideline-thermal-checklist.jpg

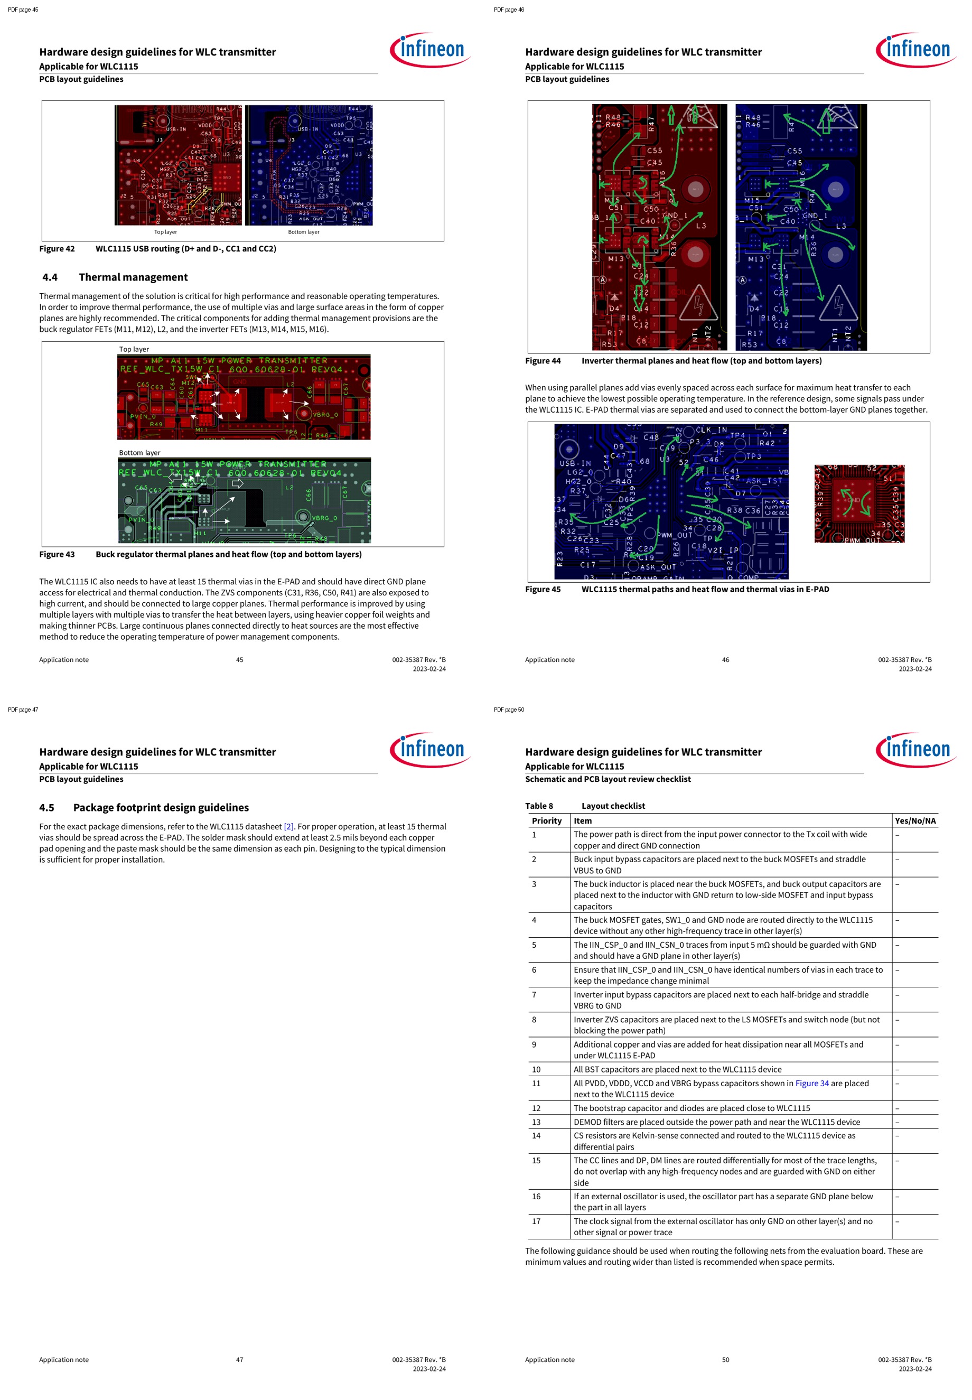
tmp/pdfs/guideline-thermal-checklist.jpg
