niruvibes/elec3117proj/(list of files, drawings)

Other design files:
components/nfet/BSZ0902NS.SchLib
components/nfet/IFX-PG-TSDSON-8-26-V.PcbLib
other/REF_WLC_TX15W_C1-MP A11 15W POWER TRANSMITTER REV05.DSN
tmp/layout-analysis/pcb-before.json
tmp/layout-analysis/project.fresh-relaxed.dsn
tmp/layout-analysis/project.placed.dsn
tmp/layout-analysis/project.second-pass.dsn
tmp/layout-analysis/schematic-before.json
