niruvibes/elec3117proj/project.kicad_pcb

## KiCad design project.kicad_pcb (2026-07-18)

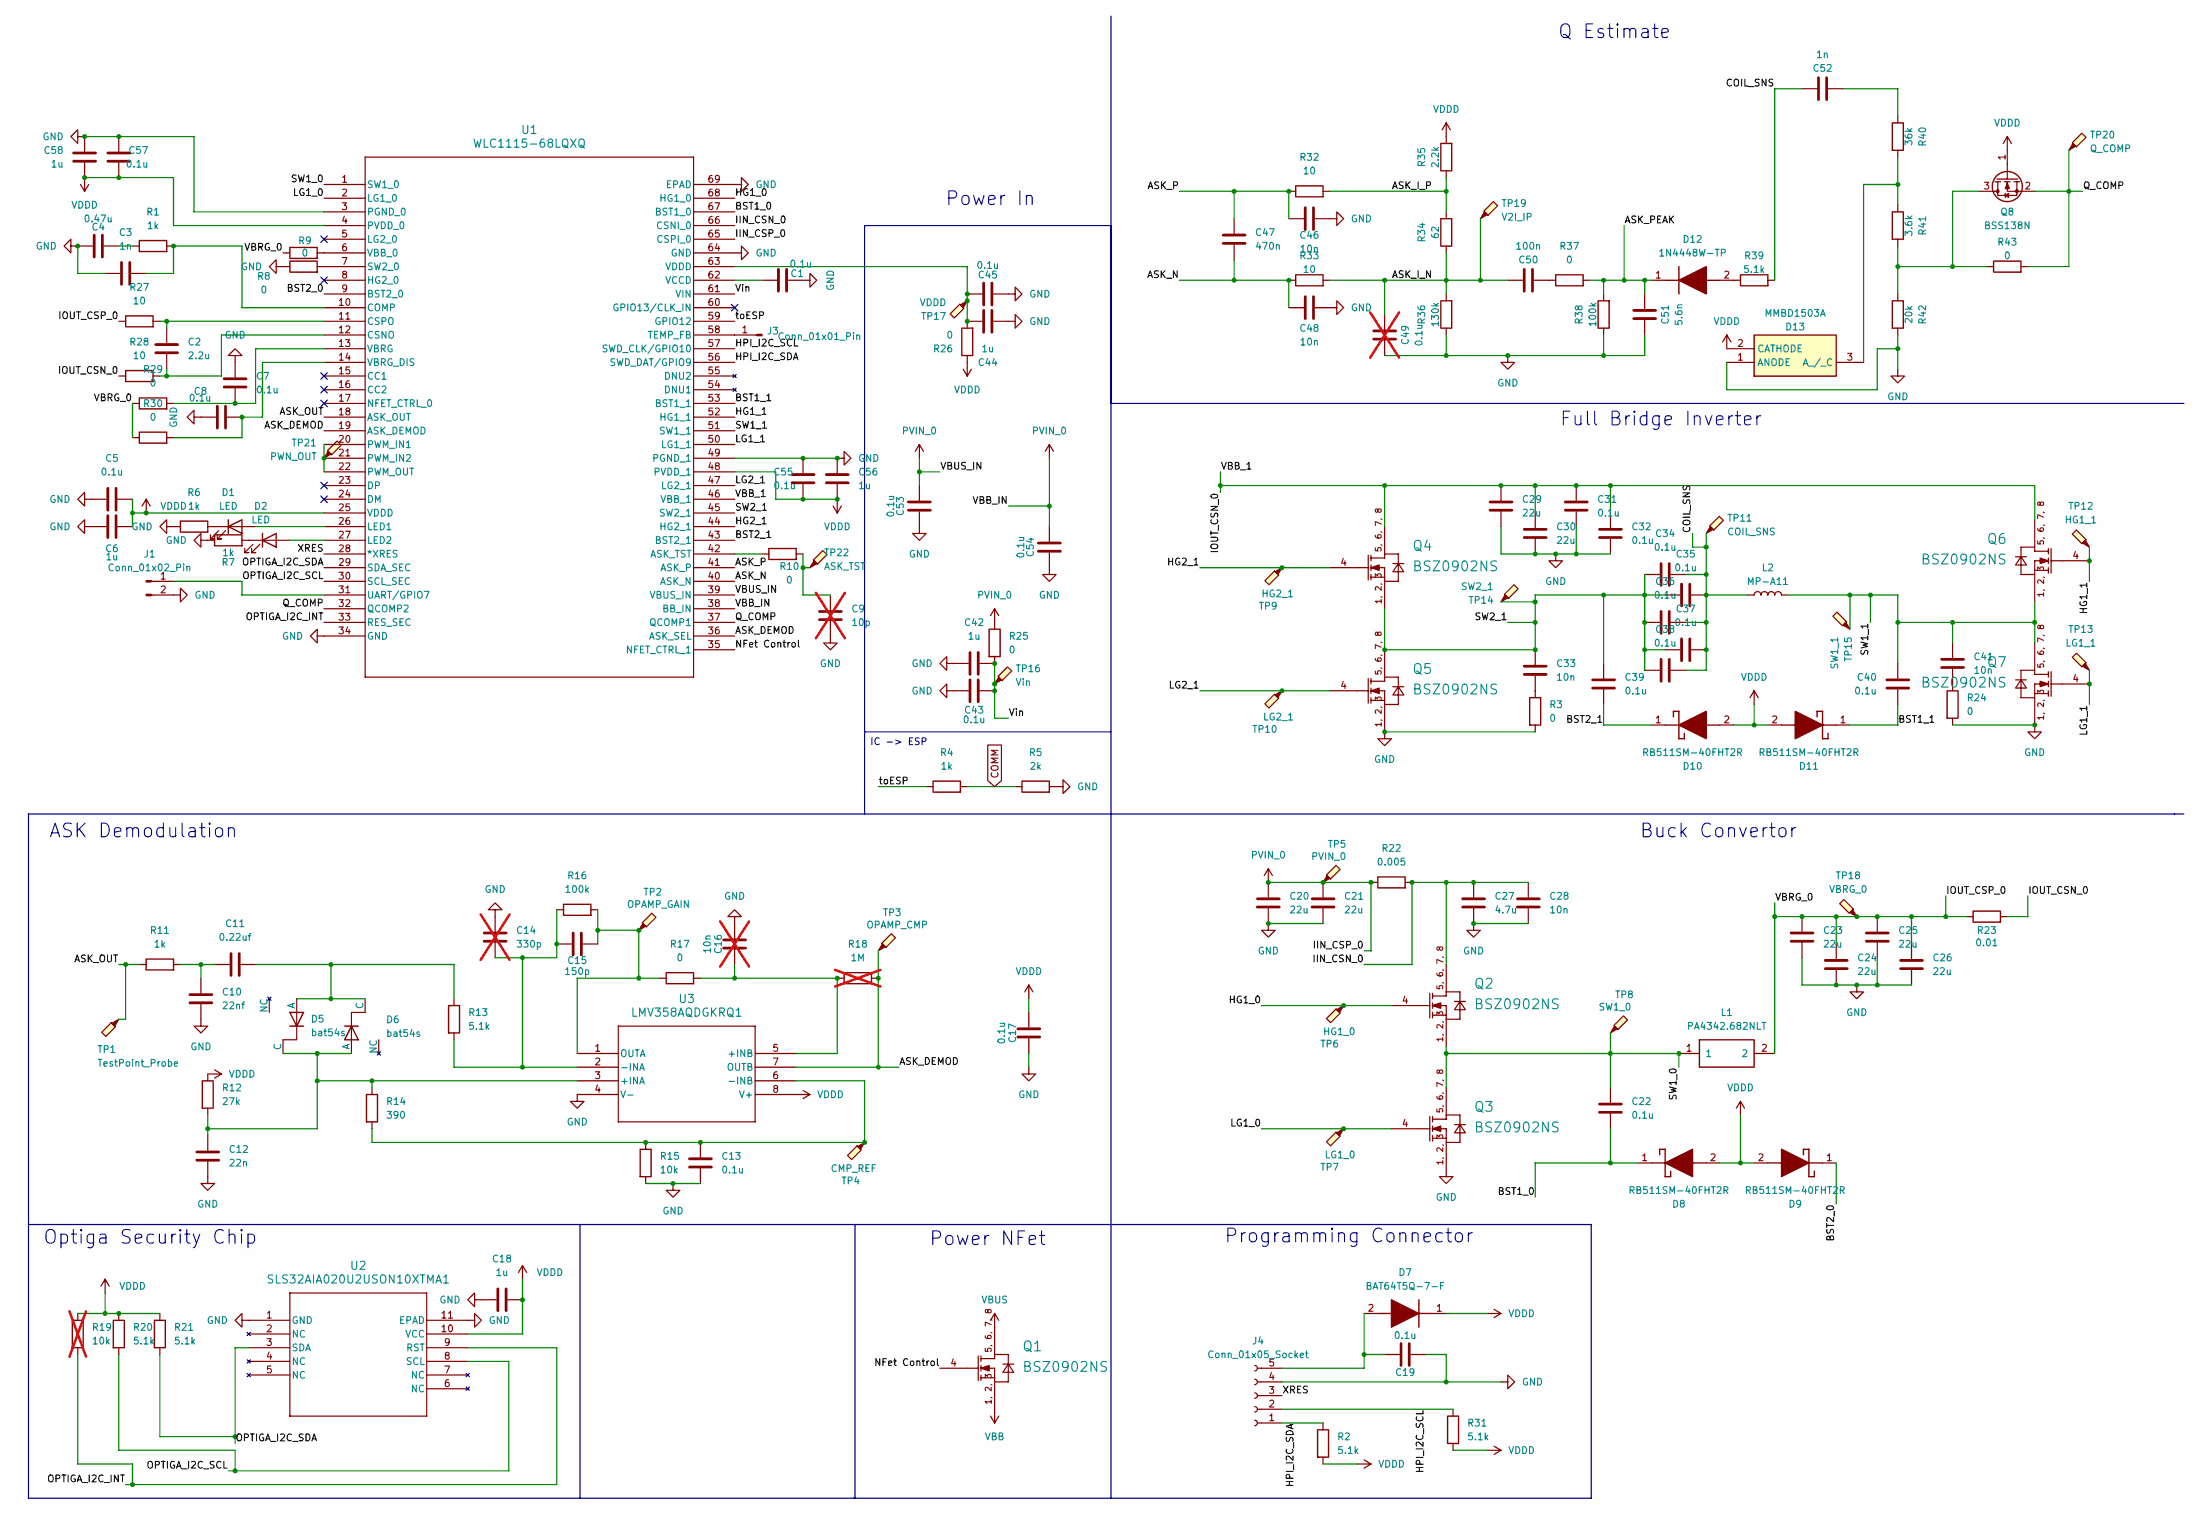
[picture p50: schematic project.kicad_sch]

Parts:
C1, C5, C7, C8, C13, C17, C19, C22, C31, C32, C34, C35, C36, C37, C38, C39, C40, C43, C45, C53, C54, C55, C57: 0.1u; C_0603_1608Metric_Pad1.08x0.95mm_HandSolder
C2: 2.2u; C_0603_1608Metric_Pad1.08x0.95mm_HandSolder
C3, C52: 1n; C_0603_1608Metric_Pad1.08x0.95mm_HandSolder
C4: 0.47u; C_0603_1608Metric_Pad1.08x0.95mm_HandSolder
C6, C18, C42, C44, C56, C58: 1u; C_0603_1608Metric_Pad1.08x0.95mm_HandSolder
C9: 10p; C_0603_1608Metric_Pad1.08x0.95mm_HandSolder; not fitted
C10: 22nf; C_0603_1608Metric_Pad1.08x0.95mm_HandSolder
C11: 0.22uf; C_0603_1608Metric_Pad1.08x0.95mm_HandSolder
C12: 22n; C_0603_1608Metric_Pad1.08x0.95mm_HandSolder
C14: 330p; C_0603_1608Metric_Pad1.08x0.95mm_HandSolder; not fitted
C15: 150p; C_0603_1608Metric_Pad1.08x0.95mm_HandSolder
C16: 10n; C_0603_1608Metric_Pad1.08x0.95mm_HandSolder; not fitted
C20, C21, C23, C24, C25, C26, C29, C30: 22u; C_0603_1608Metric_Pad1.08x0.95mm_HandSolder
C27: 4.7u; C_0603_1608Metric_Pad1.08x0.95mm_HandSolder
C28, C33, C41, C46, C48: 10n; C_0603_1608Metric_Pad1.08x0.95mm_HandSolder
C47: 470n; C_0603_1608Metric_Pad1.08x0.95mm_HandSolder
C49: 0.1u; C_0603_1608Metric_Pad1.08x0.95mm_HandSolder; not fitted
C50: 100n; C_0603_1608Metric_Pad1.08x0.95mm_HandSolder
C51: 5.6n; C_0603_1608Metric_Pad1.08x0.95mm_HandSolder
D1, D2: LED; LED_0201_0603Metric_Pad0.64x0.40mm_HandSolder
D5, D6: bat54s; P200_SOT-23
D7: BAT64T5Q-7-F; SODFL1608X65N; Manufacturer_Part_Number BAT64T5Q-7-F; Mouser Part Number 621-BAT64T5Q-7-F
D8, D9, D10, D11: RB511SM-40FHT2R; RB511SM40FHT2R; Manufacturer_Part_Number RB511SM-40FHT2R; Mouser Part Number 755-RB511SM-40FHT2R
D12: 1N4448W-TP; SOD3716X135N; Manufacturer_Part_Number 1N4448W-TP; Mouser Part Number 833-1N4448W-TP
D13: MMBD1503A; SOT95P240X120-3N; Manufacturer_Part_Number MMBD1503A; Mouser Part Number 512-MMBD1503A
J1: Conn_01x02_Pin; PinHeader_1x02_P2.54mm_Vertical
J3: Conn_01x01_Pin; PinHeader_1x01_P2.54mm_Vertical
J4: Conn_01x05_Socket; PinHeader_1x05_P2.54mm_Vertical
L1: PA4342.682NLT; Yageo_Pulse_PA4342_10.3x11.5mm; MPN PA4342.682NLT
L2: MP-A11; TerminalBlock_Phoenix_MKDS-1,5-2-5.08_1x02_P5.08mm_Horizont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
Q1, Q2, Q3, Q4, Q5, Q6, Q7: BSZ0902NS; IFX-PG-TSDSON-8-26-V
Q8: BSS138N; SOT-23
R1, R4, R6, R7, R11: 1k; R_0603_1608Metric_Pad0.98x0.95mm_HandSolder
R2, R13, R20, R21, R31, R39: 5.1k; R_0603_1608Metric_Pad0.98x0.95mm_HandSolder
R3, R8, R9, R10, R17, R24, R25, R26, R29, R30, R37, R43: 0; R_0603_1608Metric_Pad0.98x0.95mm_HandSolder
R5: 2k; R_0603_1608Metric_Pad0.98x0.95mm_HandSolder
R12: 27k; R_0603_1608Metric_Pad0.98x0.95mm_HandSolder
R14: 390; R_0603_1608Metric_Pad0.98x0.95mm_HandSolder
R15: 10k; R_0603_1608Metric_Pad0.98x0.95mm_HandSolder
R16, R38: 100k; R_0603_1608Metric_Pad0.98x0.95mm_HandSolder
R18: 1M; R_0603_1608Metric_Pad0.98x0.95mm_HandSolder; not fitted
R19: 10k; R_0603_1608Metric_Pad0.98x0.95mm_HandSolder; not fitted
R22: 0.005; R_0603_1608Metric_Pad0.98x0.95mm_HandSolder
R23: 0.01; R_0603_1608Metric_Pad0.98x0.95mm_HandSolder
R27, R28, R32, R33: 10; R_0603_1608Metric_Pad0.98x0.95mm_HandSolder
R34: 62; R_0603_1608Metric_Pad0.98x0.95mm_HandSolder
R35: 2.2k; R_0603_1608Metric_Pad0.98x0.95mm_HandSolder
R36: 130k; R_0603_1608Metric_Pad0.98x0.95mm_HandSolder
R40: 36k; R_0603_1608Metric_Pad0.98x0.95mm_HandSolder
R41: 3.6k; R_0603_1608Metric_Pad0.98x0.95mm_HandSolder
R42: 20k; R_0603_1608Metric_Pad0.98x0.95mm_HandSolder
TP1: TestPoint_Probe; TestPoint_Pad_D2.0mm
TP2: OPAMP_GAIN; TestPoint_Pad_D2.0mm
TP3: OPAMP_CMP; TestPoint_Pad_D2.0mm
TP4: CMP_REF; TestPoint_Pad_D2.0mm
TP5: PVIN_0; TestPoint_Pad_D2.0mm
TP6: HG1_0; TestPoint_Pad_D2.0mm
TP7: LG1_0; TestPoint_Pad_D2.0mm
TP8: SW1_0; TestPoint_Pad_D2.0mm
TP9: HG2_1; TestPoint_Pad_D2.0mm
TP10: LG2_1; TestPoint_Pad_D2.0mm
TP11: COIL_SNS; TestPoint_Pad_D2.0mm
TP12: HG1_1; TestPoint_Pad_D2.0mm
TP13: LG1_1; TestPoint_Pad_D2.0mm
TP14: SW2_1; TestPoint_Pad_D2.0mm
TP15: SW1_1; TestPoint_Pad_D2.0mm
TP16: Vin; TestPoint_Pad_D2.0mm
TP17: VDDD; TestPoint_Pad_D2.0mm
TP18: VBRG_0; TestPoint_Pad_D2.0mm
TP19: V2I_IP; TestPoint_Pad_D2.0mm
TP20: Q_COMP; TestPoint_Pad_D2.0mm
TP21: PWN_OUT; TestPoint_Pad_D2.0mm
TP22: ASK_TST; TestPoint_Pad_D2.0mm
U1: WLC1115-68LQXQ; PG-VQFN-68
U2: SLS32AIA020U2USON10XTMA1; PG-USON-10-2
U3: LMV358AQDGKRQ1; DGK8_TEX

Connections:
/ASK_DEMOD: R18.2, TP3.1 (1_1), U1.19 (ASK_DEMOD), U1.36 (ASK_SEL), U3.7 (OUTB)
/ASK_I_N: C49.2, C50.2, R33.2, R34.1, R36.2, TP19.1 (1_1)
/ASK_I_P: R32.2, R34.2, R35.1
/ASK_N: C47.1, C48.1, R33.1, U1.40 (ASK_N)
/ASK_OUT: R11.1, TP1.1 (1_1), U1.18 (ASK_OUT)
/ASK_P: C46.1, C47.2, R32.1, U1.41 (ASK_P)
/ASK_PEAK: C51.2, D12.1 (K), R37.2, R38.2
/BST1_0: C22.2, D8.1 (K), U1.67 (BST1_0)
/BST1_1: C40.1, D11.1 (K), U1.53 (BST1_1); also elsewhere on the board
/BST2_0: D9.1 (K), U1.9 (BST2_0)
/BST2_1: C39.1, D10.1 (K), U1.43 (BST2_1)
/COIL_SNS: C34.2, C35.2, C36.2, C37.2, C38.2, C52.2, L2.1, R39.2, TP11.1 (1_1)
/HG1_0: Q2.4 (GATE), TP6.1 (1_1), U1.68 (HG1_0)
/HG1_1: Q6.4 (GATE), TP12.1 (1_1), U1.52 (HG1_1)
/HG2_1: Q4.4 (GATE), TP9.1 (1_1), U1.44 (HG2_1)
/HPI_I2C_SCL: J4.2, R31.1, U1.57 (SWD_CLK/GPIO10)
/HPI_I2C_SDA: J4.1, R2.1, U1.56 (SWD_DAT/GPIO9)
/IIN_CSN_0: C27.1, C28.1, Q2.5 (DRAIN), Q2.6 (DRAIN), Q2.7 (DRAIN), Q2.8 (DRAIN), R22.2, U1.66 (CSNI_0)
/IOUT_CSN_0: C29.1, C30.1, C31.1, C32.1, Q4.5 (DRAIN), Q4.6 (DRAIN), Q4.7 (DRAIN), Q4.8 (DRAIN), Q6.5 (DRAIN), Q6.6 (DRAIN), Q6.7 (DRAIN), Q6.8 (DRAIN), R23.2, R28.1, U1.46 (VBB_1)
/IOUT_CSP_0: C23.1, C24.1, C25.1, C26.1, L1.2, R9.1, R23.1, R27.1, R29.1, R30.1, TP18.1 (1_1)
/LG1_0: Q3.4 (GATE), TP7.1 (1_1), U1.2 (LG1_0)
/LG1_1: Q7.4 (GATE), TP13.1 (1_1), U1.50 (LG1_1)
/LG2_1: Q5.4 (GATE), TP10.1 (1_1), U1.47 (LG2_1)
/NFet Control: Q1.4 (GATE), U1.35 (NFET_CTRL_1)
/OPTIGA_I2C_INT: R19.2, U1.33 (RES_SEC), U2.9 (RST)
/OPTIGA_I2C_SCL: R20.2, U1.30 (SCL_SEC), U2.8 (SCL)
/OPTIGA_I2C_SDA: R21.2, U1.29 (SDA_SEC), U2.3 (SDA)
/Q_COMP: Q8.2 (S), R43.2, TP20.1 (1_1), U1.32 (QCOMP2), U1.37 (QCOMP1)
/SW1_0: C22.1, L1.1, Q2.1 (SOURCE), Q2.2 (SOURCE), Q2.3 (SOURCE), Q3.5 (DRAIN), Q3.6 (DRAIN), Q3.7 (DRAIN), Q3.8 (DRAIN), TP8.1 (1_1), U1.1 (SW1_0)
/SW1_1: C40.2, C41.1, L2.2, Q6.1 (SOURCE), Q6.2 (SOURCE), Q6.3 (SOURCE), Q7.5 (DRAIN), Q7.6 (DRAIN), Q7.7 (DRAIN), Q7.8 (DRAIN), TP15.1 (1_1), U1.51 (SW1_1); also elsewhere on the board
/SW2_1: C33.1, C34.1, C35.1, C36.1, C37.1, C38.1, C39.2, Q4.1 (SOURCE), Q4.2 (SOURCE), Q4.3 (SOURCE), Q5.5 (DRAIN), Q5.6 (DRAIN), Q5.7 (DRAIN), Q5.8 (DRAIN), TP14.1 (1_1), U1.45 (SW2_1)
/Vin: C42.2, C43.2, R25.2, TP16.1 (1_1), U1.61 (VIN)
/XRES: J4.3, U1.28 (*XRES)
/toESP: R4.1, U1.59 (GPIO12)
COMM: R4.2, R5.1
GND: C1.2, C3.1, C4.1, C5.1, C6.1, C7.1, C8.1, C9.2, C10.2, C12.2, C13.2, C14.1, C16.1, C17.2, C18.1, C19.2, C20.2, C21.2, C23.2, C24.2, C25.2, C26.2, C27.2, C28.2, C29.2, C30.2, C31.2, C32.2, C42.1, C43.1, C44.1, C45.1, C46.2, C48.2, C49.1, C51.1, C53.2, C54.2, C55.1, C56.1, C57.1, C58.1, D13.1 (ANODE), J1.2, J4.4, Q3.1 (SOURCE), Q3.2 (SOURCE), Q3.3 (SOURCE), Q5.1 (SOURCE), Q5.2 (SOURCE), Q5.3 (SOURCE), Q7.1 (SOURCE), Q7.2 (SOURCE), Q7.3 (SOURCE), R3.2, R5.2, R6.1, R7.1, R8.1, R15.2, R24.2, R36.1, R38.1, R42.2, U1.3 (PGND_0), U1.34 (GND), U1.49 (PGND_1), U1.64 (GND), U1.69 (EPAD), U2.1 (GND), U2.11 (EPAD), U3.4 (V-)
unnamed: C4.2, R1.1
unnamed: C9.1, R10.2, TP22.1 (1_1)
unnamed: C10.1, C11.1, R11.2
unnamed: C33.2, R3.1
unnamed: C41.2, R24.1
unnamed: C44.2, C45.2, R26.2, TP17.1 (1_1), U1.63 (VDDD)
unnamed: C50.1, R37.1
unnamed: C52.1, R40.1
unnamed: D1.2 (A), U1.26 (LED1)
unnamed: D1.1 (K), R6.2
unnamed: D2.2 (A), U1.27 (LED2)
unnamed: D2.1 (K), R7.2
unnamed: C11.2, D5.1 (A), D6.2 (C), R13.1
unnamed: C12.1, D5.2 (C), D6.1 (A), R12.2, R14.1, U3.3 (+INA)
unnamed: C19.1, D7.2 (A), J4.5
unnamed: D12.2 (A), R39.1
unnamed: D13.3 (A_/_C), R40.2, R41.1
unnamed: J1.1, U1.31 (UART/GPIO7)
unnamed: J3.1 (Pin_1_1), U1.58 (TEMP_FB)
unnamed: Q8.3 (D), R41.2, R42.1, R43.1
unnamed: R10.1, U1.42 (ASK_TST)
unnamed: C3.2, R1.2, U1.10 (COMP)
unnamed: C2.2, R28.2, U1.12 (CSNO)
unnamed: C2.1, R27.2, U1.11 (CSPO)
unnamed: TP21.1 (1_1), U1.20 (PWM_IN1), U1.21 (PWM_IN2), U1.22 (PWM_OUT)
unnamed: R8.2, U1.7 (SW2_0)
unnamed: R9.2, U1.6 (VBB_0)
unnamed: C7.2, R29.2, U1.13 (VBRG)
unnamed: C8.2, R30.2, U1.14 (VBRG_DIS)
unnamed: C1.1, U1.62 (VCCD)
unnamed: C16.2, R17.2, R18.1, U3.5 (+INB)
unnamed: C14.2, C15.1, R13.2, R16.1, U3.2 (-INA)
unnamed: C13.1, R14.2, R15.1, TP4.1 (1_1), U3.6 (-INB)
unnamed: C15.2, R16.2, R17.1, TP2.1 (1_1), U3.1 (OUTA)
PVIN_0: C20.1, C21.1, C53.1, C54.1, R22.1, R25.1, TP5.1 (1_1), U1.38 (BB_IN), U1.39 (VBUS_IN), U1.65 (CSPI_0)
VBB: Q1.1 (SOURCE), Q1.2 (SOURCE), Q1.3 (SOURCE)
VBUS: Q1.5 (DRAIN), Q1.6 (DRAIN), Q1.7 (DRAIN), Q1.8 (DRAIN)
VDDD: C5.2, C6.2, C17.1, C18.2, C55.2, C56.2, C57.2, C58.2, D7.1 (K), D8.2 (A), D9.2 (A), D10.2 (A), D11.2 (A), D13.2 (CATHODE), Q8.1 (G), R2.2, R12.1, R19.1, R20.1, R21.1, R26.1, R31.2, R35.2, U1.4 (PVDD_0), U1.25 (VDDD), U1.48 (PVDD_1), U2.10 (VCC), U3.8 (V+)

Notes on the sheet:
Optiga Security Chip
Full Bridge Inverter
ASK Demodulation
IC -> ESP
Programming Connector
Q Estimate
Buck Convertor
Power NFet
Power In

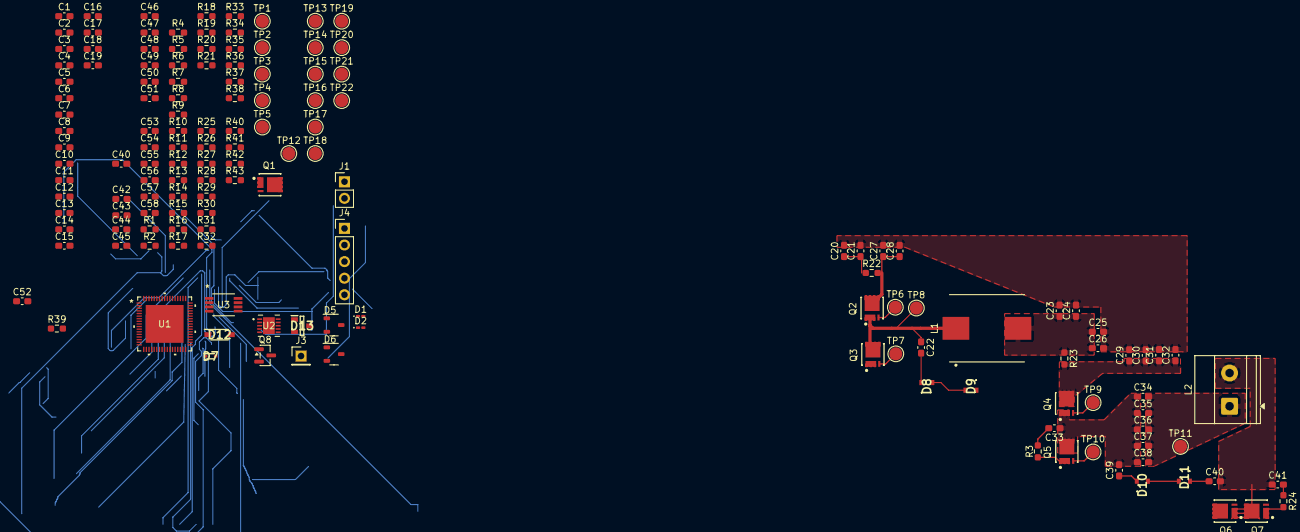
[picture p51: board project.kicad_pcb from above]

Board: 2 copper layers, 151 parts (0 on the bottom side), 74 nets.

Other parts of the board:
C40#2: 0.1u; C_0603_1608Metric_Pad1.08x0.95mm_HandSolder

Their connections:
/BST1_1: C40#2.1; also elsewhere on the board
/SW1_1: C40#2.2; also elsewhere on the board
