niruvibes/elec3117proj/(commit log)

2026-07-13 started schem
    [project.kicad_sch]
2026-07-14 added reference doc
    [project.kicad_sch]
2026-07-16 fixing remote
    [project.kicad_sch]
2026-07-16 fixed some things
    [project.kicad_sch]
2026-07-16 added provided gerber
    [project.kicad_sch]
2026-07-17 starting pcb
    [project.kicad_pcb, project.kicad_sch]
2026-07-18 idk what im doing
    [REF_WLC_TX15W_C1-MP A11 15W POWER TRANSMITTER REV05 BOM.xlsx, nc_param.txt, project.kicad_pcb, project.kicad_sch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]
2026-07-19 before work
    [project.kicad_sch]
2026-07-20 i am almost done
    [project.kicad_sch]
2026-07-20 am i done
    [project.kicad_sch]
2026-07-21 should be actaully done now brah
    [bom.csv, designators.csv, positions.csv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]
2026-07-21 done final final actual final
    [digikey_purchase_checklist.xlsx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]
2026-07-21 added bom
    [digikey_purchase_checklist.xlsx]
